Yu20040207/pathfinder_robot/firmware/esp32s3_motor_pulse/README.md

# D157B 单电机短脉冲验收

2026-10-16 重新装配后，用户在双轮 10 秒悬空测试中观察到左右轮均向后转。已把前进映射改为左轮 AIN1、右轮 BIN2；反向映射为左轮 AIN2、右轮 BIN1。方向单元测试、ESP-IDF 编译和烧录通过；在 12 V 断开时，串口 `x`、`z`、`r` 验证正常。以下 2026-10-15 的物理方向记录仅适用于重新装配前，不应再作为当前方向依据。

2026-10-16 新映射带电悬空 1 秒双轮前进测试已由用户确认两轮均向前并正常停下。三次重复测试的 4 倍频编码器计数：左轮 -1574/-1437/-1558，右轮 +1223/+1237/+1246，skipped 均为 0。单独左轮前进 500 ms 得到 A=-440、B=0；单独右轮反转 500 ms 得到 A=0、B=-433，skipped 均为 0。停机并清零后静置 3 秒，两路保持 0。当前前进计数符号为左负右正。重复测试计数差异反映开环 PWM 下转速/起转状态差异，不能据此断定左右轮机械性能。

2026-10-16 用户分别手动将轮胎朝前进方向转动一整圈：左轮 A=-1468、B=0，右轮 A=0、B=+1468；两次 skipped 均为 0。按当前接线和 4 倍频解码，实测每个驱动轮为 1468 计数/轮圈。前进方向的有符号轮圈数为左轮 `-A/1468`、右轮 `B/1468`。用户随后给出轮子周长约 210 mm、左右驱动轮中心距约 263 mm；以此作初始参数，每计数约 0.1431 mm。地面滚动有效周长和转弯等效轮距仍需行驶标定，不能直接作为精准里程计。再次拆装编码器线或更换减速电机后应复测计数方向和每圈计数。

反向手转各一整圈复核：左轮 A=+1451，右轮 B=-1464，skipped 均为 0。符号与前进相反；相对于 1468 计数/圈分别相差 17 和 4 个计数，属于手动停在标记位置的可见误差范围。当前两侧编码器通道、方向和每圈计数已完成悬空基础验证；地面滚动轮径、轮距、闭环速度控制和里程计仍未标定。

2026-10-15 悬空实测：`1`（Motor A，IN1，50% PWM，500 ms）使左轮后退；`3`（Motor B，IN1，50% PWM，500 ms）使右轮前进。两次测试的串口均打印 `STOP after 500 ms PWM diagnostic`，随后又发送了 `x` 停机命令。尚未验证反向控制、编码器反馈或负载下运行；后续控制映射应以机器人前进方向为准，不能把两侧同一 IN1 电平直接视为同一行驶方向。

方向测试固件新增 `5`（左轮 AIN2，50% PWM，500 ms）和 `6`（右轮 BIN2，50% PWM，500 ms）。两路 IN1/IN2 均由 PWM 通道控制；每次测试前后四路占空比全部清零。同一电机的 IN1 和 IN2 不会同时给出非零占空比。方向映射依据上述悬空观察，仍需用 `5`/`6` 实测复核。

2026-10-15 反向测试：`5` 已确认左轮向前转并正常停下；`6` 已确认右轮向后转并正常停下。串口均显示 500 ms 后停机。编码器尚未接线，GPIO8–11 为悬空输入，日志中出现的计数与 skipped 数字是噪声，不能用于轮速或方向判断。

新增 `t` 双轮前进悬空测试：左轮 AIN2、右轮 BIN1 同时以 10 kHz PWM 从 0 升至 50%，再降至 0，全程 4 秒；每 100 ms 更新一次，结束时四路控制输出清零。运行中发送 `x` 可在下一次 100 ms 更新时提前停机。2026-10-15 已在驱动板 12 V 关闭状态下验证完整运行约 4 秒和 `x` 提前停机约 0.1 秒；带电双轮实测另行记录。没有编码器反馈，因此这里的“加速/减速”仅指 PWM 占空比变化，不能保证轮速按相同比例变化。

2026-10-15 新增大写 `T`：相同的双轮前进渐变，时长延长至 15 秒，最高仍为 50% PWM，`x` 同样可提前停机。驱动板 12 V 关闭时的串口验证显示 15.00 秒自动停机。小写 `t` 保留为 4 秒版本。

带电悬空实测：`T` 的 0→50%→0 渐变中只有左轮起转；右轮单独 50% 的 500 ms 脉冲可以起转，双轮同时恒定 50% 的 1 秒诊断命令 `u` 也使两轮起转。说明缓慢爬升到 50% 不足以保证右轮从静止起转，不能把原 `T` 当作可靠的双轮起转测试。

新增大写 `V`：15 秒双轮测试，先以 50% PWM 保持 1 秒起转，然后在 1 秒内降到约 40%，用 12 秒在约 40%↔50% 间升降，最后 1 秒降到 0。驱动板 12 V 关闭时串口验证 15.00 秒自动停机；带电悬空实测中用户确认两轮持续向前转并正常停下。该结论仅适用于悬空样机；没有编码器、负载和电流数据，不能推断地面行驶速度、力矩或续航。

上电后四个控制输出保持低电平，不自动转动。USB 串口输入 `a` 或 `b`，分别对 Motor_A 或 Motor_B 的 IN1 给出一次 10 kHz、约 25% 占空比、5 秒 PWM，然后自动停机并等待至少一秒。IN2 始终为低电平。输入 `x` 会再次置零，但 5 秒运行期间主循环不处理新命令；异常时应直接切断电机电源。若 PWM 占空比较低而电机不转，不要持续重复命令或增加占空比，应先检查电源、接线与电机电流。

故障诊断命令 `c` / `d`：分别对 Motor_A / Motor_B 的 IN1 给出一次 500 ms 近似持续高电平（IN2 保持低电平），随后自动停机。用于与驱动板上手动将 AIN1/BIN1 接 3.3 V、AIN2/BIN2 接 GND 的测试对照。电机空载、输出轴无遮挡且供电可立即切断时才执行；每次只发送一次，不连续重复。

起步占空比诊断命令 `1`/`2` 对 Motor_A 的 AIN1 输出 50%/75%，`3`/`4` 对 Motor_B 的 BIN1 输出 50%/75%；`5` 对左轮 AIN2、`6` 对右轮 BIN2 输出 50%。均为 10 kHz、500 ms，随后自动停机。一次只测一档，观察轴上标记的转动与停止。该测试只能判断是否起转；未读取编码器，不能得出准确 RPM，也不能用于载车运行。

## 编码器测试预留（电平转换板到货后再烧录并接线）

D157B 的 E1A/E1B/E2A/E2B 实测有 4.9 V 高电平，**不能直接接 ESP32-S3 GPIO**。用户提供的商品图为一块四路 HV/LV 双向转换板（看起来是四路 MOSFET 加上拉电阻结构，商家标称最高稳定通信速率 28800 bps）；最终接线前以收到的实物丝印和万用表测量复核。HV 接 D157B 5V，LV 接 ESP32-S3 3V3，GND 与两板公共地连接；四路高压侧接编码器输出，配对的低压侧接 ESP32-S3 输入：

| D157B 信号 | 转换板通道 | ESP32-S3 输入 |
| --- | --- | --- |
| E1A | HV1→LV1 | GPIO8 |
| E1B | HV2→LV2 | GPIO9 |
| E2A | HV3→LV3 | GPIO10 |
| E2B | HV4→LV4 | GPIO11 |

通电时先不接四根 LV 输出到 ESP32，用万用表测转换板 LV 侧高电平不超过 3.3 V、低电平接近 0 V；确认后断电再接 GPIO。不要将 D157B 的 5V 接到 ESP32 的 3V3，也不要用转换板给电机供电。布线短、远离电机动力线。该类 MOSFET 转换板原本常用于 I²C 等信号；商家标称的 28800 bps 不能证明它在本机编码器线束下不会丢边沿。先手转、再悬空低速、最后在悬空最高测试转速检查计数与 skipped，若出现明显漏计或噪声，应换适合编码器脉冲的单向缓冲方案。

固件用 A/B 两相的每次有效跳变计数（4 倍频）；串口输入 `r` 显示 A/B 累积计数和跳变异常数，输入 `z` 清零。短脉冲后也会打印计数。正负号需按实际轮子安装方向标定。此阶段只验证脉冲和方向，尚未根据实际减速比、编码器 PPR 与轮径标定 RPM/里程计；不要把这些原始计数当作准确位移。

烧录时 D157B 电源断开、开关关闭；运行前车轮悬空、12 V 输入极性经过万用表核对，并可立即切断电源。ESP32-S3 USB 单独供电、两板共地。这个固件只做短时空载验收，没有编码器闭环和独立硬件急停，不能驱动车体在地面行走。

```bash
source /home/manbaout/esp/esp-idf/export.sh
idf.py set-target esp32s3 build
idf.py -p /dev/serial/by-id/usb-Espressif_USB_JTAG_serial_debug_unit_90:70:69:F7:F0:B0-if00 flash monitor
```

监视器打开后输入 `a` 或 `b` 并按回车；观察对应电机是否只转约 5 秒及串口的 `STOP after 5000 ms`。按 `Ctrl+]` 退出监视器。通电前先在电机电源断开的情况下验证程序会识别命令并自动停止。
