Yu20040207/pathfinder_robot/firmware/esp32s3_base_control/README.md

# ESP32-S3 悬空轮速闭环验收

此固件用于 D157B AT8236 驱动板与两个编码器驱动轮的悬空调试。旧的 `esp32s3_motor_pulse` 固件保留用于回退。60 mm/s 的前进和后退悬空闭环测试已通过；仍需下地负载标定，不接 Nav2。

## 已标定的接口

- GPIO4/5：左电机 AIN1/AIN2，AIN1 为前进。
- GPIO6/7：右电机 BIN1/BIN2，BIN2 为前进。
- GPIO8/9：左编码器 A/B；GPIO10/11：右编码器 A/B，经 3.3 V 电平转换接入。
- 前进时原始编码器左负右正，控制器内部统一转换为前进正速度。
- 初始周长 210 mm、每圈 1468 个 4 倍频计数；轮距 263 mm 在上位机里程计中使用。

## 控制和保护

独立 FreeRTOS 控制任务每 20 ms 采样编码器并更新 PWM。串口处理和日志不会主动阻塞该任务。轮速采用低通滤波、前馈加 PI；目标轮速限制为 ±100 mm/s，加速度限制 150 mm/s²，PWM 限制 50%。静止起步时最多给一次 200 ms、50% PWM 起转脉冲；编码器检测到轮速后提前退出。微小反向读数不再跳过起转脉冲。正常控制时 PWM 上升率限制 1/s、下降率限制 0.2/s；停机与故障直接清零。正反转切换先降至零，等待低速后再换向。

有效 `v` 命令超过 300 ms 未刷新时，关闭两路电机输出；`x` 和零速度命令在下一控制周期关闭输出。这里“停止”表示 PWM 清零、驱动输入低，车轮可能因惯性滑行，并不代表机械刹停。上电不运动。故障保持锁定，需要停止状态下显式 `c` 清除或重启后才能重新运行。

故障码：1 无脉冲（连续 `v` 轮速控制在 PWM≥30% 后约 0.45 s；诊断模式另有各自时限）；2 转向反馈反向超过约 0.2 s；3 测得轮速超过 300 mm/s 持续约 0.1 s；4 单周期超过 8 次无效编码器跳变；5 控制周期异常（运动时周期大于 100 ms）；6 跟踪偏差。这些阈值是初始值，仍需带载实测。软件保护不替代电源开关/独立硬件急停，也不包含电流、温度检测；控制任务自身停滞或 MCU 硬件故障仍需硬件切断电机供电。

## 串口协议

115200、8N1、USB Serial/JTAG。新固件先发送 `?`，必须读到 `BASE_CONTROL_V2` 才能由实机桥接发送速度数字；旧脉冲固件会把数字当作原始 PWM 命令。兼容的 `bench.py` 也识别历史 V1 固件。新 `S2` 状态行包含 ESP 单调微秒、两轮计数与跳变数、速度、目标、PWM、运动位和故障码；旧 `S` 行暂保留给已有诊断脚本。

- `v 60 60\n`：左右轮目标各 +60 mm/s，需要持续刷新，推荐 10 Hz。
- `v -40 -40\n`：左右轮目标各 -40 mm/s。
- `x`：停止，无需换行。
- `c`：仅在停止状态清除故障，不会自动启动。
- `s`：输出状态；默认也每 100 ms 输出状态。
- `r`：兼容只读 `/wheel/odom` 节点的编码器报告。

状态格式：`S uptime_us raw_left raw_right measured_left_mm_s measured_right_mm_s setpoint_left setpoint_right pwm_left pwm_right active fault`。

超出范围、非有限数、格式错误命令均不启动电机；输入行超过 79 字节或组帧超过 200 ms 时停止并丢弃到下一行。不要同时运行串口监视器、轮式里程计节点和测试脚本。

## 构建与有界测试

烧录时先断开驱动板 12 V，仅保留控制器 USB 供电。

```bash
source /home/manbaout/esp/esp-idf/export.sh
idf.py -C firmware/esp32s3_base_control build
idf.py -C firmware/esp32s3_base_control -p /dev/serial/by-id/usb-Espressif_USB_JTAG_serial_debug_unit_90:70:69:F7:F0:B0-if00 flash
```

在项目根目录运行，默认 `inspect` 只验证版本和停止状态。`run` 会发出运动命令，须先确认车轮悬空且可立即断电。

```bash
python3 firmware/esp32s3_base_control/tools/bench.py --action inspect
python3 firmware/esp32s3_base_control/tools/bench.py --action run --left 60 --right 60 --seconds 3 --csv /tmp/base-forward.csv
python3 firmware/esp32s3_base_control/tools/bench.py --action timeout --left 60 --right 60 --seconds 1 --csv /tmp/base-timeout.csv
```

脚本限制持续时间为 0.1–10 秒，结束后检查 `active=0` 且 PWM=0；`timeout` 模式在运行阶段结束后停止刷新指令，以验证控制器自行超时关闭输出。脚本异常退出时发送 `x`，遥测超过 0.5 秒无响应时中止。CSV 保存本次状态用于调参。新固件版本识别失败时不会发送速度命令。

测试核心：

```bash
cc -std=c11 -Wall -Wextra -Werror -I firmware/esp32s3_base_control/main firmware/esp32s3_base_control/tests/test_control.c firmware/esp32s3_base_control/main/control.c firmware/esp32s3_base_control/main/protocol.c -lm -o /tmp/fwr_base_test
/tmp/fwr_base_test
```

## 2026-10-16 验证进度

- 主机控制核心测试通过，含不同电机增益的简化闭环仿真、速度限制、立即停止、超时关闭、无反馈锁定、方向错误、超速、无效边沿和控制时序异常。该模型测试不代表实际电机已完成调参。
- ESP-IDF 构建和烧录通过；用户已确认烧录时驱动板 12 V 关闭。
- 实机无电机供电：启动与查询均 PWM=0、active=0、fault=0；停止刷新短速度指令后 active 和两路 PWM 归零。
- 实机无电机供电：持续给速度指令时触发 fault=1（无脉冲），两路 PWM=0；随后查询仍保持故障锁定，显式清除后恢复停止状态。
- 实机无电机供电：`x`、`v nan 0`、`v 101 0` 均验证输出关闭。
- 首次带电 60 mm/s 测试中，两轮实际未起转，遥测两侧计数基本不变；控制器在约 1 秒时锁定故障 1 并使两路 PWM 归零。用户确认两轮未转。旧诊断固件的瞬时 50% PWM 曾使两轮起转，因此增加有界起转脉冲。
- 起转脉冲版主机测试、构建、烧录及无 12 V 的超时停机测试通过；带电效果尚待确认。闭环跟踪、反向控制和带电超时关闭未完成；目前不进行下地测试。
- 起转脉冲版第二次带电 60 mm/s 测试：右编码器从 -2 增至 +275，右轮速度约 50 mm/s；左编码器仅从 +1 到 -17 后保持不变。左轮 PWM 后续达到 50%，约 1.6 秒时 fault=1 锁定且两路输出归零。需要区分左电机未转、机械卡滞或电连接问题；未验证双轮稳定闭环。
- 用户要求复测后，在同样 60 mm/s、2 秒上限条件下再次观察到：左计数 -18 到 -86 后停止，右计数 +279 到 +491；左 PWM 后续约 49.5% 时仍无计数，故障 1 再次锁定并停止两路。CSV：`/tmp/fwr-base-powered-boost-repeat-60.csv`。重复故障需要检查左轮实际运动、机械阻力、电机供电和编码器接线，不应继续反复加电尝试。
- 对照厂商《电机驱动模块使用手册—AT8236》（2025-08-27）：D157B 的 AT8236 VREF 接板上 3.3 V；`PWM,0` 是支持的正转快衰减控制；手册推荐 PWM 10 kHz，当前程序即 10 kHz。板上电机供电标称 5.5–17 V，12 V 在范围内。两轮最终一同停下是故障保护动作，不能由此推断两侧驱动芯片同时失效。下一步先断电比较两轮机械阻力和左侧连接，再做有界单轮诊断。
- 断电后临时烧录旧短脉冲程序，左轮前进 50% PWM 运行 0.5 秒：左编码器 -297，右 0，无无效跳变。左电机及编码器在固定 PWM 下正常。闭环失速更可能是控制输出快速下降及电机起转/维持转动阈值造成。
- 曾按手册尝试慢衰减接法；一次带电 60 mm/s 测试中右轮测得约 400 mm/s，约 0.3 秒触发超速故障 3，两路输出归零。该模式已从代码撤回，待断电后重新烧录快衰减版本。CSV：`/tmp/fwr-base-slow-powered-60.csv`。
- 已恢复快衰减接法。修复原代码用微小反向编码器噪声判定“正在倒转”并跳过左轮起转脉冲的问题；新测试中左右轮都以 50% PWM 起转。但在 80 mm/s、1.5 秒测试中，输出快速降至约 28% 后两轮速度明显下降，尚未稳定。现将正常控制的 PWM 下降率从 1/s 调整为 0.2/s；主机测试、烧录及无电机供电的超时停机验证通过，带电验证待完成。
- PWM 下降率调整后的 80 mm/s 带电测试中，两路 PWM 均达到 50%，但原始编码器计数从 0 到 0，约 0.8 秒后故障 1 自动停机。该结果与之前两轮能起转不一致。下一步先用万用表直接在 D157B 的 VIN+/VIN− 端子确认电机电源，不应继续凭软件遥测假定驱动板已供电。CSV：`/tmp/fwr-base-slowdown-powered-80.csv`。
- 用户确认该次两轮零计数测试时驱动板实际未接电；万用表之后确认 VIN+/VIN− 约 12 V。供电确认后的 80 mm/s、3 秒悬空测试两轮持续运动、无故障并正常停机；带电断联测试也确认超时关断。
- 60 mm/s 悬空测试曾有约 15–100 mm/s 的振荡，因此将前馈改为 `0.22+0.0017*目标速度(mm/s)`、比例系数改为 0.0012、积分系数改为 0.0015。新固件主机测试、ESP-IDF 构建和烧录通过。
- 新参数在 VIN+/VIN− 实测约 12 V 下：前进 60 mm/s 持续 5 秒，最后 10 个运动采样平均左 59.39、右 59.78 mm/s，标准差分别 1.92 和 0.68 mm/s，故障 0，停止后 PWM 0。CSV：`/tmp/fwr-base-gain-powered-60.csv`。
- 后退 60 mm/s 持续 5 秒，最后 10 个运动采样平均左 -59.76、右 -59.84 mm/s；一前一后原地转向 3 秒成功；带电停止刷新指令的超时停机测试通过，最终两路 PWM 0、故障 0。CSV 分别是 `/tmp/fwr-base-gain-powered-reverse-60.csv`、`/tmp/fwr-base-gain-powered-turn-60.csv`、`/tmp/fwr-base-gain-powered-timeout-60.csv`。这些是双轮悬空结果，不代表下地后仍有相同速度精度。
- 用户要求再试方向后，前进 60 mm/s 首段故障：右轮正常计数，左轮在约 0.8 秒内无计数，左 PWM 至约 50%，保护停机。随后的左轮单独 60 mm/s 测试也基本无计数并触发故障 1。CSV：`/tmp/fwr-base-confirm-forward.csv`、`/tmp/fwr-base-left-only-60.csv`。因此左侧故障具有间歇性，之前的成功不能视作可靠验收；已停止继续电机测试，优先断电检查左电机 6 针插头、电机线和 A 路连接。
- 用户未发现插头明显松动，随后断电临时烧录固定 PWM 诊断程序；确认 VIN+/VIN− 约 12 V 后再次仅驱动左轮 50% PWM、0.5 秒，编码器 A=-92、B=+2、无跳变，与先前同样测试的 A=-297 差异明显。当前设备运行临时诊断固件 `esp32s3_motor_pulse`；尚需根据目视动作和进一步电气检查确认左轮原因，并在完成后断电恢复 `esp32s3_base_control`。
- 用户断开 12 V 与 USB 后，将两只已标记的 6 针电机插头在 Motor_A/Motor_B 之间互换，重新接 USB 并实测 VIN+/VIN− 约 12 V。临时诊断固件对 A 路执行 50% PWM、0.5 秒，编码器 A=-409、B=0；对 B 路同样执行，编码器 A=0、B=-421。互换后的两条驱动路径均能驱动所接电机并获得编码器计数。
- 用户断电并将标记的插头恢复原位，重新测得 VIN+/VIN− 约 12 V。A 路 50% PWM、0.5 秒首次计数 A=-440；随后三次计数分别为 -383、-411、-458，B=0，均自动停机。插拔后左侧表现改善，支持接插件接触问题的可能性，但尚不能确认根因；还需恢复闭环固件并进行带失速保护的短时复测。
- 已在 12 V 关闭时重新烧录 `esp32s3_base_control`；无电机供电查询得到 active=0、PWM=0、fault=0。恢复供电并实测 VIN+/VIN− 约 12 V 后，连续三次双轮前进 60 mm/s、2 秒，以及一次 60 mm/s、5 秒悬空测试均 fault=0，测试后输出归零。5 秒测试末段均值左 59.33、右 58.53 mm/s。CSV：`/tmp/fwr-base-reseat-forward-{1,2,3}.csv`、`/tmp/fwr-base-reseat-forward-5s.csv`。当前烧录固件是闭环 `esp32s3_base_control`。先前左轮间歇性无计数未再现，但尚不能确定是插头接触还是其它原因；这些结果仅用于悬空验证。
- 首次下地 60 mm/s、1 秒测试中两轮没有移动，左计数不变、右计数仅增加 4；约 0.8 秒触发失速故障 1，输出自动归零。用户随后实测 VIN+/VIN− 约 12 V。重新将双轮悬空、清故障后相同测试中右计数从 -18 增至 +445、左计数始终为 9，约 0.8 秒再次触发失速故障 1。这表明左侧间歇性无运动/无编码器反馈再次出现，下地负载不是唯一原因。CSV：`/tmp/fwr-ground-first-forward.csv`、`/tmp/fwr-ground-recheck-air.csv`。用户已关闭 12 V 并检查压紧左轮 6 针插头，未发现明显松脱；在故障定位前不要继续下地测试。
- 断电测电机两端电阻：用户报告左 15.7 Ω、右 10 Ω；未提供转动一圈时的电阻范围，单次差异不能确认故障。用户将两只电机插头恢复原位。先在驱动板 12 V 关闭时手转左轮，编码器不变；万用表确认板上 3.3 V 当时为 0，故该次手转不具诊断意义。重新接通 12 V、板上 3.3 V 正常后，手转左轮一圈，计数从 10 到 -2174，表明编码器在当时能工作。随后两次 60 mm/s、1 秒悬空测试左右均计数、无故障。CSV：`/tmp/fwr-air-after-handturn.csv`、`/tmp/fwr-air-after-handturn-repeat.csv`。
- 再次下地 60 mm/s、1 秒测试 fault=0，但左右仅短暂有少量计数，之后均停止；用户看到整车不移动，仅听到电流声。控制器记录起转时约 50% PWM，之后 42–45% PWM，末段实测轮速接近 0。CSV：`/tmp/fwr-ground-second-forward.csv`。目前需核对实物电机额定电压/型号、12 V 带载电压和机械阻力。项目旧选型文档记录 24 V 电机，但尚未确认当前实物是否该型号；不能在当前 D157B 上擅自提高供电电压。下地测试尚未通过。
- 用户提供《轮趣直流有刷电机产品说明手册（尺寸、参数、线序）_2026.07.28-1.pdf》并确认实物型号 MG513X。手册表 2-1：MG513X 为 12 V、1:28、额定 0.36 A、堵转 3.2 A、额定扭矩 1.02 kg·cm、堵转扭矩 4.5 kg·cm、4 W；MG513XL 是另一款 12 V、额定 1 A、额定扭矩 3 kg·cm 的电机。故上条旧选型文档的 24 V 假设不适用于当前实物。当前 12 V 是正确的额定电压；50% PWM 起转限制、带载电压跌落、脚轮/底盘阻力和左侧间歇性故障仍需分别核查。
- 使用临时短脉冲固件在地面分别给 Motor_A、Motor_B 75% PWM、0.5 秒：A 编码器 -913、B 被动 +179，用户确认车身向右转；B 编码器 -1396，用户确认车身转动且无异常。因此两只电机在地面负载下均有能力驱动车身；无法将先前不动直接归因于电机损坏。
- 第一版闭环起步直接施加 75% PWM，悬空 0.5 秒测试约 0.3 秒触发超速故障 3，记录左右最高约 469/410 mm/s，保护停车。已改为从 50% 起在尚未达到 15 mm/s 时逐步升至最多 75%，主机测试、构建、烧录通过。悬空 0.5 秒及 2 秒测试 fault=0、最终 PWM=0。CSV：`/tmp/fwr-boost75-air-05.csv`、`/tmp/fwr-adaptive75-air-05.csv`、`/tmp/fwr-adaptive75-air-2s.csv`。
- 渐增起步版地面 60 mm/s、1 秒测试两轮计数、车身前进略有跑偏、fault=0；2 秒测试中约 1.3 秒后两轮停住，用户确认先走后停。100 mm/s、2 秒测试同样先走后停。记录显示 PWM 降到约 40% 后速度骤降，之后提升 PWM 太慢，尽管 fault=0，地面持续行驶仍未通过。CSV：`/tmp/fwr-adaptive75-ground-1s.csv`、`/tmp/fwr-adaptive75-ground-2s.csv`、`/tmp/fwr-adaptive75-ground-100-2s.csv`。
- 针对上述现象，控制逻辑改为实际速度低于目标时不再继续降低 PWM，并在速度误差超过 20 mm/s 时加快 PWM 回升。主机测试先验证旧逻辑失败，随后新逻辑通过；ESP-IDF 构建通过。**截至此条记录，新版本尚未烧录，设备仍运行上一版渐增起步固件。**下一步在 12 V 关闭时烧录，然后悬空与地面短测。
- 用户明确要求保持 12 V 接通烧录。烧录前确认 active=0、PWM=0、fault=0，带电烧录成功；重启后再次确认三者均为 0。新逻辑地面 60 mm/s、1 秒测试两轮计数接近（左约 -1054、右约 +1040），fault=0、输出归零；2 秒测试仍在约 1.2 秒后停止，PWM 降至左 38.4%、右 39.6% 时两轮低于目标且继续减速，随后保持/提高 PWM 未能及时重新起转。CSV：`/tmp/fwr-hold-duty-ground-1s.csv`、`/tmp/fwr-hold-duty-ground-2s.csv`。因此新版本已烧录但**地面持续低速运行未通过**，不能用于自主导航。需要验证较高的可持续目标速度或调整电机/驱动配置，避免继续在当前 60 mm/s 条件下重复测试。
- 同一固件地面 100 mm/s、2 秒测试仍先走后停，左、右轮在 PWM 降到约 40% 后速度持续下降；PWM 回升到约 56% 时也未恢复。用户观察车身稍向右偏。CSV：`/tmp/fwr-hold-duty-ground-100-2s.csv`。
- 2026-10-17：增加仅前进的固定占空比诊断命令 `d L R`（0–0.65），保留失速、反向、超速、编码器、通信超时和立即停机保护；测试脚本限制该模式最长 2 秒。主机测试和 ESP-IDF 构建通过，已烧录，重启后确认停机、故障码 0。地面 50%、1 秒诊断首次仅有少量计数随后失速故障 1；重复时两轮计数完全不变，再次故障 1。地面 65%、1 秒诊断两轮持续计数，左轮速度一度超过 300 mm/s 保护线，在约 0.9 秒触发超速故障 3 并停机。CSV：`/tmp/fwr-ground-fixed-050.csv`、`/tmp/fwr-ground-fixed-050-repeat.csv`、`/tmp/fwr-ground-fixed-065.csv`。当前控制器**停机且故障锁定 3**；不要直接用此参数导航。
- 用户固定 2.5 kg 配重后，清除故障并完成地面 60% 固定 PWM、1 秒短测：两轮速度逐步升到约 125 mm/s，计数接近，fault=0，结束后输出为 0。CSV：`/tmp/fwr-ground-ballast-2500g-fixed-060.csv`。这只证明一次短时直行可带动当前配重；尚未验证 2 秒以上持续运行、转向、坡道、带载电压和整机总质量。当前固件停机且故障码 0。不要将固定 PWM 诊断命令用于导航。
- 同样 2.5 kg 配重和 60% 固定 PWM 再做 1 秒，用户确认持续前进并正常停下，fault=0；随后做 2 秒测试，末段左右速度约 130 mm/s 且相近，结束后 active=0、两路 PWM=0、fault=0。CSV：`/tmp/fwr-ground-ballast-2500g-fixed-060-repeat.csv`、`/tmp/fwr-ground-ballast-2500g-fixed-060-2s.csv`。2 秒测试的车身动作仍待用户确认；尚未验证闭环控制、转向、长期运行、温升、满载与坡道。
- 同条件 2 秒再次测试，末段两轮约 145–150 mm/s、fault=0、停机输出归零；用户确认车身持续前进并正常停下。CSV：`/tmp/fwr-ground-ballast-2500g-fixed-060-2s-repeat.csv`。因此 2.5 kg 附加配重的短时固定 PWM 直行已通过，但闭环低速、带载转向、长时间运行及最终整机重量尚未验证。
- 2.5 kg 配重、左右固定 PWM 55%/60%、1 秒低幅度转向诊断：两轮均持续计数、fault=0、按时停机；但末段左轮约 115 mm/s、右轮约 96 mm/s，右轮给更高 PWM 却比左轮慢，不能据此认为预期转向已通过。CSV：`/tmp/fwr-ground-ballast-2500g-turn-055-060.csv`。等待用户确认实际车身转向与打滑情况，再排查左右负载/输出差异。
- 用户观察上次车身轻微向右转，与左轮更快一致。反向对照 60%/55%、1 秒时左轮持续约 120–130 mm/s，右轮 55% 仅零星计数、接近静止；fault=0、按时停机。CSV：`/tmp/fwr-ground-ballast-2500g-turn-060-055.csv`。说明右侧在 2.5 kg 配重下 55% 固定 PWM 不足以持续转动，固定 PWM 差速转向尚不可靠。故障码 0 不代表动作符合命令；用户车身观察待确认。
- 用户确认 60%/55% 这次车身明显向右转，符合左轮持续推动、右轮几乎不动的编码器记录。接下来应把左右轮均维持在能可靠转动的占空比范围，通过更高一侧形成速度差，并同时验证闭环速度与停滞检测；在完成之前不启用自主导航。
- 2.5 kg 配重下的对称差速诊断：左/右 PWM 60%/65%、1 秒，两轮均持续转动，末段左约 135、右约 181 mm/s，用户确认向左转且正常停下；左/右 65%/60%、1 秒，两轮均持续转动，末段左约 193、右约 158 mm/s，fault=0、自动停机，用户车身观察待确认。CSV：`/tmp/fwr-ground-ballast-2500g-turn-060-065.csv`、`/tmp/fwr-ground-ballast-2500g-turn-065-060.csv`。这支持在当前配重下两侧输出都保持约 60% 以上时形成左右速度差，但并不代表闭环或更重整机已通过。
- 用户确认 65%/60% 为大半径轻微右转，符合左右速度差约 35 mm/s。经用户确认方案，新增独立的带载诊断闭环命令 `b L R`（仅前进，150–200 mm/s，PWM 限在 60%–65%，不改变原 `v` 导航命令），并增加低轮速停滞保护。主机测试、ESP-IDF 构建与烧录通过；首次 160/160 mm/s、1 秒地面测试两轮计数几乎相同、fault=0，用户确认持续前进且正常停下。CSV：`/tmp/fwr-ground-ballast-2500g-loaded-160-160-1s.csv`。
- 同一诊断模式 150/190 mm/s、1 秒预期左转测试中，左右轮实际速度几乎相等（末段约 195/193 mm/s），用户确认车身基本直行，故闭环转向**未通过**。左轮 60% 最低输出仍使其高于 150 mm/s 目标，说明当前起转下限阻止该模式实现小半径转向。CSV：`/tmp/fwr-ground-ballast-2500g-loaded-150-190-1s.csv`。随后增加 `BASE_TRACKING=6`：带载模式在起步宽限后持续偏离目标超过 40 mm/s 达 0.4 秒就锁定故障并停机，主机测试先失败后通过、ESP-IDF 构建和烧录通过，重启后确认 active=0、PWM=0、fault=0。此安全修正尚未再次做带电测试。当前 `b` 仅为诊断，不用于导航；完整闭环转向尚未实现。
- 2.5 kg 配重下复测 `b 150 190` 验证跟踪保护：两轮实际速度仍接近，约 0.7 秒触发故障码 6、active=0、两路 PWM=0；复查仍保持故障锁定。CSV：`/tmp/fwr-ground-ballast-2500g-loaded-150-190-tracking.csv`。该保护已在实机验证，但转向能力没有改善。当前设备停机且故障锁定 6；在确定整机重量与硬件方案前不继续自动导航测试。
- 用户决定先实现当前硬件功能、暂缓整机重量选型。新增独立的 `a D` 速度差转向诊断（D=右轮减左轮速度，限 ±50 mm/s）：慢侧保持 60% PWM，快侧由编码器速度差反馈在 60%–65% 间调节；持续接近零轮速、错误方向、超速、速度差跟踪失败、通信超时均停机。原 `v` 和 `b` 命令未改。主机测试覆盖左/右转方向、无响应时跟踪故障、响应模型、立即停机和协议解析；ESP-IDF 构建、烧录通过，重启后 active=0、PWM=0、fault=0。**实车转向效果尚未验证**，当前 `a` 仅为诊断命令，不用于导航。
- 2.5 kg 配重下 `a 35`、1 秒测试：末段右轮约 246、左轮约 218 mm/s，速度差约 28 mm/s、fault=0、正常停机；用户观察车身基本直行。当前速度差只能形成大半径弧线，不能满足狭窄空间内转向。CSV：`/tmp/fwr-ground-ballast-2500g-arc-plus35-1s.csv`。
- 为探测较小半径转向，固定 PWM 左 0%、右 60%、0.5 秒：右轮仅少量计数、左轮 0，用户观察车身稍微左转；fault=0、正常停机。CSV：`/tmp/fwr-ground-ballast-2500g-coast-left-060right-05s.csv`。单侧推动车身在当前配重下效果很弱，不应继续以接近堵转的方式加长试验。复查 active=0、两路 PWM=0、fault=0。当前硬件下短时直行和大半径轻微转向可实现；小半径/原地转向及导航尚未通过。
- 2.5 kg 配重、地面、现有 `v` 闭环指令进行左右各 0.5 秒双轮反向测试。左转命令左 -100、右 +100 mm/s：用户确认明显左转且无异常，但左轮仅 +22 编码器计数（倒转速度末段约 -8 mm/s），右轮 +449 计数；左轮倒转近乎停滞，这**不是**可靠的双轮原地转向。右转命令左 +100、右 -100 mm/s：用户确认明显右转并正常停下；两轮分别 -520、-250 计数，末段约 +92/-85 mm/s。两次均按时停机、fault=0。CSV：`/tmp/fwr-ground-ballast-2500g-counterrotate-100-05s.csv`、`/tmp/fwr-ground-ballast-2500g-counterrotate-right-100-05s.csv`。左轮倒转受载异常需进一步定位；不应据此开放自主导航。
- 将双轮架空、保持配重与接线不变，重复左 -100、右 +100 mm/s、0.5 秒：末段左轮约 -150、右轮约 +130 mm/s，左右均正常计数并按时停机，fault=0。CSV：`/tmp/fwr-suspended-ballast-counterrotate-left-100-05s.csv`。因此左轮倒转的控制通道与编码器在空载时可工作；地面左轮倒转近停滞更可能与落地负载、轮胎摩擦、重心或机械干涉相关。不能仅凭本次定位到具体硬件根因；下一步在断开运动命令的条件下检查左轮周边是否蹭壳，以及四轮着地和配重分布。
- 静止检查中用户未见左轮蹭壳、线束干涉，手推左右阻力相近。随后 2.5 kg 配重地面双轮后退各 0.5 秒两次：第一次末段左/右约 -81/-81 mm/s，第二次约 -53/-54 mm/s；fault=0、自动停机。用户确认第二次车身实际后退，但底盘向右摆。CSV：`/tmp/fwr-ground-ballast-2500g-reverse-both-100-05s.csv`、`/tmp/fwr-ground-ballast-2500g-reverse-both-100-05s-repeat.csv`。因此左轮倒转并非在所有地面动作中失效，原地左转时的近停滞属于特定受载条件；右摆需结合 IMU 与地面轨迹进一步定量。
- IMU 固定后，在 2.5 kg 配重地面进行三次 0.5 秒后退联测，均自动停机、fault=0。左/右目标分别 -100/-100、-80/-100、-60/-100 mm/s；按 210 mm 周长、1468 计数/圈和 263 mm 轮距换算的编码器航向增量分别 +3.77°、+2.43°、+0.81°，IMU 四元数测得 +3.74°、+2.43°、+0.86°。第一次实际左/右位移约 -80.7/-63.4 mm，证明车尾右摆对应车头逆时针偏转，主要是两轮实际位移差；减小左轮倒退目标使短时偏摆减小。三组动作行驶距离不同，-60/-100 仅为临时诊断输入，还需在同一起始位置重复并记录视觉观察，不能直接作为长时闭环/导航参数。CSV：`/tmp/fwr-ground-reverse-imu-motor.csv`、`/tmp/fwr-ground-reverse-imu.csv`、`/tmp/fwr-ground-reverse-80-100-motor.csv`、`/tmp/fwr-ground-reverse-80-100-imu.csv`、`/tmp/fwr-ground-reverse-60-100-motor.csv`、`/tmp/fwr-ground-reverse-60-100-imu.csv`。
- 用户复位后重复 -60/-100 mm/s、0.5 秒，偏摆反向：IMU -2.60°、编码器按左右位移约 -71.4/-85.0 mm 换算 -2.96°，fault=0、自动停机。两次同命令实际 PWM/轮速不同，说明固定目标速度比例在当前起步阶段并不稳定，**不能把 -60/-100 作为补偿标定**。现有 `v` 控制以约 0.5–0.75 起转脉冲启动，目标速度以 150 mm/s² 爬升，PWM 下降限速 0.2/s 且低于目标时保持前次输出；短时 0.5 秒命令的实际速度主要受起转和地面摩擦支配。下一步应采用编码器同步的带载短时诊断，IMU 用于独立验证航向，不继续猜固定左右目标比例。CSV：`/tmp/fwr-ground-reverse-60-100-repeat-motor.csv`、`/tmp/fwr-ground-reverse-60-100-repeat-imu.csv`。
- 新增独立诊断指令 `y -1`（后退）或 `y 1`（前进）：两轮从 60% PWM 起步，仅按编码器测得的轮速差提高较慢一侧，最高 65%。指令需持续刷新，300 ms 未刷新即两轮停机；保留编码器异常、失速、反向、超速及跟踪偏差故障锁定。`bench.py --action sync --direction -1 --seconds 0.5 --csv ...` 提供最多 1 秒的自动停机测试。该模式不接入导航，实际地面效果还需 IMU 联测验证。
- 首次悬空 `y -1`、0.5 秒：自动停机、fault=0，但右轮平均后退速度约 186 mm/s、左轮约 170 mm/s，左轮补偿未追平。首次地面 0.5 秒：IMU 航向约 -1.72°，编码器位移左 -25.2、右 -33.9 mm，推算约 -1.90°；按时停机、fault=0。将同步比例系数从 0.0005 提至 0.002 后重复地面 0.5 秒：IMU -2.26°，编码器左 -41.6、右 -53.5 mm，推算 -2.59°；左 PWM 最后约 63.8%、右 60%，偏差未改善。当前证据不支持把该模式用于导航；两次距离、摩擦及起步状态也不同，不能把增益变化视为唯一原因。CSV：`/tmp/fwr-sync-reverse-suspended-05s.csv`、`/tmp/fwr-sync-reverse-ground-05s.csv`、`/tmp/fwr-sync-reverse-ground-gain2-05s.csv`。
- 同一增益、地面 1 秒后退：IMU 约 -3.48°，编码器从首个采样到完全停止的位移左约 -142.5、右约 -159.8 mm，推算航向约 -3.77°。后半秒左右位移差继续扩大；左 PWM 最后约 63.5%、右 60%，未出现故障并按时停机。偏差不只是起步瞬间；在 60%–65% 的同步诊断范围内无法可靠追平左轮，仍须检查负载与更宽输出范围的风险，再决定下一版控制。CSV：`/tmp/fwr-sync-reverse-ground-gain2-1s.csv`。
- 经用户确认，把独立 `y +/-1` 诊断模式改为按两轮**累计编码器位移差**补偿：较慢轮可在 60%–75% PWM 之间以最高 0.5/s 的变化率提高，较快轮至少保持 60%。仍需 300 ms 刷新指令，保留失速、反向、超速、编码器异常、持续跟踪偏差和立即停机保护。已通过主机控制测试、ESP-IDF 构建及烧录；烧录后停机且 fault=0。悬空和地面实测待完成，不能据此启用导航。
- 累计位移差版 `y -1` 首次悬空 0.5 秒：最后运动采样 PWM 左约 63.3%、右 60%，轮速左约 -289、右 -299 mm/s；自动停机、fault=0。悬空末段速度接近超速保护阈值，不延长此类悬空动作。地面首次 0.5 秒：IMU 航向 +0.63°，编码器从首个采样到停止左约 -53.5、右约 -50.5 mm，推算 +0.65°；右轮因落后得到最高约 61.9% PWM，自动停机、fault=0。相较旧版前两次 0.5 秒的负偏航更接近直行，但方向转成轻微左偏，仅一次实测不能证明可重复或可用于导航。CSV：`/tmp/fwr-sync-distance-suspended-05s.csv`、`/tmp/fwr-sync-distance-ground-05s.csv`。
- 用户复位后重复同固件地面 0.5 秒：IMU +1.34°，编码器左约 -52.2、右约 -45.5 mm，推算 +1.46°；右轮 PWM 最后约 63.4%，fault=0、按时停机。用户确认上一次后退基本直行且无异常。这两次均有轻微左偏，仍需判断更长的有界动作中补偿是否收敛；不能据此启用导航。CSV：`/tmp/fwr-sync-distance-ground-05s-repeat.csv`。
- 同固件地面 1 秒后退：IMU 航向 -0.52°，编码器总位移左约 -119.7、右约 -123.1 mm，推算 -0.75°；诊断 PWM 先补右轮、随后补左轮，停止后两路输出 0、fault=0。比旧版 1 秒约 -3.48° 更接近直行，但仍只证明当前配重及地面上的限时后退，不等于前进、转向或 Nav2 导航已验证。CSV：`/tmp/fwr-sync-distance-ground-1s.csv`。
- 同模式地面前进 0.5 秒两次：首次 IMU +0.65°、编码器约 +0.78°；用户目视确认持续前进、基本直行、正常停下且无异常。用户要求立即再试一次，IMU -0.30°、编码器约 -0.19°；两次都自动停机、fault=0。仅为短时前进诊断，不能推断负载变化后的持续巡航精度。CSV：`/tmp/fwr-sync-distance-forward-ground-05s.csv`、`/tmp/fwr-sync-distance-forward-ground-05s-repeat.csv`。
- 新增独立原地转向诊断 `t 1`（左转：左轮后退、右轮前进）和 `t -1`（右转：左轮前进、右轮后退）。两轮按各自运动方向的累计编码器位移同步，PWM 范围 60%–75%，需持续刷新；300 ms 未刷新停机，保留故障锁定。`bench.py --action turn --direction 1 --seconds 0.3 --csv ...` 将地面动作限制在 0.3 秒内。该模式未连接 Nav2。
- 转向悬空各 0.2 秒：左右电机方向正确、自动停机、fault=0。地面左转 0.2 秒首次 IMU +0.79°，重复仅 +0.04°且用户确认车身未动；延长至 0.3 秒仍仅 +0.01°、编码器无有效位移。地面右转 0.3 秒 IMU -4.69°、编码器有反向轮转动、fault=0。驱动板静止 VIN 实测 12.25 V。短时左转起转不可靠，不能将此诊断模式用于导航。记录：`/tmp/fwr-turn-left-ground-02s.csv`、`/tmp/fwr-turn-left-ground-02s-repeat.csv`、`/tmp/fwr-turn-left-ground-03s.csv`、`/tmp/fwr-turn-right-ground-03s.csv`。
- 转向联测暴露反向轮模式中的轮速比较符号错误：同向命令的测试原本覆盖不了相反轮速。新增等速反向轮测试，先复现跟踪故障，再按每轮目标方向计算速度并通过主机测试。重新构建、烧录并确认停机、fault=0。修正后再做 0.3 秒地面左转，IMU +2.04°、两轮有计数、自动停机、fault=0；这与先前两次不动形成起转重复性风险，尚未确认硬件或地面摩擦的根因。记录：`/tmp/fwr-turn-left-ground-postfix-03s.csv`。
- 经用户确认，`t +/-1` 诊断增加起转检查：150 ms 后某轮累计位移仍小于 0.5 mm，短暂将该轮提高到 75% PWM；350 ms 后仍未起步则锁定失速故障，转向位移差超过 8 mm 持续约 100 ms 则锁定跟踪故障，任何持续刷新的转向命令在 500 ms 时也会故障停机。仅 `t` 模式采用这些限制，直行 `y` 模式不变。主机测试覆盖单轮未起步、双轮未起步、等速反向轮和最长运行时间；ESP-IDF 构建、烧录、静止状态检查通过。
- 新版悬空左/右转各 0.2 秒：方向正确、自动停机、fault=0。2.5 kg 配重地面左转 0.4 秒两次，IMU 分别 +3.78°、+5.54°；右转 0.4 秒为 -10.93°；均自动停机、fault=0。两次左转都正常起步，未触发 75% 补偿，故地面尚未验证补偿能解决偶发不起步。相同时间内左右转角明显不对称；用户检查前方两只从动轮均可自由转向且无蹭碰，仍需比较轮胎受力、重心和负载下电机输出，不能据此启用导航。CSV：`/tmp/fwr-turn-boost-left-suspended-02s.csv`、`/tmp/fwr-turn-boost-right-suspended-02s.csv`、`/tmp/fwr-turn-boost-left-ground-04s.csv`、`/tmp/fwr-turn-boost-right-ground-04s.csv`、`/tmp/fwr-turn-boost-left-ground-04s-repeat.csv`。
- 万向轮朝向对照：两只均朝后时，同样 0.4 秒左转 IMU +1.10°、右转 -5.54°；两只均朝前时左转仅 +0.29°。方向一致仍有明显左右差异，不能把万向轮初始朝向认定为唯一原因。朝前左转日志显示轮子只短暂增加数个计数，随后停住；原起转检测只看累计位移，错误地将短暂颤动视为已起步。记录：`/tmp/fwr-turn-casters-back-left-04s.csv`、`/tmp/fwr-turn-casters-back-right-04s.csv`、`/tmp/fwr-turn-casters-forward-left-04s.csv`。
- 经用户确认，改用最近 5 个控制周期（约 100 ms）的轮子位移判断转向起步和失速；“先轻微动一下再停止”的主机回归测试先在旧逻辑下失败、修正后通过。重新构建烧录、悬空左右转各 0.2 秒均正常。地面左转 0.4 秒时左轮后退仅约 7 个原始计数，右轮前进约 31 个；左轮在 75% 补偿下仍停止，控制器锁定 fault=1，双路 PWM=0。IMU 净变化约 +0.95°。这证明失速保护能抓到症状，但未解决左转负载下的动力/阻力问题；不要自动清故障或把该模式接入导航。记录：`/tmp/fwr-turn-recent-left-suspended-02s.csv`、`/tmp/fwr-turn-recent-right-suspended-02s.csv`、`/tmp/fwr-turn-recent-left-ground-04s.csv`。
- 2026-10-20 对照：先在停机状态清除上次 fault=1，左轮单独后退 0.5 秒悬空测试连续两次有编码器计数（约 823、692 个），fault=0、停机后两路 PWM=0；同命令地面 0.3 秒左轮约 97 个计数，最高 PWM 67.5%。地面 `t 1` 左转 0.3 秒左轮后退约 32 个、右轮前进约 52 个原始计数，按 210 mm 周长和 263 mm 轮距推算约 +2.6°；`t -1` 右转 0.3 秒两轮约 113、114 个计数，推算约 -7.1°。两次转向均按时停机且 fault=0；该角度为编码器估算，未同步采集 IMU。左转时两轮均比右转慢，负载/接地条件差异仍未定位，实机键盘及 Nav2 运动门继续关闭。记录：`/tmp/fwr-left-reverse-air-2026-10-20.csv`、`/tmp/fwr-left-reverse-air-repeat-2026-10-20.csv`、`/tmp/fwr-left-reverse-ground-2026-10-20.csv`、`/tmp/fwr-left-turn-ground-2026-10-20.csv`、`/tmp/fwr-right-turn-ground-2026-10-20.csv`。
