Yu20040207/pathfinder_robot/docs/hardware/auto-mapping.md

# 自动探索建图试验说明

状态（2026-10-22）：**双 Collision Monitor 的前进、受限倒车及后侧近障阻断已通过无界面仿真；实机自动运动尚未验收，不能当作无人值守功能。** 已进行人工低速直行、零速停车及单个静止纸箱的前向近障停车测量，尚未运行自动探索命令。

## 工作原理与边界

C1 雷达提供原始 `/scan`。`scan_mapping_filter` 将车尾长期遮挡的原始 −90° 至 +90° 扇区置为 NaN，另发 `/scan_mapping` 给 SLAM Toolbox 和 Nav2 局部、全局代价图；该角度边界须在静止实测中复核。底盘雷达新鲜度门、方向选择器和两路 Collision Monitor 仍读原始 `/scan`。SLAM Toolbox 独占 `/map` 与 `map→odom`，前沿探索器只给 Nav2 发送已知空地中的目标。自动命令经前向或后向 Collision Monitor 和方向选择器后到达 `/cmd_vel_auto_safe`，底盘桥接只订阅这个安全出口；人工键盘另走 `/cmd_vel_manual`。原地转向须同时得到两路监控放行，任一路停车就归零。普通 Nav2 路径不允许倒车；车后遮挡长期存在，实车自动倒车保持关闭，未来增装后向超声波后再单独评估。

车后存在雷达盲区。`/scan_mapping` 被屏蔽的方向是未知区，不代表空地。过滤节点要求前左、正前、前右各 60° 扇区至少一半采样有效（含正常 `+Inf` 无回波）；低于此覆盖率时健康状态为假，自动运动预检拒绝放行。最近走过的路不是实时安全证明；人工键盘后退仍须有人持续目视车尾并能立即断开 12 V。禁止在有人可能突然进入、后方不可见或没有急停手段的场地启用倒车。不要把侧向扫描当作完整后向感知。首张实地图 `real_first_map` 含车体自回波造成的假障碍，仅留作诊断证据；重新建图并核对内部黑点前不用于自动导航验收。

## 接地前填写和检查

| 项目 | 当前配置 | 实测值（现场填写） |
|---|---:|---|
| 最大水平长度 | Nav2 footprint 600 mm；模型碰撞体 520 mm | 520 mm |
| 最大水平宽度 | Nav2 footprint 430 mm；模型碰撞体 350 mm | 350 mm |
| footprint padding | 20 mm | 核对模型 |
| 当前试验负载 | 2.5 kg 配重 | 核对固定 |
| 目标持续速度 | ≤0.06 m/s | 待带载长测 |
| 近障停车距离 | 前停止区距车头约 0.32 m | 单个静止纸箱触发停车后，车头到纸箱实测约 410 mm，里程计续行约 0.9 mm；动态障碍工况未测 |
| 倒车可见区域 | 部分侧后 | 现场检查盲区 |

实物尺寸超出配置值时先增大 Nav2 footprint 和前沿选择器占地范围。实测停车距离超过 0.30 m 时不得开启自动运动，先调整速度、停车区和硬件。检查雷达方向、IMU 固定、线束、驱动板供电、轮胎、前万向轮、场地边界。RViz 应能看到模型、`/scan`、`/map`、TF、局部代价图和碰撞监测区。

## 分阶段验收

1. 静态链路：保持 `motion_enabled=false`，核对 `/scan`、`/imu/data`、`/odom`、`/map`、`map→odom→base_footprint→laser_front`、`/base/fault=0`、Nav2 action 与前后两个 Collision Monitor lifecycle 均为 active，并确认 `/cmd_vel_auto_safe` 仅由 `directional_safety_selector` 发布。注入断流和故障时桥接必须归零。
2. 仿真：在独立 `ROS_DOMAIN_ID` 和 `IGN_PARTITION` 下验证地图增长、目标稳定、障碍前停车与重规划、人工停止；测试完成后确认无剩余速度。仿真启动检查脚本：`python3 scripts/check_auto_mapping_sim.py --domain 98`。
3. 实车单个前进目标：封闭场地、有人看护，已验证单个静止纸箱近障停车；仍须验证动态障碍停车、持续带载直行与目标重规划。目标失败后不得反复冲撞。
4. 受限倒车：车尾全程可见，先单段不超过 0.10 m，再累计不超过 0.30 m。放入新障碍、雷达断流或人为停止时应立即停机；记录实际后退距离和 IMU 偏航。
5. 小范围自动探索：限定约 120 秒和封闭区，监控目标切换、局部路径、故障码、编码器和停车距离。检查地图墙线、门口、障碍形状和轨迹后再考虑扩大区域。

每一步失败都停止升级，保留日志。整机增重、换地面或改变外廓后重新测起步与停距。

## 实车启动命令（尚未运行）

终端 A：

```bash
cd /home/manbaout/Company_Project/Four-wheel-robot
source /opt/ros/humble/setup.bash
source ros2_ws/install/setup.bash
ros2 launch fwr_bringup real_navigation.launch.py
```

终端 B，在测得外廓与停距、试验区封闭且有人持续看护后，填入**实际毫米值**：

```bash
cd /home/manbaout/Company_Project/Four-wheel-robot
./scripts/start_auto_mapping.sh --trial-area-confirmed <最大长度mm> <最大宽度mm> <停车距离mm>
```

启动脚本先保持运动门关闭、启动 Nav2 生命周期并读取雷达/IMU/里程计/地图时间戳、TF、碰撞监测状态、底盘故障和键盘控制状态；所有检查通过才打开运动门，调用 `/base/arm_auto`，然后显式调用 `/explore/start`。串口、传感器或安全指令中断后自动授权锁定关闭，必须重新预检和显式授权。Ctrl+C 或到达 125 秒时调用 `/explore/stop`、关闭运动门并保存时间戳地图到 `~/robot_maps/`。运行中遇到危险，直接切断电机 12 V，不等待脚本退出。

## 验证记录

- 2026-10-23：用户在封闭有人看护的区域完成约 2–3 m 的短距离键盘建图并按 Q 退出，反馈 RViz 行驶轨迹不再出现黑点。核对 `/base_bridge` 的 `motion_enabled=false`、`manual_enabled=false`、`/base/fault=0`、`/scan_mapping/healthy=true`。新地图保存为 `ros2_ws/src/fwr_bringup/maps/real_front_side_map_2026-10-23.yaml` 和同名 PGM（277×478 栅格，0.05 m/像素）；旧图 `real_first_map` 保留作为诊断对照。由于新旧地图范围不同，黑色像素总数不能直接作为质量指标。此项只验收车体回波过滤与人工建图；自动导航、动态障碍绕行与实机自动倒车仍需各自验收。

- 2026-10-23：前/左/右纸箱无动力核对完成，底盘运动门关闭。正前方纸箱在原始和过滤扫描中均为约 0.562 m、前方点数一致；左侧约 0.655 m、右侧约 0.608 m，过滤后最近距离均保持不变。后向车体遮挡回波在三个位置的过滤扫描中均为 0；过滤健康状态为真、底盘故障码 0。静态核对通过；尚须低速行驶重新建图，观察轨迹内黑点是否消失。

- 2026-10-22：人工键盘建成首张实地图并保存为 `ros2_ws/src/fwr_bringup/maps/real_first_map.yaml`（346×241，0.05 m/像素）。RViz 中行驶轨迹上出现断续黑色占据点；静止读取 21 帧 C1 扫描，在按实测雷达外参换算后的底盘 520×350 mm 范围内累计发现 2459 个有效回波，集中在雷达原始约 −40° 至 +40°、距离约 0.13 m 的车尾方向。雷达正在看到底盘自身或车载物并将其反复写进 SLAM 地图；这张图含假障碍，暂不可作为自动导航验收地图。物理清理扫描平面或为建图/代价图加入经验证的车体自遮挡过滤后须重新采图。安全监控仍应使用未经此过滤的原始雷达，后侧盲区不能据此视为可倒车。

- 2026-10-22：排查带载纸箱试验中“电机有声音但车不动”。在电机运动门关闭时记录发现 `/cmd_vel_auto_safe` 63 条中仅 30 条非零，重复指令与新雷达帧交错时被方向选择器交替归零。将相同指令的旧监控输出短暂保持条件改为最多 60 ms；监控明确停车、状态失效、指令变化或超时仍立即归零。修正后无动力记录为 39 条中 34 条非零；方向选择器相关 17 项测试通过。
- 2026-10-22：同一静止纸箱前约 0.567 m 雷达距离、2.5 kg 配重、0.10 m/s 指令的受看护限时短测：底盘行驶约 0.120 m，前向 Collision Monitor 持续停车，停机后里程计续行约 0.9 mm，雷达前方约 0.454 m，车头到纸箱实测约 410 mm，底盘故障码 0、软件运动门已关闭。该结果仅覆盖此次静态纸箱与当前负载；动态障碍停距尚未测量。
- 2026-10-22：首次实车移动纸箱试验。起始前方雷达约 4.77 m；纸箱从侧面拉入时，底盘已行驶约 0.097 m，雷达读数从约 2.54 m 快速跳到 0.195 m，测试脚本因过近立即发零速并关闭运动门；故障码 0，用户估计纸箱离车头约 200 mm。Collision Monitor 日志先报 `front_slow` 后报 `front_stop`；停机后的无动力复核中 `/cmd_vel_auto_safe` 为零。由于障碍物进入时已过近，无法区分监控停车与测试脚本急停的作用，也不能从本次数据推算动态制动距离。后续试验须让障碍物从至少 0.8 m 的前方距离进入并记录监控首次零速时刻，不得将本次记为动态避障通过。

- 2026-10-20：`colcon build --symlink-install --packages-select fwr_interfaces fwr_bringup` 成功。
- 2026-10-21：包测试 `118 passed`；`colcon build --symlink-install --packages-select fwr_interfaces fwr_bringup` 成功；`git diff --check` 与 Python 语法检查通过。
- 2026-10-20：独立域无界面主动探索仿真 10 秒：已知栅格 7423、雷达扫描 152 帧、Nav2 action 可用，底盘约移动 0.23 m，停止后状态 `stopped`，未授权运动为 0。日志：`/tmp/fwr_auto_sim_u7awm7pc.log`。此轮验证了初始探索与人工停止。
- 2026-10-21：仿真使用与实车相同的显式自动授权机制。扫描断流注入后授权锁定关闭、探索停止；恢复扫描不自动续行，日志：`/tmp/fwr_auto_sim_w9swhvsj.log`。
- 2026-10-21：正前方扫描障碍注入后 Collision Monitor 停车，最后一次非零运动指令约在注入后 0.099 秒；日志：`/tmp/fwr_auto_sim_7s0zxl88.log`。这只验证近障停车，未验证绕障重规划。
- 2026-10-21：纯逻辑测试覆盖倒车最多三段许可与累计 0.30 m 预算；尚未做 Gazebo 中的真实倒车轨迹联测。
- 2026-10-21：将虚拟正前方障碍保持 15 秒后仍未触发倒车，Collision Monitor 持续停车，探索状态没有进入 `reversing`；日志：`/tmp/fwr_auto_sim_2yok0847.log`。这不是倒车通过证据；需要单独构造 Nav2 失败且后方已知空闲的场景。
- 2026-10-21：查明 Collision Monitor 连续停车 1 秒后停止发布零速度，底盘命令看门狗因此撤销自动授权。将该停车零速度发布窗口设为 5 秒；仿真在近障保持 3 秒时仍处于授权导航和停车状态（`/tmp/fwr_auto_sim_152v97hl.log`），保持 7 秒则自动撤销授权并停机（`/tmp/fwr_auto_sim_cxwz6w3n.log`）。这为短暂障碍留出有限重规划时间，**尚未证实绕障成功**；正前方过近的障碍会触发固定停车区，不能仅靠增加等待时间绕过。
- 2026-10-21：补测近障保持 3 秒后移开，自动速度恢复输出（`/tmp/fwr_auto_sim_3y1t7y13.log`）；近障保持 7 秒则授权撤销且未自动恢复（`/tmp/fwr_auto_sim_w5xguqtl.log`）。前者只证明清障后继续运动，仍未证明障碍持续存在时能选另一条路。
- 2026-10-21：新增固定目标仿真入口，关闭随机前沿选择器，但保留自动命令门、Collision Monitor 和仿真底盘授权链。命令为 `python3 scripts/check_fixed_goal_reroute_sim.py --domain 145 --timeout 65 --obstacle-y=-0.42`。侧向障碍持续存在时，底盘从 x≈0.05 m 行至 x≈1.10 m，离障碍中心最近 0.652 m，高于保守阈值 0.599 m；期间产生 49 次新路径规划且保持授权（`/tmp/fwr_fixed_reroute_ygjug44a.log`）。同样目标下把障碍放在中心 y=0，则车只行至 x≈0.075 m，Nav2 15 秒后报无法取得进展并安全撤销授权（`/tmp/fwr_fixed_reroute_7cyx668z.log`）。因此仅证实**有足够侧向通道的绕行**，中心阻断仍需解决或判定为不可通行。
- 2026-10-21：修复自动命令门在状态切换时命令与时间戳不同步导致的空对象访问；前沿候选目标排除距车小于 0.50 m 的点，避免 Nav2 到点阈值引发重复派发；仿真进展检查与实机参数一致。仿真扫描断流及持续前障停车回归通过。
- 2026-10-21：倒车触发联测发现两处时间/轨迹问题：Nav2 允许 15 秒才判定失速，而原轨迹只保留 5 秒，Collision Monitor 原先只连续发布 5 秒停车零速度。轨迹保留窗改为 25 秒，停车零速度窗口改为 18 秒，以便失速判定期间仍保持停车和有限授权；超时后仍撤销授权。修复轨迹采样时小于 1 cm 的连续位移被覆盖、永远累计不到采样门槛的问题。复测中 Nav2 已进入恢复决策，但注入的前障碍使已走轨迹的车体扫掠范围不再是实时已知空闲，恢复器拒绝倒车（`/tmp/fwr_auto_sim_gykrsij3.log`，10 个轨迹点）；这**不是倒车成功验证**。此前 7 秒障碍会撤销授权的结果适用于旧 5 秒窗口，不能套用于现配置。实机必须重新验证超时停车与停距后才能开放该功能。
- 2026-10-21：把仿真前障碍从雷达前方 0.25 m 移到 0.40 m，使障碍点落入车前停车区，同时避开当前位置的名义车体圆包络。碰撞监控仍停车，Nav2 15 秒后失败并进入恢复决策，但恢复器检查整段已记录轨迹在 SLAM 地图中的扫掠区域，仍发现并非全部“已知空闲”，因此拒绝倒车（`/tmp/fwr_auto_sim_6y6d8u9v.log`）。目前没有端到端倒车通过证据；下一轮要在后方已被充分扫描、且局部代价图实时空闲的场景验证，不能降低占用/未知栅格门槛来通过测试。
- 2026-10-21：进一步把**仿真**扫描分为建图/Nav2 用的原始 `/scan` 和碰撞监控用的 `/scan_safety`，只在后者注入虚拟前障碍，避免虚拟点随车移动污染已走地图。前方停车与 Nav2 恢复决策正常触发，但已走轨迹在 SLAM 地图里仍未满足整车扫掠区“全部已知空闲”的严格条件，倒车依然被安全拒绝（`/tmp/fwr_auto_sim_a_fzf_zd.log`）。实车继续共用真实 `/scan`，未采用此仿真分路。
- 2026-10-21：增加拒绝原因的栅格位置诊断。复测确认第一个未知格约在地图坐标 `(-0.35, -0.13) m`，位于初始车位后方扫掠区（`/tmp/fwr_auto_sim_wy95s3ou.log`）。当前仿真从初始位置只前进约 0.10 m 就注入障碍，车尾方向尚未取得足够的已知空地，因此严格拒绝倒车是正确结果。下一轮应先让机器人向前建出足够的后方空闲走廊，再在有已知回退轨迹的位置阻挡前方；需同时验证固定前方停车区不会错误拦截安全倒车。
- 当前 Humble 安装的 Collision Monitor 使用固定停车多边形；车头近障进入 `front_stop` 后，原地转向或倒车指令也会被该停车区拦截。不能把短暂障碍移开后的恢复解释成持续障碍绕行。下一项仿真需测试更远处的新障碍是否使 Nav2 重新选路，以及近障倒车是否需要经验证的方向相关停车区；在此之前不开放实车自主脱困。
- 2026-10-21：将前障碍注入门槛提高到从起点直线距离 0.35 m 后，仿真确实注入障碍并在 0.098 秒内停止速度输出；但导航失败后的受限回退因 `track discontinuity` 被拒绝，未发生倒车（`/tmp/fwr_auto_sim_3_xn2ebb.log`）。已给该拒绝原因增加断点距离与两端坐标，单元测试验证了诊断格式。第二次仿真启动后因模拟传感器时间差及过滤命令超时而提前撤销授权，未到达注入门槛（`/tmp/fwr_auto_sim_6m9i28vp.log`）。两次都安全停机；仍须区分地图坐标校正与真实里程计断点，不能放宽连续性阈值来强行倒车。
- 2026-10-21：轨迹改在连续的 `odom` 坐标系记录，回退前用同一个当前 `map←odom` 变换映射整条短轨迹；这避免 SLAM 逐帧修正被误判成行驶轨迹断点。仿真前方停车分别约 0.099 秒（`/tmp/fwr_auto_sim_glm5nq_1.log`）和 0.048 秒（`/tmp/fwr_auto_sim_d6ub387g.log`），原轨迹断点拒绝不再出现。回退仍因旧轨迹端点未知而拒绝，因此改为只使用从当前位置起连续且全部已知空闲、至少 0.05 m 的短后缀，未知区仍不能进入。
- 2026-10-21：仿真障碍注入改按累计行驶距离 0.60 m，而非离起点的直线距离，避免前沿探索转向后漏测。连续两次进入 `reversing`，但记录到安全出口负速度指令为 0、倒车位移为 0（`/tmp/fwr_auto_sim_c8rmojp6.log`、`/tmp/fwr_auto_sim_c527p29o.log`），**不能算倒车通过**。诊断发现一次因局部代价图年龄 0.505 s 超过 0.5 s 门槛而退出；原发布频率仅 2 Hz，已将仿真和实机局部代价图发布频率改为 5 Hz。随后仿真仍由回退控制器主动中止（`/tmp/fwr_auto_sim_ahmq7ray.log`），已补充具体中止原因日志，待下轮复测。实车倒车继续关闭。
- 2026-10-21：核对 Nav2 开源 `Costmap2DPublisher` 的 OccupancyGrid 换算：膨胀区 1–98、贴近障碍区 99、致命障碍 100、未知 -1。局部代价图检查原来把 1–98 也当成障碍；现允许这类非致命膨胀值，但整车扫掠圆仍拒绝 99、100 和未知。复测中控制器发出 8 条负速度原始指令，自动选择器发出 16 条负速度指令，安全出口仍为 0，车没有倒退（`/tmp/fwr_auto_sim_hjyf3yq1.log`）。这确定剩余阻断在 Collision Monitor：固定 `front_stop` 被前方障碍触发后，也会挡住远离它的倒车。需要单独设计并验证按运动方向应用的近障保护，不能直接绕过监控。实车自动倒车仍未验收。
- 2026-10-21：在 Humble 1.1.20 上启动前、后两个独立 Collision Monitor，并由唯一选择器发布 `/cmd_vel_auto_safe`。无障碍自动探索 35 秒到达约 `(0.84, 0.58) m`，正常停止（`/tmp/fwr_auto_sim_ok59txom.log`）。前障碍持续存在时，停车延迟约 0.10 秒，随后倒车累计 0.222 m，最大单段 0.096 m，低于单段 0.10 m 和总计 0.30 m 上限（`/tmp/fwr_auto_sim_l8v8lpnb.log`）。这些是仿真结果，不代表实车盲区安全。
- 2026-10-21：后侧可见区注入障碍时，回退原始指令 9 条，但后向监控、安全出口和底盘倒车指令均为 0，位移为 0（`/tmp/fwr_auto_sim_1k3apddu.log`）。雷达断流后授权锁定关闭且未自动续行（`/tmp/fwr_auto_sim_ssyyyqwt.log`）。固定目标侧向绕障通过：最大 x≈1.10 m，离障碍中心最近 0.638 m，大于 0.599 m 要求，新增规划 58 次（`/tmp/fwr_fixed_reroute_b5d9i3pa.log`）。正中阻断仍会停车并由 Nav2 报无法取得进展，不能宣称所有障碍都可绕过。
- 2026-10-21：倒车场景复测在累计行驶 0.05 m 和 0.25 m 后注入障碍，两次都在 0.15 秒内停车，但恢复器发现返回轨迹的车体扫掠区含未知地图格，拒绝倒车（`/tmp/fwr_auto_sim_f_0mjlg7.log`、`/tmp/fwr_auto_sim_cm017i_x.log`）。这说明是否能倒车取决于返回走廊已知空闲，而非只看前方障碍。仿真验收脚本现要求明确的运动测试时长，并验证注障前确有近期前进动作，防止空测误报通过。当前 140 项包测试、两包构建与两套启动参数检查通过。
- 2026-10-21：把同一场景的注障门槛设为累计行驶 0.60 m 后，已知返回走廊足够，前方在 0.150 秒内停车，随后受限倒车 0.225 m；最大观测单段 0.102 m（编码器采样容差 0.005 m），最终停机且没有未授权运动（`/tmp/fwr_auto_sim_74_il_l7.log`）。早期未知区域仍拒绝倒车；实车制动距离和后方盲区尚未验证，实车自动倒车保持关闭。
- 2026-10-21：实车**静态** ROS 链路已检查，未发运动指令：C1 `/scan` 约 10 Hz、IMU、`/odom`、`/map` 与 `map→base_footprint` 可用；ESP32 串口打开，`/base/fault=0`；前后监控均为 `active`，Nav2 生命周期可激活，`/cmd_vel_auto_safe` 仅由方向选择器发布且实测为零速，`motion_enabled=false`。检查后已停止本次 launch，原有 IMU 节点仍在运行。雷达延时在 8 秒采样内约 0.098–0.101 秒；监控启动时曾出现短暂时间戳差超过 0.25 秒的日志，实车运动前仍需按预检确认实时性。测得外廓和带载停车距离尚未提供，因此没有执行自动运动预检或授权。
- 2026-10-22：人工限时直行测试以 0.10 m/s 指令运行约 1 秒，地面标记实测总位移 60 mm，里程计总位移 61 mm；零速指令后里程计继续约 10 mm，故障码 0，用户确认平顺前进且正常停下。脚本退出后 `motion_enabled=false`、`manual_enabled=false`，测试用 launch 已停止。用户实测底盘外廓 520 × 350 mm，与模型碰撞体一致，Nav2 footprint 保留额外余量。此 10 mm 是人工零速后的里程计值，不是雷达发现障碍到完全停下的实测距离；自动运动预检仍不能把它当作近障停车验收。
- 2026-10-22：用户明确实测 C1 扫描中心距底盘最前沿向后 50 mm、左右居中、离地 75 mm。底盘长 520 mm，故雷达相对底盘几何中心向前 210 mm；当前 URDF 的 `base_link` 离地 32.5 mm，`base_link→laser_front` 更新为 `(0.21, 0, 0.0425) m`，保留已实测的 180° 朝向修正。安装高度很低，仍须核查底盘、万向轮与线束遮挡；不能仅凭 TF 校准宣称后方可避障。
- 2026-10-22：停机状态下只启动 C1，采样 20 帧 `/scan`：前方 45° 扇区最小距离中位数约 1.17 m，未见 0.35 m 内近点；车尾 45° 扇区最小距离中位数约 0.108 m，约 95% 的有效点小于 0.35 m。根据雷达安装位置，这些极近返回可能来自车体、支架或线束，也可能有现场近物；尚未逐一辨别。此结果不证明车尾可见区域安全，实车自动倒车继续关闭。
- 2026-10-22：用户确认雷达后方固定有电池等车载物品，后续还要安装笔记本电脑。后向约 0.1 m 的近点因此须按车载遮挡处理；不能要求移走这些最终会保留的部件来证明倒车安全。已核对 `real_exploration.yaml` 中 `supervised_recovery_enabled: false`，实车自动倒车继续禁用。已走过的轨迹只证明过去通行，无法替代当前后向障碍观测。下一项优先验证前向监控的近障停车；若以后需要自动倒车，须在最终装配状态提供并实测能覆盖车尾扫掠区的后向传感器或重新布置雷达。
- 2026-10-22：前方放纸箱的停机静态扫描共 20 帧：车头 ±22.5° 内最近点约 0.524–0.538 m（雷达起算），全部帧都在前向 `front_slow` 几何区内，共 971 个有效点；`front_stop` 几何区内为 0 点。此位置应减速而非停车，尚未验证监控节点实际输出及接地制动。待纸箱移到车头前约 15–20 cm 后复测停车区。
- 2026-10-22：用户把纸箱移到车头前约 15–20 cm 后，静态 20 帧扫描的车头最近点为 0.220–0.222 m（雷达起算）；每帧有 102–107 个有效点位于 `front_stop` 几何区。仅启动雷达、TF 与前向 Collision Monitor 的软件干运行中，首次缺少 `odom→base_footprint` TF，监控错误地放行模拟 0.10 m/s；补静态 TF 后监控日志报告 `Robot to stop due to front_stop polygon`，但测试订阅者未收到 `/cmd_vel_auto_forward_filtered` 输出，不能据此宣称速度出口已验收。测试没有启动底盘桥接或电机，结束后已停止测试节点。下一步须在隔离环境查明监控输出缺失，并验证零速出口及 TF 缺失时的故障归零，再考虑接地近障制动测试。
- 2026-10-22：进一步在完整静态 TF 存在时重启前向监控，先建立输出订阅，再激活监控并输入模拟 0.10 m/s。监控日志再次报告 `front_stop` 停车，输出采样包含零速；同时也采到初始少量 0.10 m/s，发生于监控首次处理激光数据之前。先前订阅不到输出是因监控已处于持续停车状态，晚订阅者收不到早先的零速消息。故单独的 Collision Monitor 启动瞬间不能当成已验证的故障安全链；下一步要验证前向监控、方向选择器、扫描新鲜度门和底盘桥接串联时，TF/扫描未就绪不会输出运动指令。此轮仍未接电机或测真实障碍到停机距离。
- 2026-10-22：方向选择器增加运行时 TF 门，要求 `odom→base_footprint` 的动态变换时间戳在 0.25 s 内，且 `base_footprint→laser_front` 可用，缺失则持续发布零速。无电机 ROS 联测以模拟监控放行速度验证：缺少 odom TF 时输出只有 0；动态 TF 新鲜时出现预期 0.08 m/s；停止更新 TF 后最后输出回到 0。整包 141 项测试与 `fwr_bringup` 构建通过。这补上运行中 TF 丢失的缺口；仍须验证监控刚激活而扫描尚未处理的窗口，以及实车实际障碍触发后的停车距离，自动运动暂不开放。
- 2026-10-22：选择器进一步要求前、后 Collision Monitor 的 lifecycle 状态持续为 active；状态变化会立即清掉对应监控结果，重新激活后必须有新扫描并稳定 0.30 s 才允许非零输出。使用真实 Nav2 监控进程、合成扫描/TF/指令、没有底盘桥接的端到端干运行：监控未激活且前方有障碍时 10/10 输出为零；激活后前方障碍 23/23 为零；移走合成障碍后 17 次输出中 14 次为 0.08 m/s；前向监控停用时 13/13 为零；重新激活后经过稳定期恢复放行。清空场景有少量零速间隙，可能造成速度轻微顿挫，后续需继续观察；实车自动运动仍未开放，真实停车距离仍未测。
- 2026-10-22：在有人看护、前方放置宽纸箱的封闭场地，执行三次最多 3 s / 0.09 m 的前向受限试验。纸箱初始雷达距离约 0.45 m，停车区静态扫描连续 30 帧均为 0 点，减速区约 51–63 点。第一次指令 0.06 m/s 被 0.4 减速比例压到 0.024 m/s；第二次指令 0.10 m/s、比例 0.7 后，安全出口仍因每次原始指令到达时清空前次监控结果而频繁插入零速，两次地面位移均小于 1 mm，故障码 0。修正同速重复指令的短暂衔接：只允许沿用 0.06 s 内、早于新雷达帧的最近监控结果；指令变化、监控状态失效、新雷达帧、TF 或状态过期仍立即归零。第三次相同试验前进约 29 mm，监控报告 `front_stop` 并持续输出零速；停车时雷达约 0.424 m，随后里程计未继续增加，用户实测车头到纸箱为 385 mm，故障码 0。试验后 `motion_enabled=false`。这验证了此场景的近障停车，但未测动态障碍的最坏制动距离，也不能据此开放无人看护自动建图。配置比例 0.7、选择器测试及整包选定测试 81 项通过。
- 2026-10-22：近障停车后重跑固定目标仿真，首次未起步且产生 29 条路径；定位为新增 TF 门硬编码实车 `base_footprint`，但 Gazebo 底盘坐标为 `base_link`，安全出口始终归零。选择器增加 `base_frame` 参数，实车默认 `base_footprint`，走廊仿真传入 `base_link`。隔离域侧向障碍重测（`python3 scripts/check_fixed_goal_reroute_sim.py --domain 169 --timeout 100 --obstacle-y=-0.42`）通过：注障后新增 49 条路径，离障碍中心最近 0.633 m，高于 0.599 m 阈值，到达障碍另一侧 x≈1.103 m（`/tmp/fwr_fixed_reroute_re2___lt.log`）。正中障碍测试（域 170，`--obstacle-y=0`）未绕过：最高 x≈0.091 m，前向监控报告 `front_stop`，Nav2 最后因无进展取消目标；这属于无可行侧路场景，不能宣称总能重新规划成功。仿真结束时底盘进程已停止，未操作实机电机。
- 2026-10-22：再次启动实机完整导航链，但保持 `motion_enabled=false` 且不发运动命令。C1 `/scan`、`/map`、双 Collision Monitor active、`/base/fault=0` 均确认；Nav2 lifecycle 启动成功，`/bt_navigator` active。以真实外廓 520×350 mm、未知停车距离 `nan` 调用只读 `auto_mapping_preflight`，唯一拒绝理由是停车距离尚未实测，其他门槛均通过。不能把早先人工松键后的 10 mm 续行值冒充动态障碍制动距离；实车自动建图仍待受看护的动态停车距离测试。整包 145 项测试、构建和 `git diff --check` 通过。
- 实车前向近障短时停车已在上述单一纸箱场景验证；自动建图导航、动态障碍、自动倒车和地图保存仍未执行。Gazebo 受限倒车在充分建出的返回走廊通过、未知区正确拒绝；尚需验证串口重连、动态障碍和雷达后侧盲区，实车自动建图启动命令暂不执行。

本页的命令仅适用于已填写并验证的负载、地面、外廓、停距及有人看护的封闭场地。
