Yu20040207/pathfinder_robot/docs/hardware/chassis-drive-selection.md

# 二代底盘驱动方案（待硬件参数定型）

日期：2026-10-05。使用场景暂按室内平整地面、低速运行、进出电梯、上身机械臂按按钮、低功耗考虑。

## 当前采用的方案

2026-10-08 用户确认先采用两驱动轮差速方案；2026-10-10 明确底盘外廓长 52 cm、宽 35 cm、总高 20 cm：左右各一只带编码器的驱动轮，前端左右各一只无动力承重万向脚轮，构成四轮支撑。这里的万向脚轮指轮架可绕竖直轴回转的脚轮，不是带侧向滚子的全向轮或麦克纳姆轮。两台减速电机分别闭环控制左右轮速；软件对外使用 `cmd_vel`、轮速/编码器反馈、`odom` 和 `odom→base_link`。上身工作时限制底盘速度并保持驻车。此方案减少独立驱动路数，平整地面不需要横向平移时更容易调试和维护；Nav2 与 `diff_drive_controller` 都有现成的差速运动接口。**方案已确定为当前实施方向；电机、轮径、脚轮承重和轮子精确安装位置仍待满载数据验证，也不表示可以直接驱动一代硬件。**

2026-10-13 用户指定预览模型使用 **65 mm 驱动轮**；收到的 MG513X STEP 总成带 85 mm 轮，不作为当前轮径依据。下方以 100 mm 轮计算的旧验收示例需要在电机型号和 65 mm 实物参数确定后重算，不能用来判定新轮径方案满足 0.5 m/s 目标。

2026-10-16 用户给出当前样机轮子周长约 **210 mm**、左右驱动轮接地轨迹中心距约 **263 mm**。编码器手转实测两侧均约 **1468 个 4 倍频计数/轮圈**，前进方向左轮计数为负、右轮为正。初始里程换算取 `0.210/1468 ≈ 0.0001431 m/计数`，差速运动学轮距取 `0.263 m`。周长与轮距目前均为近似量，地面直行与原地旋转试验后再校准有效值；旧的 100 mm 轮示例保留作历史方案分析，不适用于当前样机。

基于上述初始参数的只读 ROS 2 验证节点可通过 `ros2 run fwr_bringup wheel_odometry` 启动。它独占 ESP32-S3 串口，每秒查询约 10 次现有 `r` 计数输出，发布 `/wheel/odom`；不会发送电机运动命令，也不发布 `odom→base_link` TF，以免与仿真或其他定位源冲突。参数 `wheel_circumference_m`、`wheel_track_m`、`counts_per_revolution` 和 `device` 可在命令行覆盖。当前发布的协方差故意设得很大，因为地面滑移、有效轮距和轮胎滚动周长仍未标定；暂不供自主导航使用。使用节点期间不要同时打开 ESP-IDF monitor 或其他串口测试脚本。

2026-10-16 只读节点实机验证：静止时 `/wheel/odom` 为零位姿、零速度。用户将左右轮依次朝前进方向各手转一圈后，读得 `x=0.1873 m`、`y=-0.0777 m`，最终 yaw 约 `+0.00054 rad`。按两轮依次各转 0.210 m、轮距 0.263 m 的中点积分，预期约 `x=0.1935 m`、`y=-0.0816 m`、最终 yaw 0；当前偏差可由手动转动终点及近似周长解释。该悬空测试验证计数到 ROS 2 位姿的数据链，不能证明地面定位精度。

| 方案 | 适用条件 | 主要代价 |
| --- | --- | --- |
| 两驱动轮 + 两万向脚轮，差速（当前采用） | 平整地面、低功耗优先；允许先旋转再靠近电梯按钮 | 不能原地横移，需规划转身空间；脚轮与机械臂载荷要做稳定性验证 |
| 四麦克纳姆轮独立驱动 | 电梯间或狭窄通道确实需要横向平移 | 四路驱动及标定；滚子接地和横移增加维护与能耗不确定性 |
| 四轮滑移转向 | 全部车轮需主动牵引、地面允许轮胎滑移 | 原地转向依靠轮胎侧滑，地面摩擦、磨损和功耗需实测 |

## 电气接口建议

样机先用一只底盘前置激光雷达；IMU、轮式里程计与 Nav2 的后续设计见 [底盘激光雷达与导航架构](chassis-lidar-navigation-design.md)。后置雷达是否需要，待实测盲区后决定；当前不接入实机导航。

- 样机阶段先用两台立盛 JGY4632-370-2485（370-8500、77.7:1 档）24 V 蜗轮蜗杆编码器减速电机。卖家参数表标称空载 109 rpm、额定负载 88 rpm / 3.0 kgf·cm / 0.4 A、堵转 8.1 kgf·cm / 2.2 A；堵转值不能作为连续输出能力。驱动器型号和编码器脉冲数尚待核实。
- 每路驱动器需要电流检测与过流/过温故障输出；主控提供通信超时停车，硬件急停要能独立切断驱动使能。每次上电默认不运动。
- ROS 2 主控只发布有时效的速度目标；底层 MCU 执行闭环、限速、故障处理，并回传编码器、驱动电流和故障码。不能把无反馈的 PWM 当作可靠里程计。
- 2026-10-12 确认样机现有控制板为 ESP32-S3，暂无 STM32 板。先由 ESP32-S3 读取左右轮编码器，并承担底盘速度闭环及故障停车；需按实际引脚、采样负载和通信稳定性验证是否够用。后续选用 DM-IMU-L1 成品模块，优先评估由 ROS 2 主机通过 USB 读取，详见[底盘激光雷达与导航架构](chassis-lidar-navigation-design.md)。只有出现经实测确认的接口或实时性瓶颈时，再评估迁移至 STM32；上位机仍使用相同的速度命令、编码器、IMU 数据与故障状态接口。
- 上身机械臂动作期间需要验证重心投影、轮子/随动轮载荷和底盘驻车能力。随动轮布局及轮距必须在外廓与载荷确定后选。

## 样机电机的验收边界

用户给定满载质量 24 kg、目标最高速度约 0.5 m/s、驱动轮直径 100 mm、轮宽 35 mm、坡度小于 2°。100 mm 轮达到 0.5 m/s 需约 95.5 rpm；此电机额定转速 88 rpm 对应约 0.46 m/s。两驱在 2° 坡上仅克服重力分量就需每台约 2.1 kgf·cm；若以滚动阻力系数 0.02 作示例，匀速上坡需每台约 3.3 kgf·cm，已略高于标称额定扭矩。实际滚阻、脚轮转向阻力、起步加速和输出轴承载能力必须实测。因此该型号只作为样机试用，不能据参数表认定满载速度与爬坡目标已满足。

- 分阶段测试：离地校验左右电机方向和编码器；空载低速地面直行、转向、停车；逐步加重到 24 kg，记录速度、两路电流、电机/减速箱温升和脚轮行为；最后在小于 2° 的坡道上重复起步、匀速和停车测试。
- 轮子若直接安装在减速箱输出轴上，先取得厂家允许的径向载荷和轴向载荷数据；不足时改为独立轴承支承轮轴。
- 实机接通语音或自主导航前，完成两路速度闭环、通信失联停车、限速、电流/温度保护与独立硬件急停。未通过满载测试前，将软件限速保持在实测稳定值以下。

## 定型前必须测量或确认

1. 24 kg 满载时的重心、胸口相机/上身/机械臂最大伸出姿态下的倾覆裕量。
2. 轴距/轮距、100 mm 驱动轮的实测滚动半径、目标加速度、最小通道宽度和电梯门槛高度。
3. 每日行驶距离、停机待命时长、电池电压与容量；在地面上测实际行驶电流与峰值电流。
4. 所购电机编码器脉冲数和接线、驱动器及 ESP32-S3 控制板接口、电源板容量、主机与控制板的有线通信协议及急停原理图；若后续迁移 STM32，再核对其接口。
5. 是否必须横向平移到电梯按钮前。若答案为“必须”，重新评估麦克纳姆轮的收益。

## 参考

- [Nav2 控制器与底盘类型](https://docs.nav2.org/rolling/configuration_and_development/tuning_guide/)
- [Nav2 里程计要求与差速控制器](https://docs.nav2.org/jazzy/configuration_and_development/first_time_robot_setup_guide/odom/setup_odom_gz/)
- [TI 带电流检测和故障保护的直流电机驱动器示例](https://www.ti.com/product/DRV8251A)；仅用于列举应评估的保护功能，非本项目定型器件。
