Yu20040207/pathfinder_robot/docs/hardware/esp32s3-smoke-2026-10-13.md

# ESP32-S3 USB 烧录验证（2026-10-13）

- 设备：Espressif USB Serial/JTAG，稳定串口名
  `/dev/serial/by-id/usb-Espressif_USB_JTAG_serial_debug_unit_90:70:69:F7:F0:B0-if00`。
- 芯片：ESP32-S3，revision v0.2，双核，8 MB 内置 PSRAM；Flash 实测 16 MB。
- 先完整读取 16 MB 原始 Flash 到被 Git 忽略的
  `data/firmware-backups/esp32s3-907069f7f0b0-2026-10-13.bin`。
  文件大小 16777216 字节，SHA-256：
  `c0440f814f8ce259ea113d9b688147061d4663717c4cc3dfc20611c016f58a3d`。
- ESP-IDF v5.5.5 编译 `firmware/esp32s3_smoke` 成功，目标 `esp32s3`，Flash 配置 16 MB，
  USB Serial/JTAG 控制台。烧录 bootloader、分区表和应用时，三段均通过写后哈希校验。
- 烧录后串口连续接收到 10 条 `fwr_smoke: heartbeat=6` 至 `heartbeat=15`，约每秒一条。
  说明固件已启动且 USB 串口输出正常。程序不配置电机 GPIO。

本次只验证 ESP32-S3 的识别、Flash 读写和串口运行；电机驱动板、编码器、
供电保护、急停和 ROS 2 通信尚未接线或测试。备份含原始 Flash 内容，应留在本机并妥善保管。
