Yu20040207/pathfinder_robot/docs/hardware/second-gen-cad-preview.md

# 二代底盘 CAD 外观预览

2026-10-13 收到 `第二代3D文件.zip`。压缩包包含 DM-IMU-L1、MG513X 电机、MG513X 加支架、MG513X 加支架及 85 mm 轮、AT8236 D157B 驱动板、C1 雷达的 STEP 文件；没有底盘外壳或整机装配文件。用户随后确定驱动轮直径为 **65 mm**，因此 URDF 不使用压缩包中的 85 mm 轮总成。

`ros2_ws/src/fwr_bringup/description/fwr_chassis_demo.urdf` 保留 0.52 × 0.35 × 0.20 m 的**整体预览外廓**，并把两个驱动轮改为直径 65 mm 的圆柱。为让轮胎在 RViz 中露出，`fwr_chassis_wheel_recesses.stl` 在原尺寸演示外壳两侧、驱动轮位置各切出一个约 90 × 55 × 55 mm 的局部凹槽；前方两个从动轮保持原状。凹槽只是显示预览，底盘 CAD 到位后须按轮胎、悬架和转向空间重做。电机加支架、IMU、驱动板、C1 雷达的外观从 STEP 转成米制 STL，置于同一 `description` 目录。网格仅用于 RViz 外观；碰撞体仍为未开槽的简单包围盒，惯量和质量为预览估值，**不能据此验证实机运动、承载或碰撞间隙**。

| 零件 | URDF 网格 | 状态 |
| --- | --- | --- |
| MG513X 电机加支架 | `mg513x_motor_bracket.stl` | 左右各一件；外观上下翻转 180°；轴线与安装面位置待底盘 CAD 校准 |
| C1 雷达 | `rplidar_c1_cad.stl` | CAD 外观单独旋转 180°，沿用先前实测的 `/scan` 坐标方向；CAD 含电缆，网格总外廓大于雷达头部 |
| DM-IMU-L1 | `dm_imu_l1.stl` | 顶部预览位置，待确定实际安装点和轴向 |
| AT8236 D157B | `at8236_d157b.stl` | 顶部预览位置，待确定安装孔和线束空间 |

所有文件的几何从 STEP 的毫米尺度换算到 URDF 的米尺度。驱动轮宽度仍暂用 35 mm；轮心、万向轮和电子模块坐标仍为预览值。正式用于导航和 Gazebo 动力学前，需要实测轮距、轮心与底盘基准、IMU 轴向、雷达扫描平面高度、整机质量和惯量，并据实物修正碰撞体。现有走廊 Gazebo SDF 使用独立底盘模型，本次 URDF 外观更新不改变其物理参数。
