Yu20040207/pathfinder_robot/docs/superpowers/specs/2026-10-22-front-side-scan-mapping-design.md

# 前方与侧方激光建图设计

日期：2026-10-22。范围：C1 实机扫描到 SLAM、Nav2 代价图的输入；不修改电机控制，不启用实机自动倒车。

## 目标与现场事实

雷达固定在底盘前部，扫描零角朝车尾。车尾的电池、线束以及未来的折叠腰部会长期遮挡扫描平面，不能靠调整安装位置消除。首张实地图的行驶轨迹上出现断续黑点；静止扫描在底盘轮廓内记录到大量距离约 0.13 m、原始角度约 −40° 至 +40° 的回波。这些机器人固定回波不应写进地图。成功标准是静止与行驶时，过滤输出不含车体回波，前方与两侧真实障碍仍能显示，新地图不再沿轨迹留下这类黑点。

## 方案选择

1. **推荐：保留 `/scan` 并另发 `/scan_mapping`，按可见角度屏蔽车尾扇区。** 新节点只改 `ranges` 中被遮挡的采样为 NaN，保持原始时间戳、坐标系、角度索引和采样率；SLAM 与 Nav2 代价图订阅新话题。角度界限是可配置参数，按实测 C1 安装方向核对。这样能分别观察原始扫描和建图扫描，也不会把过滤误认为后方可见。
2. 直接修改雷达驱动输出 `/scan`：消费者改动少，但会隐藏原始回波，降低诊断与安全链的可核查性。
3. 对扫描做完整车体三维模型过滤：未来折叠腰部姿态会改变遮挡，需要关节状态和几何模型；当前只需前方与侧方数据，此方案复杂度过高。

ROS 社区的 [`laser_filters`](https://github.com/ros-perception/laser_filters) 提供 `LaserScan` 角度过滤作为参考。当前工作区未安装 `ros-humble-laser-filters`；实现优先采用项目内一个小型、可测试的 LaserScan 掩码节点，避免增加部署依赖。过滤行为按真实扫描角度索引验证，不直接照搬网上的角度符号。

## 数据流与安全边界

`sllidar_node → /scan` 保持不变。新增过滤节点订阅 `/scan`，输出 `/scan_mapping`。`slam_toolbox` 的 `scan_topic` 和 Nav2 本地、全局障碍层均改为 `/scan_mapping`。RViz 同时显示原始扫描与过滤扫描，便于核对遮挡边界。底盘桥接的雷达新鲜度门和前、后 Collision Monitor 仍订阅原始 `/scan`；不得从过滤后的空白扇区推断该方向空闲。

初始掩码覆盖朝车尾的原始零角附近，保留朝车头的 ±π 附近及可靠侧向。候选边界为原始 −90° 至 +90°，最终以静止扫描和在前、左、右放置纸箱的无动力测试收紧或放宽。设定前必须核对 `laser_front` 的实际方向、角度递增顺序和车体内回波位置。过滤只屏蔽观测，不向地图写入“空闲”；遮挡区应保持未知。对无效角度配置、异常采样元数据、或前左/正前/前右任一 60° 扇区有效采样少于一半，节点报告错误且不发布貌似正常的过滤扫描。正常的 `+Inf` 无回波可以表示该方向未测到障碍，计作有效采样；实机静止扫描三个扇区均有完整采样。下游新鲜度预检须拒绝自动运动。

后向盲区是结构性限制。当前实机自动倒车许可保持关闭；历史轨迹不能证明车尾此刻安全。未来增加后向超声波时，再单独设计传感器位置、覆盖区、测距可信度和与现有近障保护的融合，本设计不预留虚假的后向放行条件。人工键盘后退仍需现场目视和人工急停。

## 实施与验证顺序

1. 用已有实测扫描或合成 `LaserScan` 做单元测试：原始零角遮挡、±π 前方保留、左右侧保留、边界、NaN、元数据不变、异常输入拒绝。静态配置测试确认 SLAM 与两层代价图只读 `/scan_mapping`，安全监控继续读 `/scan`。
2. 在独立 ROS 域运行过滤节点与录制或合成扫描，无电机，比较 `/scan` 和 `/scan_mapping` 的点数、角度、时间戳和采样频率。遮挡扇区的车体回波必须消失，前、左、右箱体必须保留。
3. 更新启动配置后，在实机保持运动门关闭，确认过滤节点、SLAM、代价图和安全监控各自订阅正确话题；拔掉过滤节点或断开原始扫描时，自动运动预检须拒绝放行。
4. 在有人看护、封闭场地进行低速键盘重新建图，保存为新地图文件。对比旧地图轨迹内的黑点；如仍出现，先检查外参、边界和定位，不通过此验收就不开放自动探索。

当前 RViz/建图会话不会热切换扫描话题。实施完成后在明确停机状态重启建图链，保留旧地图作为诊断证据；不在本设计阶段操作真实电机。
