Yu20040207/pathfinder_robot/docs/superpowers/specs/2026-10-23-fixed-goal-navigation-design.md

# 实车单次定点导航设计

## 目标

在已保存地图并完成 AMCL 定位后，允许操作员指定一个短距离目标，让 Nav2 规划和跟踪路径；到达、取消、超时或故障时停车。先完成仿真和实车无动力联通，再单独安排有人看护的地面短测。

## 当前约束

- 现有 `frontier_explorer` 是 `/explore/state` 的唯一正常发布者；`auto_command_gate`、双向 Collision Monitor 选择器和 `base_bridge` 都依赖该状态。
- 直接向 `NavigateToPose` 发目标时，状态仍为 `stopped`，速度会被归零。仿真脚本曾额外发布 `navigating`，此方法只用于仿真验证，不用于实车。
- 底盘 `motion_enabled` 默认关闭；显式 `/base/arm_auto`、新鲜雷达/IMU/里程计、零故障及 Collision Monitor 就绪仍是运动前提。

## 设计

为 `frontier_explorer` 增加 `StartFixedGoal` 服务，输入 `map` 坐标系目标 `x`、`y`、`yaw`，返回接受状态及原因。只在探索停止、没有未结束的 Nav2 goal、地图和里程计新鲜、无故障、非手动模式、底盘已显式 arm 时接收。拒绝非有限坐标或地图外/占据目标。请求由节点自己的 `NavigateToPose` 客户端发送，进入 `navigating` 状态后才允许 Nav2 速度经过原有安全链。

单次模式不选择前沿目标，不自动发送第二个目标，不执行倒车恢复。成功或失败都停止状态发布并取消仍在运行的 goal；`/explore/stop` 同时停止探索和定点模式。保留现有地图/里程计跳变、失联、手动接管、底盘故障和试验时长上限。任何异常默认发布停止状态，自动控制门归零。

初次实车路径最长 0.35 m，操作员在旁可立即切断 12 V。无动力验收时保持 `motion_enabled=false`，验证服务拒绝或只规划、不产生电机输出；带电试验必须另行核对定位、净空和保护状态。

## 验收

1. 单元测试覆盖目标输入/地图占据、忙碌拒绝、到达后不再派发、故障/取消/超时停机。
2. 仿真中由此服务发送定点目标，移入障碍后 Nav2 重新规划，停止/故障时安全输出归零；不再由测试脚本伪造 `/explore/state`。
3. 实车无动力时确认路径规划、状态变化、取消和输出归零；不进行自主行驶。
