Yu20040207/pathfinder_robot/docs/superpowers/specs/2026-10-23-real-rviz-point-navigation-design.md

# 实车 RViz 两点导航设计

## 目标

在已保存的地图上，操作员像仿真时一样依次点击**起点和终点**。点击“开始导航”后，实车先从当前位置行驶到所选起点，确认第一段成功后再行驶到终点。两段都可预览路径；纸箱等新出现的障碍由实时激光代价地图参与规划，运动中仍由现有控制器和近障监控限速、停车。

## 当前事实与约束

- 实车定位界面已有 `/map`、车体、扫描和 **2D Pose Estimate**，但没有受控终点面板。当前激光点与保存地图墙线重合良好；这是一次静止采样，不能代替行驶中的定位验收。
- 仿真 `TwoPointNavPanel` 把任意两次点击解释为两个 `NavigateToPose` 动作：先开往所选起点，再开往终点。用户明确要求实车也采用此顺序。实车当前实际位姿仍由 AMCL 提供，是第一段规划的出发位置；地图上点出的“起点”是第一段要抵达的路点。
- 实车 `frontier_explorer` 的 `StartFixedGoal` 服务负责发送 Nav2 目标并维持探索状态、安全门、超时和故障停机；当前最大目标直线距离为 0.5 m。直接使用 RViz 默认 **Nav2 Goal** 会绕过这个状态入口，虽然底盘运动门可阻止驱动，但会造成 Nav2 目标与实车任务状态不一致。
- 车身使用 0.60 × 0.43 m 的规划轮廓；全局和局部代价地图均订阅 `/scan_mapping`。用户放置纸箱的静态试验中，雷达约 0.91 m 处看到障碍，Nav2 的 `ComputePathToPose` 已规划出绕行路径；还没有完成实车绕行。
- 当前运动门 `/base/auto_armed=false`。选点、预览和下面的无动力验收都不得使电机转动。

## 方案比较

1. **直接复用仿真面板：** 界面相似，但直接发两段 Nav2 动作，第一段可能驶向标记的“起点”，并绕过实车任务状态；不采用。
2. **只用命令行调用现有 0.5 m 服务：** 无需新界面，适合短测，但不能满足地图点选和路线预览；作为调试备用。
3. **把仿真的两点面板部署到实车，切换安全入口：** 保留同一套点击起点、终点、预览和开始的操作；面板在实车模式下改为调用 `frontier_explorer` 管理的两点任务。用户明确选择此方案。实车先维持每段 0.5 m 的试验限距。

## 操作与数据流

1. RViz 使用 `map` 固定坐标系和保存地图。若 AMCL 位姿与实际车位不符，操作员先用 **2D Pose Estimate** 校准，并确认当前激光点与地图轮廓贴合。然后像仿真一样用 **Publish Point** 依次点选起点和终点。车体实际位姿是第一段导航的出发位置。
2. 实车面板用 `ComputePathToPose(use_start=false)` 预览“当前位置→起点”，用 `ComputePathToPose(use_start=true)` 预览“起点→终点”，分别显示两段路径和长度。任一规划失败、点位不在已知可通行区域、定位不可用或两段连接不连续，启动按钮禁用。预览不发送运动命令。
3. 面板重新选点、重新定位、移动底盘、地图/代价地图变化或预览过期后，要求重新预览。UI 预览不是安全授权；后端两点任务入口在启动和第二段派发前复核地图、里程计、激光、IMU、故障、手动接管、运动门和任务忙碌状态。
4. 新增受控的两点任务接口，由 `frontier_explorer` 顺序持有两个目标，沿用现有 Nav2 action 客户端和 `/explore/state` 安全链。第一段**收到 Nav2 成功结果并确认任务仍有效**后才派发第二段；任何失败、取消、故障、超时或安全门撤销均停止整个任务，不自动重试第二段。面板不得在第一段完成回调里直接向 Nav2 发第二段。
5. 操作员明确点击 **开始导航** 后，面板只调用两点任务接口；被拒绝时显示原因，不能退回直接 `NavigateToPose`。**停止** 调用现有 `/explore/stop` 并等待 Nav2 目标终止；底盘故障或状态超时由现有安全链归零。
6. 初期对“当前位置→起点”施加 0.5 m 上限，对“起点→终点”施加 0.3 m 上限。Nav2 第一段有 0.2 m 到点容差；给第二段预留该距离，保证第二段从实际停车位置仍能通过 0.5 m 的派发检查。只做无动力选点/预览与有人看护的短距离行驶。完成直行、转向、停止和动态障碍验收后，另行扩大允许距离；每次扩大前复核实际净空，不把膨胀半径当成物理净空保证。
7. 复用仿真的 `TwoPointNavPanel` 代码与按钮流程，以独立的实车插件类启用受控服务入口；仿真仍走原来的 Nav2 action。实车 RViz 配置加载受控插件，不提供会直达 Nav2 的默认 **Nav2 Goal** 工具。

## 验收顺序

1. 主机测试：两段均规划成功才可开始；第一段失败或取消绝不派发第二段；第一段成功后仅派发一次第二段；两段期间故障、定位跳变、超时或停止均归零。实车面板不直接创建 `NavigateToPose` 动作客户端。
2. 无动力现场：保持 `/base/auto_armed=false`，用当前纸箱验证两段路径预览；点击启动应被安全链拒绝，底盘输出保持零。
3. 有人看护的地面短测：纸箱先移出车道，用首段不超过 0.5 m、次段不超过 0.3 m 的空旷目标验证顺序运动、停机与异常取消；随后在确认实测侧向净空后，才扩大目标距离做纸箱绕行。

## 遗留边界

激光雷达后方会被电池和以后安装的电脑、腰部遮挡；本阶段目标与恢复行为只允许已验证的前进和原地转向，不开放自动倒车。RViz 路径预览、局部代价地图和近障停机各自承担不同作用；任何一项失败都不能由另外一项替代。

## 2026-10-24 修订：单点直达

- 地图上**单击一次**现在表示“从当前位置前往该点”；**连续点击两次**仍是原来的起点/终点两点流程；第三次点击开始新的单点选择。
- 单点预览使用 `ComputePathToPose(use_start=false)` 计算“当前位置→终点”；两点预览仍分两段。
- 实车单点启动仍由面板依次打开运动门、等待 `/base/ready`、申请 `/base/arm_auto`，然后调用已有的 `/explore/start_fixed_goal`（`StartFixedGoal`），不绕过安全链，也不新增 ROS 接口。目标 yaw 取 `map→base_link` 到点击点的方向。
- 两点启动继续调用 `/explore/start_two_point_goal`；原有两点顺序、距离上限和失败停机规则不变。
- 本修订只完成代码、构建和单元测试；单点/两点的实车按钮流程仍需现场人员验证。
