Yu20040207/pathfinder_robot/docs/plans/2026-11-04-auto-mapping-viewpoint-plan.md

# 自动建图改造设计（视点规划 + 半径受限覆盖）

> 状态：**设计阶段，未实施**。用户要求：改造必须**新增文件**，不得修改现有导航的行为树/参数/节点。
> 调研日期：2026-11-04

## 1. 现状：导航是怎么规划的

| 层 | 组件 | 作用 | 关键参数（v1.4，已冻结） |
| --- | --- | --- | --- |
| 全局 | SmacPlanner2D（`GridBased`） | 在全局代价地图上算点到点最小代价路径 | `cost_travel_multiplier 8.0` |
| 局部 | Regulated Pure Pursuit | 取前视点算 v/ω，跟踪全局路径 | `lookahead 0.55`、`rotate_to_heading 0.55` |
| 调度 | BT `RateController` | 每 2 秒重规划整条路径 | `0.5 Hz` |

**要点**：这是"点到点"规划，本身不会覆盖区域；自动建图以前靠**前沿探索**（随机挑已知/未知边界），
因此路径零碎、时间利用率低。

## 2. 实测数据（`real_map_manual_1101`，18.4×22.9 m，自由 164442 格，可行驶 350 m²）

| 方案 | 路径长度 | 预计耗时(0.2 m/s) | 覆盖 |
| --- | --- | --- | --- |
| 面积扫描（每 0.4 m 行距、按房间蛇形） | 891 m | **74 min** | 99.2% 可行驶区 |
| Fields2Cover 单多边形（无分解） | 1950 m | 162 min | 62.5% |
| 视点规划 v1（欧氏直线排序） | 130 m | 12.8 min | 95.2% **穿墙，不可用** |
| **视点规划 v2（真实栅格路径）** | **158.9 m** | **16.8 min** | **95.3%** |

脚本：`/tmp/fwr_runs/grid_rooms.py`、`f2c_cov3.py`、`viewpoint_plan2.py`（临时目录，需要时重建）

### Fields2Cover 评估
- `ros-humble-fields2cover` 2.1.1 已装（需先 `source /opt/ros/humble/setup.bash`，否则 `libortools.so.9` 找不到）
- **梯形分解 `DECOMP_TrapezoidalDecomp` 在本场地图上两次核心转储** → 不可用
- 结论：**不采用**。视点规划不依赖它

### 房间分割评估（重要）
用门洞腐蚀分割房间，在本地图**不可靠**：

| door_closing | 房间数 | 最大房间 | <3 m² 碎块 |
| --- | --- | --- | --- |
| 0.22 m | 6 | 169.8 m² | 2 |
| 0.45 m | 6 | 124.2 m² | 1 |
| 0.70 m | 7 | 98.4 m² | 3 |

房间之间是宽开口（拱门），1.45 m 腐蚀也切不开 → **不能靠"房间标签"判断是否扫完**。

## 3. 设计方案

### 3.1 半径受限覆盖（替代房间标签）

```
R = 4 m
while R 米内还有"未看见且可达"的格子:
    选性价比最高的视点 → 走过去 → 停下扫 3 s → 更新 seen 掩膜
if R 内没有:
    R = 8 m，重复
if R=8 m 仍没有:
    进入"扩展"流程
```

- "未看见"由**射线投射**判定（120 射线、遇墙停、射程 6 m），不是"车经过即算看见"
- 房间尺度 3~6 m ⇒ R=4 m 时视点自然落在本房间 → **自动实现"扫完这间才出门"**
- 无需房间分割

### 3.2 扩展（进新房间）

```
① 找前沿（已知/未知边界）＝门洞
② 目标点必须在【已知区一侧、离边界 0.4 m】
   —— 静态层 track_unknown_space=false，未知格会被当作可通行；
      目标打进未知区会导致"穿未知规划"撞上没探到的墙
③ 到门口停 → 扫一圈 → 门后变已知
④ R 重置为 4 m，回到 3.1
```

### 3.3 终止判据

`R=8 m 内无未看见格` **且** `无可达前沿` → 建图完成。

### 3.4 防卡死

- 同一区域连续 3 次尝试未减少"未看见格" → 标记不可达并跳过
- 沿用已实车验证的**卡住自愈**（`stuck_cancel_s 2.5` + `max_stuck_retries 2`）

### 3.5 性能（能否实时）

| 候选间距 | 射线数 | 候选数 | 单次计算 |
| --- | --- | --- | --- |
| 0.5 m | 180 | 1376 | 32.2 s ❌ |
| 1.0 m | 72 | 333 | **3.3 s ✅** |
| 0.8 m | 120 | 522 | 8.4 s |

结论：**1 m 网格 + 72 射线**，且只在"到点停下扫 3 s"期间计算 → 计算时间被扫圈停顿吃掉。

## 4. 已知问题：路径中途改道（用户反馈"一下左拐一下右拐"）

**机制**：BT 每 2 s 无条件重规划；两条代价接近的通路时，地图噪声/障碍层刷新/位姿微动会让"最优"在两条路之间跳。

**解法（待实施）**：新增**建图专用**行为树 `real_navigate_to_pose_mapping.xml`：

```xml
<Sequence>
  <Inverter><IsPathValid path="{path}"/></Inverter>   <!-- 有效就不重算 -->
  <ComputePathToPose goal="{goal}" path="{path}" planner_id="GridBased"/>
</Sequence>
<FollowPath path="{path}" controller_id="FollowPath"/>
```

`nav2_is_path_valid_condition_bt_node` 本机已确认存在。
**导航用的 `real_navigate_to_pose.xml` 一个字都不改**，只在建图 launch 里指定新 BT。

**验证指标**：`角速度符号翻转次数 / 每 100 m`（历史参考：卡顿时 25 s 内翻转 26 次，正常约 4 次）。

## 5. 实施清单（全部新增文件，不动现有导航）

| # | 新增 | 说明 |
| --- | --- | --- |
| 1 | `fwr_bringup/viewpoint_planner.py` | 半径受限覆盖 + 前沿扩展；只调 `/explore/start_fixed_goal` |
| 2 | `behavior_trees/real_navigate_to_pose_mapping.xml` | 条件重规划，防中途改道 |
| 3 | `config/real_viewpoint_planner.yaml` | 视点规划参数（R、射程、覆盖率目标、终止条件）|
| 4 | `launch/real_auto_mapping.launch.py` 增参数 | 用 `viewpoint_planner:=true` 切换新旧策略，默认关（保证旧行为不变）|
| 5 | 单元测试 | 覆盖：视点选择不穿墙、R 内优先、扩展点落在已知区、终止判据 |

**验收**：导航栈原有用例全过 + 建图跑一趟，指标对比（每 100 m 翻转次数、地图增长速率、总时长）。

## 6. 实施进展（2026-11-04 上午）

### 已写好的文件（全部新增，导航侧零改动）
| 文件 | 内容 |
| --- | --- |
| `fwr_bringup/viewpoint_core.py` | 纯逻辑：自由/障碍/未知掩膜、腐蚀膨胀、BFS 距离、射线可见性（含扇面填充）、视点挑选、前沿与扩展目标、覆盖率 |
| `fwr_bringup/viewpoint_planner.py` | ROS 节点：`enabled` 默认 **False**；只调用 `/explore/start_fixed_goal` |
| `config/real_viewpoint_planner.yaml` | 15 个参数（半径 4→8 m、射程 6 m、射线 180、填充 2、最小收益 400 格、停留 3 s）|
| `test/test_viewpoint_core.py` | 8 项单元测试：射线被墙挡、扇面填充渗透 ≤fill、半径优先、跳过已访问、BFS 绕障、扩展点在已知区、覆盖率 |

### 两个关键 bug（都在仿真里抓出来的）
1. **射线太稀**：72 条射线在 6 m 处间隔 0.5 m，只标记"射线经过的线" → 每跳只增 2% 覆盖。
   修复：射线提到 **180** + 结果做 **2 格膨胀**（模拟雷达扇面）。
2. **把"未知"当成墙**：`if unknown: break` —— 但未知只是"还没记录"，物理上不挡光。
   修复：默认只被**障碍**挡住（`stop_at_unknown=False`）。改正后覆盖率暴涨（65 跳 42% → 25 跳 95%）。

### 仿真结果（增量 SLAM 模拟：未知区随移动逐步揭示）
```
起点已知 15%  →  第5跳 36.9%  →  第15跳 72.5%  →  第20跳 85.4%  →  第25跳 95.3% ✅
总跳数 25，路径 47.8 m
预计实车耗时 ≈ 47.8/0.2 + 25×3s ≈ 5.3 分钟
```

| 方案 | 路径 | 预计耗时 |
| --- | --- | --- |
| 面积扫描（0.4 m 行距） | 891 m | 74 min |
| 视点（静态全图，理想） | 159 m | 17 min |
| **视点（增量 SLAM 仿真）** | **47.8 m / 25 跳** | **≈5.3 min** |

> 静态全图那版路径更长，是因为它必须把整张图的每个角落都规划一遍；
> 真实增量建图中，机器人一边走一边"看到"，路自然短得多。

### 尚待完成
- [ ] 建图 launch 接入（`viewpoint_planner:=true` 才启用，默认关）
- [ ] 建图专用 BT（`real_navigate_to_pose_mapping.xml`，条件重规划防改道）
- [ ] 实车验证：`tools/check_stack.sh` 自检 → 打开开关 → 对比"每 100 m 角速度翻转次数"和地图增长速率

## 7. 行为树实验记录（重要，别再重做）

目标是"减少中途改道"。试过三种写法：

| # | 写法 | 结果 | 结论 |
| --- | --- | --- | --- |
| 1 | `Inverter(IsPathValid) → ComputePathToPose` | **/plan 0 次、位移 0** | 空路径时 IsPathValid 返回 SUCCESS，被反转成 FAILURE → 永不规划 |
| 2 | `Fallback(IsPathValid, ComputePathToPose)` | **/plan 0 次、位移 0** | 空路径被判"有效"，Fallback 走第一条分支 → 永不规划 |
| 3 | **`RateController hz="0.2"` + 原结构** | **/plan 7 次、位移 0.33 m、地图 +2723** ✅ | 采用 |

**核心教训**：Hamble 的 `nav2_is_path_valid_condition_bt_node` 对**空路径**不可靠
（返回"有效"），不能用来做"是否需要规划"的判据。

对照实验（同一份 launch、只切 BT）：
- 原导航 BT（0.5 Hz）：/plan 12 次、位移 2.04 m
- 建图 BT（0.2 Hz）：/plan 7 次、位移 0.33 m、地图 +2723

两者都能跑，建图版重规划更慢 → 改道机会更少。

## 8. 实机跑通（2026-11-04 下午）

### 可用配置（已实测）
```
slam_engine:=slam mapping_bt:=true use_explorer:=false
viewpoint_planner:=true viewpoint_enabled:=true
stuck_reverser:=false kickstart:=false
```
实测：**13 个导航目标全部成功、0 失败**，地图 9500 → 11664 格，每跳前进约 0.88 m。

### 又修掉的 3 个死结
| 问题 | 现象 | 修法 |
| --- | --- | --- |
| 目标太近 | 1 m 内的目标被 Nav2 判"已到达"，走一步就停 | `min_goal_m: 1.2`（视点**和**前沿目标都过滤）|
| 手动起步不可靠 | `/cmd_vel_manual` 被底盘丢弃（`sensors_ready` 间歇为 0）| 起步改用 **Nav2 目标**（`_scan_bootstrap_cell`）|
| 起步被导航目标挡住 | `command_source_allowed`：有目标在跑时手动指令一律丢弃 | 起步前先 `cancel_goal` |

### 参数取值教训
- `bootstrap_max_cells` **4000 可用、20000 反而卡死**：起步要求"目标格已知空闲"，
  门槛设太高时地图太小、找不到合法目标 → 一直空转。
- `dwell_s` 3.0 → **1.0**：3 秒会明显"走一段停一下"。

### 已知未解决
- **走一段停一下**：每跳是一个独立 `NavigateToPose`，Nav2 到点要减速停车，
  加上 dwell 就形成顿挫。下一步：**把 4~6 个视点打包成 `NavigateThroughPoses`**，
  途经点不停车（多点导航已实车验证过这套机制）。

## 9. 滚动续点（用户思路，2026-11-04 下午验证）

用户提的方案：**「在到达第一个视点之前就把第二个算好，续上去，就不会一卡一卡」**。

实现：
```
队列里始终保留 lookahead=3 个点
跑向队首 → 距队首 <0.9 m 视为"已通过"→ 出队
剩余点 <= refill_at(2) → 立刻补一个新点，取消旧目标、用"剩余+新"整条重发
被取消旧目标的回调要忽略（_chaining 标记），否则会被当成失败清空队列
```

实测（20 秒窗口）：**静止帧 0%、前进帧 399/399、位移 3.76 m**（改之前静止 38%~100%）。

### 修掉的两个副作用
| 问题 | 原因 | 修法 |
| --- | --- | --- |
| **房间没扫完就出门** | 续点时"半径限制"算成了相对**上一个点**，链式选点一步步把车带出房间 | 半径判断用**车本身**做锚点（`home_dist`），排序仍用上一点距离（避免 Z 字形）|
| **出门后进不去下一个房间** | 门洞失败后反复重试同一个门 | 失败的门拉黑（0.8 m 内不再选），换下一个门 |

### 待观察
- 门洞宽度是否够（膨胀 0.48 后窄门可能规划不出来）——靠"拉黑 + 换门"绕过，但不是根治
- 房间是否真的扫完才出门：需要看 `home_dist` 锚点后的实际表现
