Yu20040207/pathfinder_robot/docs/superpowers/plans/2026-10-05-differential-demo.md

# 差速底盘离线闭环演示

日期：2026-10-05

## 目标

在 `/demo` 话题空间中让现有地图到路径规划器带动虚拟差速机器人到达目标，验证路径、位姿、速度约束和停止行为。不连接实机串口，不发布 `/cmd_vel`。

## 设计

- 纯 Python `DifferentialPose` 按左右轮线速度积分平面位姿；`WaypointFollower` 按路径点先对准再直行，限制线速度与角速度，到达后输出零速度。该控制器只用于演示，实机路径跟踪将由 Nav2 控制器负责。
- 演示节点发布 `/demo/map`、`/demo/pose` 和 `/demo/goal`，订阅 `/demo/path`；规划节点通过参数重映射到这些话题。合成地图含障碍和通道，启动后能重复运行。
- 演示节点不导出电机速度、不读取串口；所有 `/demo` 话题与实机命名空间隔离。地图、路径变化与目标到达状态在日志中明确显示。

## 验收

1. 先写纯函数测试：直行、旋转、圆弧、速度上限、目标到达及停止。
2. 实现差速积分与路径跟随，并跑测试。
3. 增加演示启动文件，在 ROS 2 中观察 `/demo/path` 和虚拟位姿变化，确认绕障、到点停机。
4. 运行全部测试和构建；README 明确该演示不代表实机可行驶。

## 2026-10-08 验收结果

合成地图与差速运动模型的路线仿真测试覆盖不进入障碍格和到点停止。ROS 2 `navigation_demo.launch.py` 运行时收到 16 点 `/demo/path`，约 29 秒后日志报告到达 `(2.33, 0.67)` m，`/demo/reached` 为 `true`；实际目标是 `(2.375, 0.625)` m，误差在 0.07 m 容差内。话题列表只有 `/demo/*`，没有 `/cmd_vel`。该结果只证明模拟链路，不代表轮胎、地面或实机控制性能。
