Yu20040207/pathfinder_robot/docs/hardware/preview/fwr_chassis_rviz.png

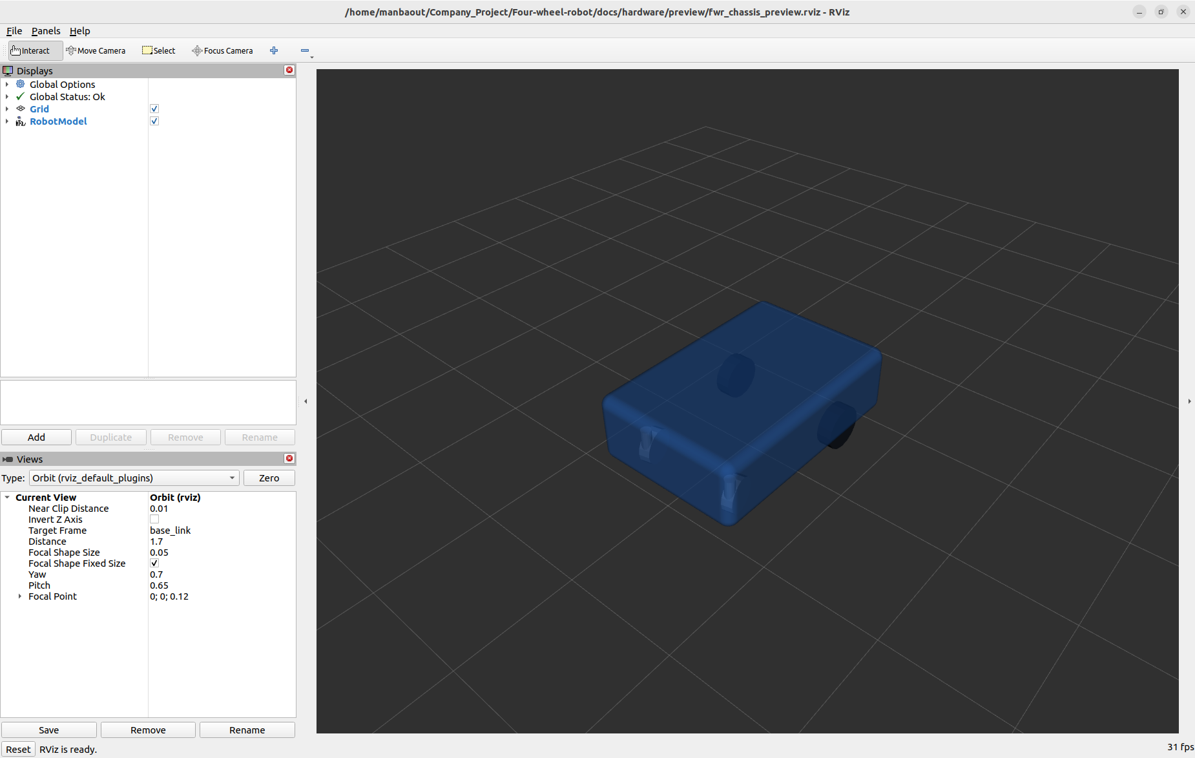
docs/hardware/preview/fwr_chassis_rviz.png
