Yu20040207/pathfinder_robot/docs/hardware/preview/live_scan_2026-10-24.png

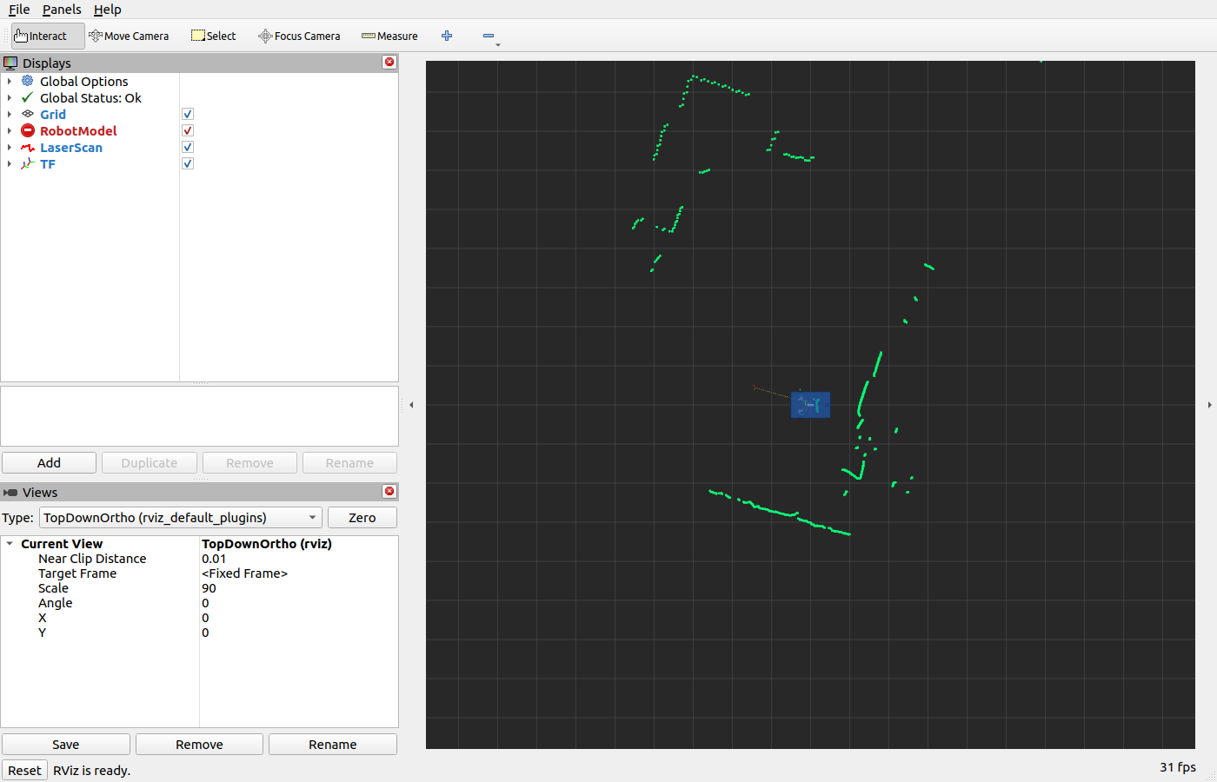
docs/hardware/preview/live_scan_2026-10-24.png
