Yu20040207/pathfinder_robot/docs/map_preview/real_map_2026-10-28_edited_放大.png

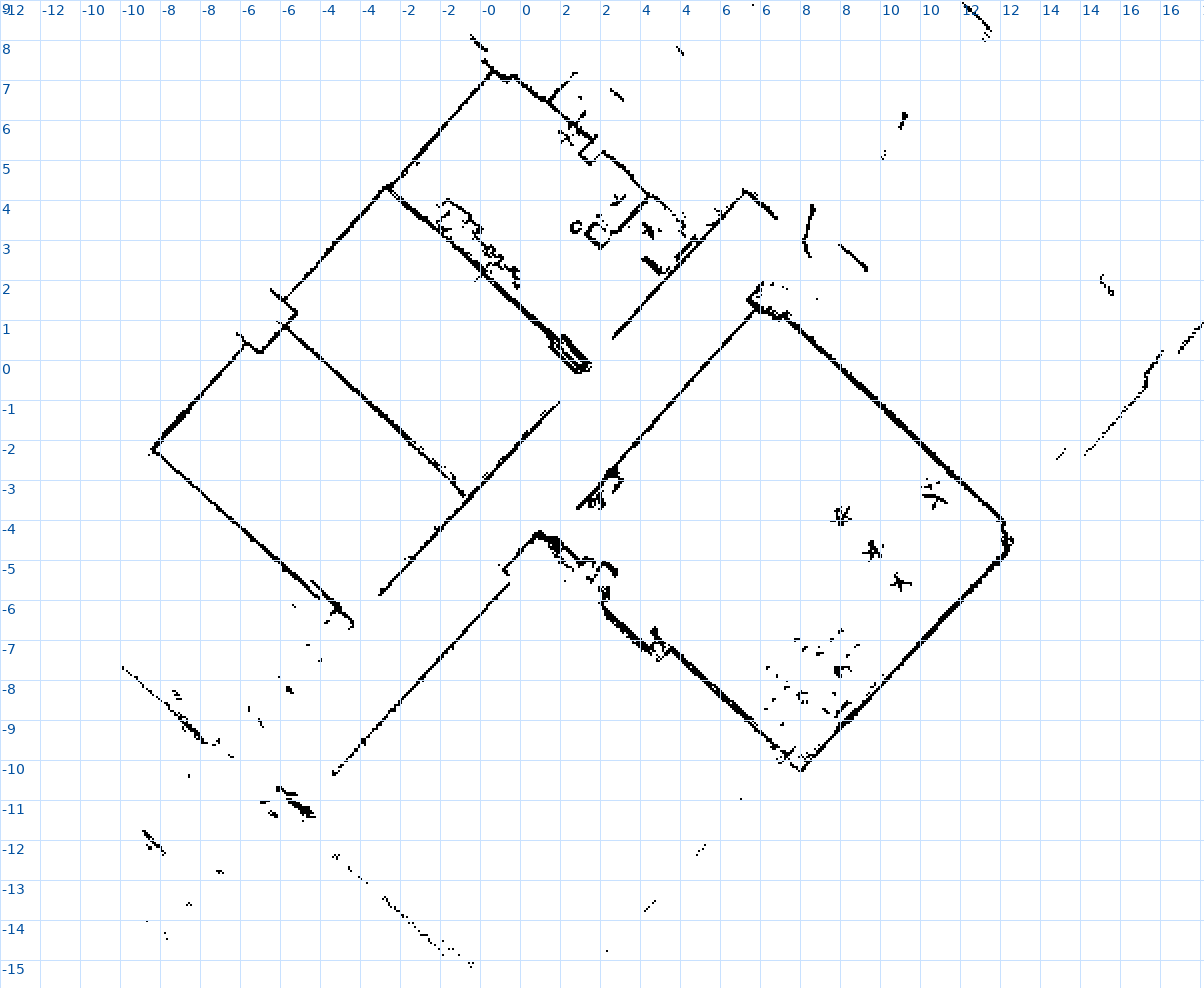
docs/map_preview/real_map_2026-10-28_edited_放大.png
