Yu20040207/pathfinder_robot/docs/map_preview/real_map_rtabmap_今天新图.png

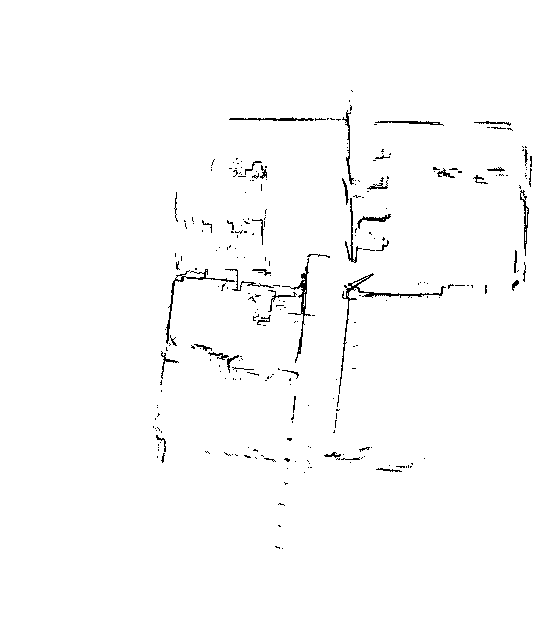
docs/map_preview/real_map_rtabmap_今天新图.png
