Yu20040207/pathfinder_robot/docs/map_preview/所有地图对比.png

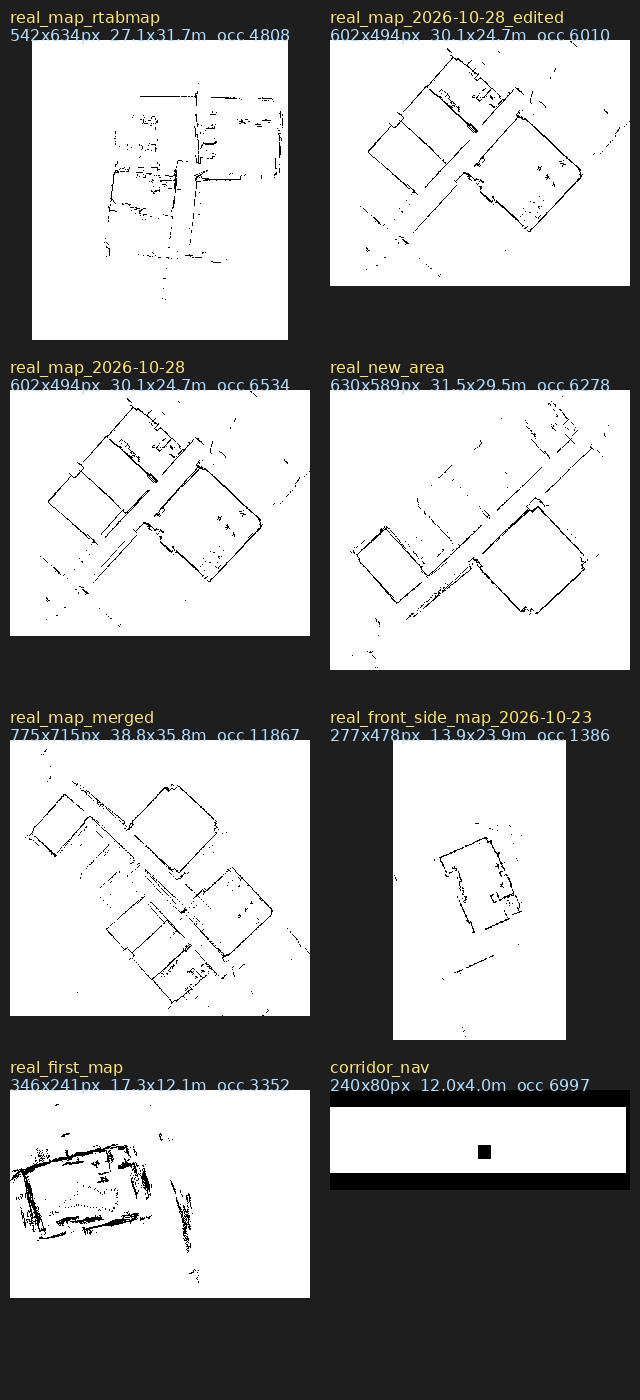
docs/map_preview/所有地图对比.png
