Yu20040207/pathfinder_robot/docs/hardware/preview/fwr_chassis_rounded.stl

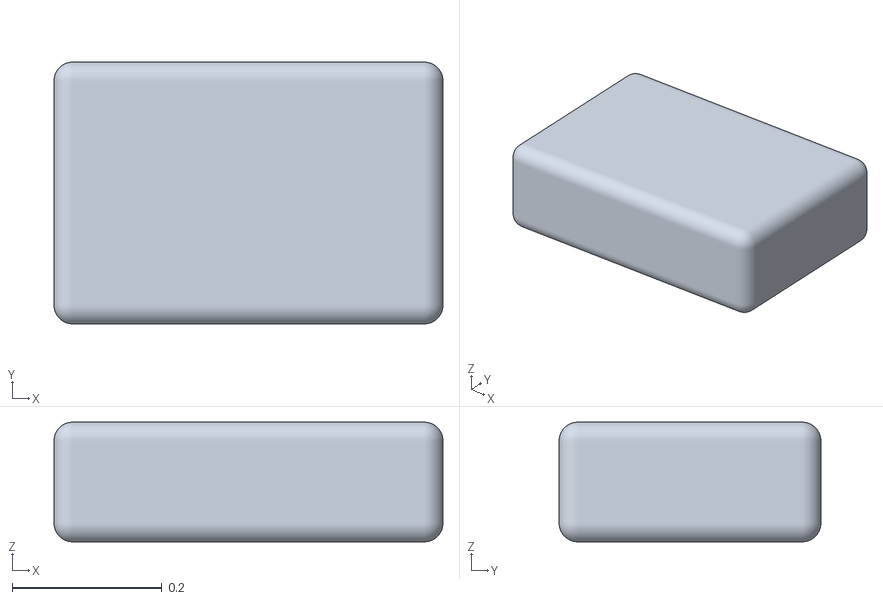
[picture p6: CAD file, 2026-10-13]
docs/hardware/preview/fwr_chassis_rounded.stl
0.52 x 0.35 x 0.16
