Yu20040207/pathfinder_robot/ros2_ws/src/fwr_bringup/description/mg513x_motor_bracket.stl

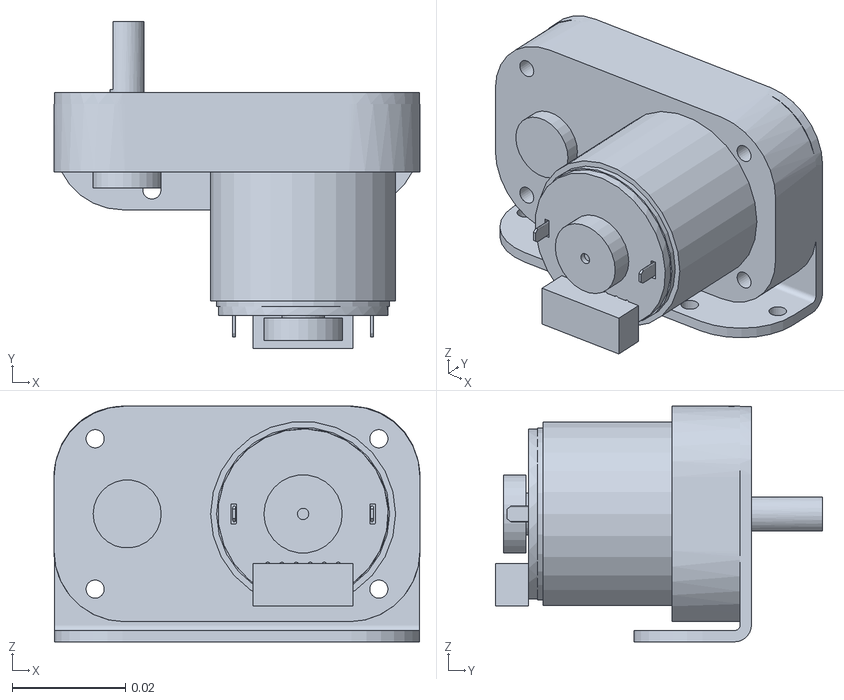
[picture p7: CAD file, 2026-10-29]
ros2_ws/src/fwr_bringup/description/mg513x_motor_bracket.stl
0.0645 x 0.0576 x 0.0415
