Yu20040207/pathfinder_robot/ros2_ws/src/fwr_bringup/description/dm_imu_l1.stl

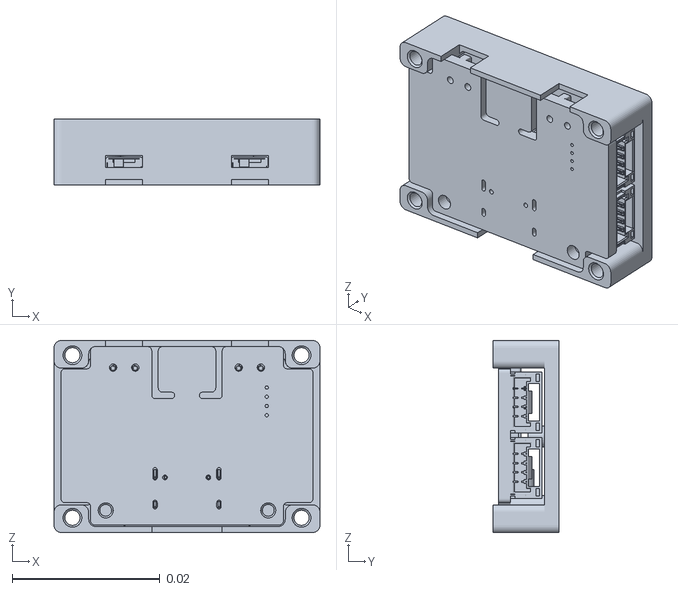
[picture p8: CAD file, 2026-10-29]
ros2_ws/src/fwr_bringup/description/dm_imu_l1.stl
0.036 x 0.009 x 0.026
