Yu20040207/pathfinder_robot/ros2_ws/src/fwr_bringup/description/at8236_d157b.stl

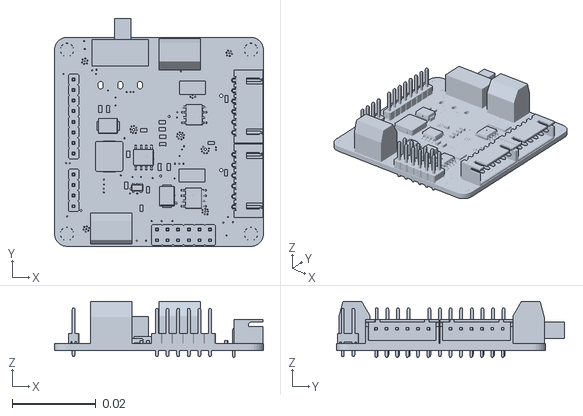
[picture p9: CAD file, 2026-10-29]
ros2_ws/src/fwr_bringup/description/at8236_d157b.stl
0.05 x 0.0545 x 0.0134
