Yu20040207/pathfinder_robot/ros2_ws/src/fwr_bringup/description/rplidar_c1_cad.stl

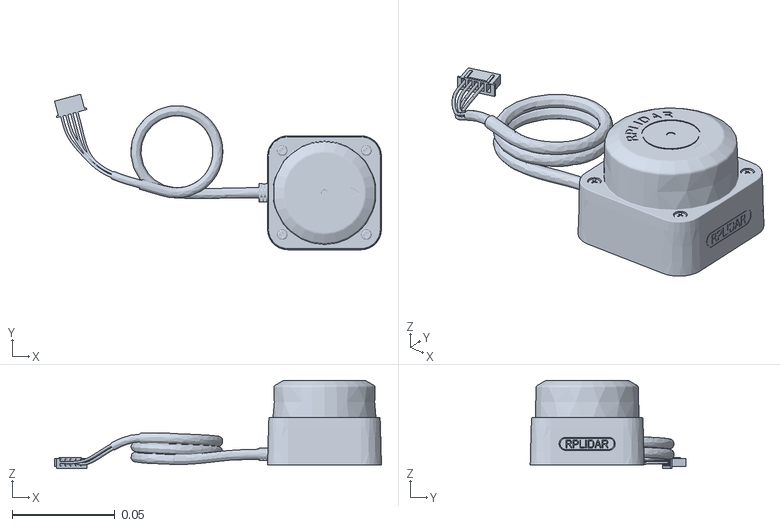
[picture p10: CAD file, 2026-10-29]
ros2_ws/src/fwr_bringup/description/rplidar_c1_cad.stl
0.159 x 0.0759 x 0.0431
