Yu20040207/pathfinder_robot/(list of files, cad)

Other CAD files:
ros2_ws/src/fwr_bringup/description/fwr_chassis_wheel_recesses.stl
