Yu20040207/pathfinder_robot/docs/hardware/wsdc2412d-wiring.md

# WSDC2412D-V3.0 双路驱动 + 24V 电机 + ESP32-S3 接线

> 驱动板：**WSDC2412D-V3.0**（12A/33V 双通道直流有刷，控制端全电气隔离）
> 电机：24V 减速电机 100:1（带 16PPR AB 相霍尔编码器）
> 主控：**ESP32-S3**（3.3V 逻辑）
> 电池：**6S 锂电**（22.2V 标称 / 25.2V 满电；7S 满电 29.4V 也在板子 33V 范围内）

---

## 1. 总览

```
        ┌──────────── 电池 6S ────────────┐
        │  + (经 15A 保险丝)      −       │
        │      │                  │       │
        │      ▼                  ▼       │
        │   P+ ┌──────────────┐ P−        │
        └──────┤ WSDC2412D-V3 │───────────┘
               │   驱动板      │
   ESP32-S3    │              │
   ┌────────┐  │  M1_A M1_B   │  M2_A M2_B
   │ GPIO4 ─┼──┤PWM1          │   │    │
   │ GPIO5 ─┼──┤INA1     M1 ──┼───┘    │   左电机
   │ GPIO12─┼──┤INB1          │        │
   │        │  │              │        │
   │ GPIO6 ─┼──┤PWM2          │        │
   │ GPIO7 ─┼──┤INA2     M2 ──┼────────┘   右电机
   │ GPIO13─┼──┤INB2          │
   │ 3.3V  ─┼──┤VCC(1) (6)    │
   │ GND   ─┼──┤GND(5) (X)    │
   └────────┘  └──────────────┘

   编码器不走驱动板，直接接 ESP32：
   M1: A→GPIO8   B→GPIO9      M2: A→GPIO10  B→GPIO11
```

---

## 2. 功率侧接线（4Pin + 两个电机端子）

| 驱动板端子 | 接到 | 线径 | 说明 |
| --- | --- | --- | --- |
| **P+**（两个端子）| 电池正极（**经保险丝**）| 16 AWG 以上 | **两个都要接**（端子容量限制，手册明确要求）|
| **P−**（两个端子）| 电池负极 | 16 AWG 以上 | 两个都要接 |
| **M1_A / M1_B** | **左**电机两根线 | 18–20 AWG | 交变输出，不分正负 |
| **M2_A / M2_B** | **右**电机两根线 | 18–20 AWG | 同上 |

**保险丝**：每个电机串 10A，或电池总线串 15A 自恢复保险丝。
手册明确写：短路/反接/堵转在无防护时会**永久损坏模块**。

> 转向接反了不用改线 —— 把该电机的两根线对调即可，或改固件里的方向。

---

## 3. 控制侧接线（CN1，2×5 双排针 2.54mm）

| CN1 脚 | 信号 | 接到 ESP32-S3 | 备注 |
| --- | --- | --- | --- |
| 1 | **VCC** | **3.3V** | 必须等于控制信号幅值，**≤5.2V** |
| 2 | **PWM1** | **GPIO4** | 左轮调速，18–60 kHz |
| 3 | **INA1** | **GPIO5** | 左轮方向 A |
| 4 | **INB1** | **GPIO12** | 左轮方向 B（新增）|
| 5 | **GND** | **GND** | |
| 6 | **VCC** | **3.3V** | 与 1 脚同源 |
| 7 | **PWM2** | **GPIO6** | 右轮调速 |
| 8 | **INA2** | **GPIO7** | 右轮方向 A |
| 9 | **INB2** | **GPIO13** | 右轮方向 B（新增）|
| X | **GND** | **GND** | 与 5 脚同源 |

### 为什么这样分配

固件现在用 4 路 PWM（`motor_pins = {4,5,6,7}`）：

| GPIO | 现在 | 改成 |
| --- | --- | --- |
| 4 | 左 正转 PWM | **PWM1** |
| 5 | 左 反转 PWM | **INA1** |
| 6 | 右 反转 PWM | **PWM2** |
| 7 | 右 正转 PWM | **INA2** |
| 12 | — | **INB1**（新接）|
| 13 | — | **INB2**（新接）|

**只多接 2 根线**，原来的 4 根线位置不变，只是含义变了。

---

## 4. 编码器接线（不接驱动板）

| 电机 | 编码器线 | 接到 |
| --- | --- | --- |
| **左 M1** | 红 MOTOR+ / 黑 MOTOR− | （这是电机电源线，接 M1_A/M1_B）|
| | 绿 GND | ESP32 GND |
| | 蓝 Vcc | **先试 3.3V** |
| | 黄 A | **GPIO8** |
| | 白 B | **GPIO9** |
| **右 M2** | 绿 GND | ESP32 GND |
| | 蓝 Vcc | 3.3V |
| | 黄 A | **GPIO10** |
| | 白 B | **GPIO11** |

> ⚠️ **ESP32-S3 的 GPIO 不耐 5V**。编码器若必须 5V 供电，
> A/B 要经电平转换（BSS138 四路模块）或 10k/20k 分压后再进 GPIO。

---

## 5. 上电前必须确认的 5 件事

1. **CN1 的 VCC 是 3.3V**（不是 5V、不是 24V）—— 接错会烧隔离芯片，**不保修**。
2. **严禁用廉价 DC/DC 给 VCC 供电**（上电过冲会烧隔离芯片）——
   直接接 ESP32 板的 3.3V 引脚（板载已是 LDO），它只要 ~15mA。
3. **INA/INB 各加 10kΩ 下拉到 GND**：手册说"输入悬空为高电平"= H,H = **脱机（轮子自由）**；
   加下拉后上电默认 L,L = **制动**，车不会溜坡。
4. **P+ / P− 两组都接**，线径 ≥16 AWG。
5. **先断开电机 12V/24V 上电测控制端**：用万用表量 CN1 的 VCC 确实是 3.3V，再上功率电。

---

## 6. 控制逻辑（手册真值表）

| INA | INB | PWM | 输出 | 电机状态 |
| --- | --- | --- | --- | --- |
| L | L | X | A=L, B=L | **制动** |
| L | H | PWM | A=PWM, B=L | **正转** |
| H | L | PWM | A=L, B=PWM | **反转** |
| H | H | X | A=Z, B=Z | **脱机**（滑行）|

固件 `drive()` 要改成：

```c
// 正转
ina=0; inb=1; pwm(duty);
// 反转
ina=1; inb=0; pwm(-duty);
// 停（建议用脱机，避免 35kg 急刹冲击减速箱）
ina=1; inb=1; pwm(0);
```

> ⚠️ 手册警告：**大能量正反转切换前要先把 PWM 降到 0 再换向**，否则可能损坏驱动。
> 现有固件 `DUTY_RAMP_PER_S 0.5` 会缓慢过零，天然满足。

---

## 7. 配套的固件改动（3 处）

| # | 位置 | 现状 | 改成 |
| --- | --- | --- | --- |
| 1 | `main.c` LEDC `freq_hz` | 10000 | **18000**（手册要求 18–60 kHz）|
| 2 | `main.c` `drive()` | 双 PWM | **PWM + INA/INB**（见上）|
| 3 | `main.c:197` 速度换算 | `210.0f/1468.0f` | **`314.159f/6400.0f`**（100mm 轮 / 100:1）|

以及 ROS 侧：

| 文件 | 参数 | 现在 | 改成 |
| --- | --- | --- | --- |
| `base_bridge_core.py` | `counts_per_rev` | 1468 | **6400** |
| | `circumference_m` | 0.2075 | **0.3142** |
| | `track_m` | 0.262 | 新轮距实测 |
| `base_bridge.py` | `wheel_speed_scale` | 0.66 | **1.0**（新电机要重新标定）|

---

## 8. 上电调试顺序

1. **只接控制线 + 编码器，不接功率电**：确认 CN1 VCC = 3.3V，GPIO 输出正常
2. **接功率电、车轮悬空**：手动发 0.1 前进，看转向指示灯（蓝=正转、红=反转）
3. **确认轮子转向正确**：左前右前应同向；反了对调 M1_A/M1_B
4. **编码器计数校验**：手转一圈车轮，`S2` 帧里的计数应变化 **6400**
5. **落地低速直行 2m**：卷尺量，对比 `/odom`，标定 `circumference_m` / `counts_per_rev`
6. **原地转 10 圈**：对比 IMU 航向，标定 `track_m`
7. 最后才开自动建图/导航

---

## 9. 电机定型（2026-11-05 确认）

**GA36Y-555 带编码器 · 24V · 80 RPM（减速比 100:1）· 出轴 8mm**

| 参数 | 值 | 对 35kg / 100mm 轮的校核 |
| --- | --- | --- |
| 空载转速 | 80 RPM | 0.25 m/s 只需 47.7 RPM（60%）✓ |
| 空载车速 | 0.42 m/s | ≥0.25 ✓ |
| 额定扭矩 | 1.85 N·m | 巡航需 1.0 ✓（1.9×）|
| 堵转扭矩 | 8.83 N·m | 最大牵引 142 N → 加速度 4.1 m/s² ✓ |
| 0.25 m/s 处可用扭矩 | ≈3.56 N·m | 巡航 3.6× / 越 2cm 台阶 1.7× ✓ |
| 编码器 | 16 PPR × 100 = 1600/圈 | ×4 解码 → **6400 counts/轮圈** |
| 功率 | 16 W | 巡航机械约 10 W ✓ |

### 出轴必须选 8mm（不要 6mm）

| 轴径 | 扭转(额定) | 扭转(**堵转**) | 弯曲(轮自重) | 结论 |
| --- | --- | --- | --- | --- |
| 6 mm | 43.6 MPa | **208 MPa** | 97 MPa | ✗ 堵转超许用，弯曲吃满 |
| **8 mm** | 18.4 MPa | 87.8 MPa | **41 MPa** | ✓ 有余量 |

- 每个驱动轮垂向载荷 ≈103 N，悬伸 20mm → 弯矩 2.06 N·m。
  **弯曲是主导载荷，不是扭矩**：6mm 已达 97 MPa（许用 100~150）。
- 6mm 的 D 槽只有 5mm，顶丝易打滑；堵转 8.83 N·m 会扭断。

### 轮子安装要求

1. **不要让齿轮箱输出轴承承受车重** —— 用带轴承的轮毂或加轴承座支撑。
2. 用**夹紧式轮毂**（clamp hub），不要单顶丝。
3. 轮子做动平衡；装好后端面跳动 **< 0.5 mm**。

### 编码器电平（务必处理）

编码器标 **DC5.0V** 供电、输出 0~5V；ESP32-S3 GPIO **不耐 5V**。
优先试 **3.3V 供电**（多数霍尔编码器可用），否则加 BSS138 电平转换或 10k/20k 分压。

### 下单前必须向卖家确认

1. **减速比**（100:1 还是 150:1）—— 决定 `counts/圈 = 64 × 比值`
2. **出轴 8mm**（默认可能发 6mm）
3. 编码器是 **AB 相方波**（不是串口/其它协议）
