Yu20040207/pathfinder_robot/docs/hardware/hp60c-validation.md

# HP60C 实机验收记录

开发电脑：Ubuntu / ROS 2 Humble / x86_64；相机序列号 `ASC60CG21001123`，USB ID `3482:6723`。厂商 SDK `v1.2.28.20241021`，固件 `V01.09_2024110714:V01.19_2024110714:L01`。

## 当前结论（2026-10-09）

**RGB、深度图和点云的 ROS 2 数据链路至少一次打通，HP60C RGB 到 YuNet 的正面人脸检测也已实机通过，但冷启动和持续推流不稳定。** 还未完成多场景画质、深度精度、RGB/深度配准、身份识别稳定性和打卡流程的长期验收。相机在 USB Bus 1 / Port 2 上首次 `start streaming` 后约 1 秒出现 `stop streaming`，有时会自行再次启动。观察到恢复等待约 13、28、40 秒，也有 72–75 秒未恢复的运行；10:24 的原厂测试恢复后数秒又停流。短时 `ros2 topic hz` 无帧不足以证明相机始终不能出帧，但一次有帧也不足以证明稳定性。日志中的 `get mjpeg from xu command failed` 仍然存在，SDK/固件或设备通信异常的具体原因尚未确定。

11:45–11:47（北京时间）补充内容验收：原厂 25 fps 驱动抓得 RGB `bgr8`、640×480，实际图像可辨认室内场景，不是先前 UVC 直读的噪声图。最初镜头朝桌面下方，深度 `16UC1` 仅 7.7% 像素非零，非零值的 10/50/90 分位数为 202/209/221（单位按厂商常见毫米格式推测，尚未用尺标定）。调整镜头朝向约 0.5–2 米外的开阔区域后，RGB 图像可辨认室内设备和背景；深度有效像素增至 52.7%，10/50/90 分位数为 1151/2383/3603，伪彩色深度图能分出近处设备与背景。数据仅保存在本机 `/tmp/` 供诊断，未纳入项目仓库；数值合理性仍需已知距离标定。

同一轮原厂驱动与二代视觉节点分开启动，二代使用 `use_camera_driver:=false` 和 `color_topic`/`depth_topic` 指向原厂话题。`/robot/vision/faces` 约 1.7 Hz 持续发布，抽样消息 `faces: []`；当前画面没有适合验证的正面近距离人脸，故只能确认 RGB 已进入推理节点，不能证明识别准确率或打卡行为。14 秒窗口内收到 RGB 18 帧、深度 10 帧；对每帧深度寻找最近 RGB 时间戳，差值中位数约 73 ms，10 帧中只有 1 帧不超过 50 ms。RGB/深度同步与空间配准仍未通过，`depth_aligned` 保持关闭。

11:48（北京时间）测试参与者面对镜头约 0.7–1.5 米。原厂驱动与二代视觉节点分别运行，`/robot/vision/faces` 连续三次报告一个人脸框，约 `(308,114,145,177)`、`(305,116,154,184)`、`(308,129,148,175)`，均为 `recognized: false`。本轮未采集或保存人脸样本，也未录入身份；测试结束后节点已停止。**HP60C RGB → YuNet 人脸检测的实机链路通过这一次测试**，身份匹配准确率、真实人员录入和打卡仍未验收。

14:10–14:12（北京时间）尝试从实时 RGB 自动提取 `test01` 的录入样本：收到 119 帧，但没有一帧满足“恰好一张清晰人脸”的录入条件。诊断抓帧显示当时画面昏暗且没有可见人脸，故未录入样本。随后相机测试进程到时退出，下一次尝试收到 0 帧。

14:13–14:15（北京时间）重启原厂相机后，采集到一张清晰的单人正面照，作为 `test01` 的 1 张样本录入本机权限为 `0600` 的 SQLite 数据库。二代视觉节点从 HP60C 实时 RGB 识别出 `test01`，单帧分数约 0.681；12 秒复查窗口中收到 24 条人脸消息，24 条均识别为 `test01`，分数范围 0.540–0.660；本机产生 1 条 `test01` 打卡记录，记录分数约 0.659，设备 `chest_hp60c`。测试后相机和视觉节点已停止。**这只证明该测试者在同一场景下的一次录入、识别和打卡成功，不构成识别率评估**；仍需不同光照、姿态、距离及非本人误识别测试。

2026-10-09 10:14–10:15（北京时间）在 USB Port 2 上用 `ros2 launch ascamera hp60c.launch.py`、640×480、25 fps 进行长时采样。恢复出帧后约 62 秒内，探针收到 RGB **238** 条、深度图 **75** 条、点云 **796** 条消息；每条 `data` 非空且至少有一个非零字节，消息时间戳持续前进。这段窗口的平均接收速率分别约 **3.8 Hz、1.2 Hz、12.8 Hz**；这是实际接收速率，不是标称配置帧率，也不证明图像内容或深度数值准确。10:13 的较短采样曾见 RGB 约 0.4 Hz、深度约 1 Hz、点云约 13.5 Hz，因此三路频率仍需优化和稳定性复测。测试结束后相机节点已退出。

2026-10-09 用二代 `vision_attendance.launch.py`、15 fps 多次测试，首轮停流后能自行恢复深度图和约 10 Hz 点云，但 RGB 采样窗口没有收到帧。25 fps 二代整套启动在两次 72–75 秒测试中均未恢复；软件 USB 复位后仍未恢复。因此二代配置目前采用与原厂一致的 25 fps 作为下一轮 RGB 验收起点，**不表示二代 RGB 已通过验收**。视觉启动文件现可通过 `color_topic`、`depth_topic` 参数连接单独运行的厂商节点，便于在相机再次稳定出帧时独立验证人脸识别。

## 2026-10-09 续测：USB 链路故障定位

14:42 和 14:45 两次重启后，原厂 25 fps 驱动分别恢复推流。单个 Python 探针同时订阅 RGB、深度图、点云，90 秒窗口分别收到 1142/1143/1142 帧，65 秒窗口三路各 838 帧；观测平均速率约 12.7/12.9 Hz，最大消息间隔约 0.12–0.17 秒，三路消息时间戳均无倒退。第二次 838 对 RGB/深度消息时间戳完全相同；这不能证明像素空间配准。两次启动均先出现约 1 秒后停流再恢复，且都有 `get mjpeg from xu command failed`；第二次恢复时另见短暂 `wrong size` 告警。由于探针同时处理大量点云，约 13 Hz 只是这个订阅端的实测速率，尚不能断定相机本身只能输出 13 fps。

15:27 再次启动并改用单路 RGB 探针以排除探针瓶颈，60 秒内收到 0 帧。内核日志显示 `usb 1-2` 从 15:27:58 开始重置，15:29:03 起反复报 `device descriptor read/64, error -110`、`device not accepting address, error -62`，随后设备断开，重新枚举失败；厂商驱动同时报 `uvc_open: No such device`。此时 `lsusb` 已找不到 `3482:6723`。**本轮无帧的直接原因是 USB 设备级失联，发生在 ROS 订阅和人脸算法之前。** 无法仅凭日志区分线缆、接头、端口供电和相机硬件故障；需用直连、换线、换口逐项排查。相机此前在 USB 2.0 480M 链路上枚举，`power/control` 为 `auto`，空闲时显示 suspended；这不是活跃推流期间掉线原因的证明。

## 换线与驱动回调修复（2026-10-09 至 2026-10-10）

更换数据线后，HP60C 于 16:21 在同一 USB Bus 1 / Port 2 重新枚举。25 fps 原厂启动在恢复后，单独订阅 RGB 的 20 秒窗口收到 273 帧（约 13.6 Hz），随后日志于 16:24:23 出现 `stop streaming`；深度单路探针接下来的 60 秒没有帧，但 `lsusb` 仍能看到设备。15 fps 对照启动后三路在 65 秒窗口分别收到 616/617/616 帧（探针约 9.5 Hz），随后同样出现 `stop streaming`，而 USB 设备仍在。故换线没有消除**设备仍在线时的停流**；尚无法断定是相机固件、预编译 SDK、USB 数据链路还是主机控制器导致。

另发现厂商 ROS 适配层 `CameraSrv::start()` 把 `onDetached` 回调指向 `onAttached`。2026-10-10 曾尝试改为真正的 `onDetached` 并重建。实机在 USB 断开时触发清理，却在厂商预编译 SDK/libusb 的 `usbi_mutex_destroy` 断言处崩溃（exit code -6）；**已回退该实验改动并重新编译**，等待厂商确认正确的断开清理方式。相机此前于 2026-10-09 17:07 断开，2026-10-10 09:00:52 重新枚举。

2026-10-10 09:01:30 修复版实验驱动启动后，100 秒窗口收到 RGB 1285、深度 1284、点云 1284 帧，探针约 12.8 Hz，时间戳未倒退。原厂 SDK 启动日志仍有 `get mjpeg from xu command failed`，09:01:35 停流、09:01:40 恢复；09:03:18 再停流、09:03:31 恢复。09:03:39 内核记录 USB 设备 16 断开；实验断开回调执行 `stop stream success` 后，进程因 `usbi_mutex_destroy: Assertion pthread_mutex_destroy(mutex) == 0 failed` 退出，ROS launch 自动重启；09:03:47 相机作为设备 17 重新枚举。此断言由实验回调清理路径触发，不能说原厂默认回调也会崩溃。回退后尚未再次实测热插拔。

2026-10-10 09:54 使用移动后的完整工作区及 `install/setup.bash` 兼容入口复测：`ros2 pkg prefix ascamera` 正确指向 `install_c8b11ea9f764/ascamera`，启动文件通过 Python 语法检查，并从新安装目录加载 HP60C 配置。90 秒订阅窗口收到 RGB 1140、深度 1139、点云 1139 帧，分别为 640×480 `bgr8`、640×480 `16UC1` 和点云消息，最大消息间隔约 0.11–0.13 秒，时间戳无倒退。**迁移路径问题已解决。** 但厂商日志仍有 `get mjpeg from xu command failed`；09:54:30 停流、09:54:48 恢复，09:56:15 再停流，直至测试在 09:56:30 到时前未见恢复。此时 USB 设备仍在 `lsusb` 中，内核本轮无 USB 断连日志。在线停流仍未解决，和路径故障无关。

2026-10-10 09:57–10:04 帧率对照：默认启动文件当前 `color_pcl: True`，单独订阅 RGB 25 秒收到 340 帧，按首末接收时间计算约 13.55 Hz；消息时间戳间隔相同，接收时消息时间戳年龄中位数约 14.2 ms。测试时另一个终端重叠启动第二个驱动，第二进程报 `uvc_open: Busy`，不能把该重叠时段用于稳定性结论。用户停止第二进程后，用临时启动文件仅将 `color_pcl` 设为 `False`，保持 640×480、25 fps；单实例 RGB 25 秒收到 341 帧（13.57 Hz），深度 25 秒收到 340 帧（13.55 Hz），时间戳年龄中位数分别约 14.1/13.3 ms。关闭彩色点云没有改善实际观测帧率；时间戳年龄很小，卡顿主要不是 ROS 订阅端积压。此轮驱动仍有 `get mjpeg from xu command failed`、`wrong size` 及间歇停流，USB 设备仍在线。测试驱动已停止。

2026-10-10 11:03 对照截图：Windows Angstrong Viewer V2.1.10_240109 处于 **2D** 模式，RGB 与 Depth 均显示 640×480、31 fps；截图没有展示点云是因为没有切换到 3D 视图，不能据此判定设备无点云。Linux 厂商 ROS 2 驱动即使没有点云订阅者，也会在每帧调用点云处理；临时跳过该调用并重建后，单实例 RGB 25 秒实收 341 帧、13.57 Hz，时间戳频率同为 13.57 Hz，中位消息年龄约 14.1 ms，与未跳过时的 13.55 Hz 基本相同。实验改动已恢复并重新编译。Windows 截图与 Linux 使用的主机、USB 端口、供电和采样口径是否一致尚未确认，因此不能单凭截图归因于 Ubuntu 系统配置。

用户随后提供 Windows Viewer **3D** 截图：`Cloud#1` 为 640×480、显示 31 fps，画面中有白色点云及坐标轴。由此确认 Windows 上位机能生成并显示点云；之前 2D 截图未显示点云只是视图选择。该截图支持相机在 Windows 组合下三路工作，但不能单凭显示帧率判断 Windows 与 Linux SDK 的采样方式一致，也不能排除 Linux 主机 USB/供电差异。

2026-10-10 11:10 用临时启动文件将 Linux 原厂 ROS 2 驱动由 25 fps 改为 30 fps，RGB/深度仍为 640×480、`color_pcl: True`。HP60C 在 Bus 1 / Port 2 以 480M 枚举；单实例 RGB 25 秒收到 374 帧，接收和消息时间戳频率均为 **14.88 Hz**，中位消息年龄 14.1 ms。日志 11:10:20 报 `get mjpeg from xu command failed`；11:10:20 开流、11:10:21 停流、11:10:23 再开流、11:10:51 再停流。相比 25 fps 配置的约 13.55 Hz，调到 30 fps 仅小幅增加实收帧率，未达到设置值；默认启动文件未改，测试进程已停止。尚未确认 Windows 测试是否为同一主机及 USB 端口，亦不应把 Windows Viewer 显示值当作与 ROS 消息到达率完全相同的测量口径。

随后用户在**这台双系统电脑的 Windows** 上测试并提供 2D/3D 截图：Angstrong Viewer 中 640×480 RGB、Depth、Cloud 均显示约 **16 fps**，三路画面可见。与这台电脑 Ubuntu 上 30 fps 配置时 RGB 实收 14.88 Hz 接近；先前约 31 fps 的 Windows 截图来自另一台电脑。由此不支持“Ubuntu 系统配置单独导致帧率减半”的判断，优先排查这台电脑的 USB 端口/控制器、链路速率、供电及 Viewer 的深度和彩色流配置。仍需确认 Windows 测试的具体物理端口、线缆、连接速率与两个环境的实际流配置；跨软件的显示值和 ROS 消息频率并非严格同口径。Linux 另有间歇停流/USB 断连，不能因两系统帧率接近就认定该稳定性问题已解决。

用户换到本机另一个物理 USB 插口后，Ubuntu 检测 HP60C 从此前 Bus 1 / Port 2 变为 **Bus 1 / Port 6**，但仍以 **480M** 枚举。保持同一临时 640×480、30 fps 启动配置，RGB 25 秒实收 374 帧、**14.90 Hz**，消息时间戳频率也为 14.90 Hz；之前 Port 2 为 14.88 Hz，换口未改善帧率。11:25:35 日志仍有 `get mjpeg from xu command failed`，11:25:35 开流、11:25:36 停流、11:25:41 恢复、11:26:09 再停流。本轮节点已停止，默认启动文件未改。两个插口均为 480M 并不单独证明 USB 带宽不足；需厂商确认相机设计连接速率和该模式应达到的持续帧率。

后续读取 HP60C USB 描述符：`bcdUSB 2.00`、`MaxPower 500mA`，UVC 视频帧描述符列有 `dwFrameInterval 333333`（约 30 fps）。这说明相机当前向主机声明 USB 2.0 能力且具有 30 fps 模式；其在 USB 3.x 插口仍以 480M 枚举并非插口故障证据。该描述符不能说明 RGB+深度同时工作时该主机能持续达到 30 fps。当前同机 Windows Viewer 约 16 fps、Linux ROS RGB 约 15 fps，而另一台电脑 Viewer 约 31 fps：更应比较主机 USB 控制器、供电、线缆和实际流组合。之前建议换 USB 3.x 插口以提升连接速率过于武断，不应把 480M 本身当成待修复的配置错误。

用户确认**同一 HP60C 和线缆**在办公本 Windows 上仍约 31 fps。11:28 后本机读取 USB 详细描述符期间，`usb 1-6` 反复记录 `device descriptor read/64, error -110`、`device not accepting address ... error -62`、xHCI setup command timeout，并在 11:29:34 断开，之后未能重新枚举。此故障发生在诊断性 USB 控制读取期间，不能据此说相机在空闲时自发断连；但也确认本机该端口/控制器与相机通信不稳定。两个已试端口均映射到 Intel `0000:00:14.0` xHCI 控制器，换口并未切换到独立控制器。当前设备已从 `lsusb -t` 消失，下一次实机测试需重新插接。排查优先级：在不改变流设置的前提下，单独测试外部供电/不同控制器路径，记录帧率及 USB 错误；尚不能把原因定为供电不足或主板故障。

14:07 用户改经 USB 3.0 扩展坞接入。`lsusb -t` 显示 HP60C 在 Bus 1 / Port 2 下的 USB 2.0 集线器 Port 1，以 480M 连接；同一 hub 还有 `r8152` 网口，控制器仍是本机 Intel xHCI。单独运行临时 640×480、30 fps ROS 驱动时，RGB 25 秒收到 375 帧、**14.93 Hz**（直连 Port 2/6 为 14.88/14.90 Hz），中位消息年龄 14.1 ms，扩展坞未改善帧率。首次实验在约 26 秒后驱动反复报 `startStreaming: not support media type`，后续未能继续出帧；期间相机仍在 USB 总线上，内核未见新的 `-110`/`-62` 错误。14:09:13 另一个终端启动了默认 25 fps 原厂驱动，之后我方第二次启动报 `uvc_open: Busy`，故第二次的深度/点云短采样约 13.65 Hz 属于那个 25 fps 实例，不能作为我方 30 fps 复测。第二次实验进程已停止，未改默认配置。后来该 25 fps 实例停止，故不能据其停止后的无帧探针判断扩展坞持续性。此扩展坞供电方式尚未确认，不能用本轮结果排除外部供电方案。

15:29 继续深度链路验收，使用默认 640×480、25 fps 厂商驱动。20 秒窗口 RGB 收到 273 帧（13.54 Hz），深度 272 帧（13.56 Hz），两路消息时间戳最近差中位和 90 分位均为 0 ms；但抽样 6 张 `16UC1` 深度图有效非零像素均为 **0%**，点云订阅收到 0 帧。抓取的 RGB 画面几乎全黑，仅见灯光轮廓，镜头当前指向的场景不适合验证深度精度。厂商日志启动时仍有 `get mjpeg from xu command failed`、短暂停流。需在明亮、非玻璃、约 0.5–2 米目标前复测有效像素和点云；当前不能据此认定深度硬件故障。此轮 RGB/深度时间戳对齐只是消息级观察，不能证明空间配准正确，`depth_aligned` 继续关闭。

## 厂商启动文件的路径修复

厂商工作区已移到本项目的 `ascam_ros2_ws/`。原 `hp60c.launch.py` 的 `confiPath` 仍指向 `/home/manbaout/ascam_ros2_ws/...`，会导致原厂启动命令找不到配置。已将其改为通过 ROS 2 的 `ascamera` 包位置自动定位，并让 CMake 安装 `configurationfiles/`。`--symlink-install` 会把配置文件装成符号链接；厂商 `CameraSrv::scanDir` 原本只接受 `DT_REG`，因此还需识别指向普通文件的 `DT_LNK`。重建后原厂命令能从安装目录读取 `hp60c_v2_00_20230704_configEncrypt.json` 并发布三路消息。

上述厂商源码目录被二代 `.gitignore` 排除。可重用的修改保存在 [`patches/ascamera-portable-config.patch`](../../patches/ascamera-portable-config.patch)；重新解压原始 `src.zip` 后，在厂商工作区运行 `patch -p1 < ../patches/ascamera-portable-config.patch`，再按 README 重建 `ascamera`。当前目录已应用补丁，不要重复应用。

## 未完成的实机验收

| 检查项 | 状态 |
| --- | --- |
| USB 枚举、厂商配置加载 | Port 2 已通过；Port 6 上早期短时测试无帧，不能据此证明端口是根因 |
| RGB、深度、点云消息 | Port 2 曾长时收到非空、非全零消息；多次启动不稳定 |
| RGB/深度图像内容与编码 | 已目视检查一组室内画面，`bgr8` / `16UC1`；需已知距离标定及多场景测试 |
| RGB/深度时间同步与空间配准 | 最近帧时间差中位数约 73 ms，尚未验证空间配准；`depth_aligned` 保持关闭 |
| 胸口安装外参 | 未标定 |
| 人脸录入、识别、打卡 | `test01` 单样本录入、同场景 24/24 帧识别和 1 条打卡记录通过；识别率、误识率与活体检测未验收 |
| 长时间运行与重新插拔 | 新增 90 秒和 65 秒稳定采样；下一次启动时 USB 描述符超时并失联，未通过 |

2026-10-04 和 2026-10-09 09:55 的测试均只等待约 10–20 秒，当时在 Port 6 看到初始 `stop streaming`、RGB 无帧。当前长时测试推翻了“设备始终无法出帧”的旧结论，不能将那几次短测试作为固件不兼容的证明。标准 UVC `/dev/video0` 仍不能直接提供可用 RGB：默认 YUYV 曾返回打包/噪声画面，MJPEG 1280×720 的 10 秒测试无帧；应使用厂商 SDK。

如后续长时运行仍出现无帧，先记录 USB 端口、启动时间、首次停流和恢复时间、三路实际接收帧率，再将完整日志提供给供应商。公开[同类故障报告](https://github.com/YahboomTechnology/Nuwa-HP60C-Depth-Camera/issues/1)提出 SDK/固件兼容性疑问，但本机现在能恢复出帧，不能直接套用其结论。不要自行刷写未经厂商验证的固件。
