Yu20040207/pathfinder_robot/ros2_ws/src/fwr_bringup/config/real_frontier_exploration.yaml

# 2026-10-31 适配本车（frontier_exploration_ros2）
frontier_explorer:
  ros__parameters:

    # --------------- TOPICS --------------- #

    # Occupancy grid topic used to compute frontiers.
    map_topic: /map

    # Global costmap topic used to filter candidate frontiers.
    costmap_topic: /global_costmap/costmap

    # Local costmap topic used to invalidate nearby blocked frontier goals.
    local_costmap_topic: /local_costmap/costmap

    # Nav2 NavigateToPose action name.
    navigate_to_pose_action_name: navigate_to_pose

    # Global frame used for frontier goals and TF lookups.
    global_frame: map
 
    # Robot base frame used for TF lookups.
    robot_base_frame: base_footprint

    # MarkerArray topic used for frontier visualization in RViz.
    frontier_marker_topic: /explore/frontiers

    # Pose topic used to publish the currently selected frontier target for debugging.
    selected_frontier_topic: /explore/selected_frontier

    # OccupancyGrid topic used to publish the optimized decision map for debugging.
    optimized_map_topic: /explore/optimized_map

    # Requires `completion_event_enabled: true` 
    completion_event_topic: exploration_complete

    # Marker size for frontier visualization.
    frontier_marker_scale: 0.15

    # --------------- QoS --------------- #
        
    # Map QoS profile selection.
    map_qos_durability: transient_local
    map_qos_reliability: reliable
    map_qos_depth: 1

    # Optional startup-only map durability autodetect helper.
    map_qos_autodetect_on_startup: false
    map_qos_autodetect_timeout_s: 5.0

    # Costmap QoS profile selection (durability is fixed volatile in code).
    costmap_qos_reliability: reliable
    costmap_qos_depth: 10
    local_costmap_qos_reliability: inherit
    local_costmap_qos_depth: -1

    # --------------- GENERAL --------------- #

    # Refresh Rate of the package.
    # `1.0` is recommended. Use `2.0` if your robot is very fast. 
    # Use `0.50` if your mapping is slow and you want lowest CPU usage.  
    map_processing_rate_hz: 0.5       # 每秒只处理 2 次地图，减少目标抖动

    # Start exploration immediately at launch.
    autostart: true

    # Keep the optional runtime control service available for manual stop/start flows.
    control_service_enabled: true     # 允许 frontier_exploration_ctl stop 紧急停止

    # Publish a completion event so product-specific integrations can react outside the package.
    completion_event_enabled: true

    # Allow a farther frontier fallback until the first successful frontier.
    # Useful if you have a very low range LiDAR or Depth sensor.
    escape_enabled: true

    # Return to the recorded start pose once no frontiers remain.
    return_to_start_on_complete: true      # 扫完回起点

    # "dp" optimizes traveling distance by comparing posibilities with limited depth. Increasing efficiency but adds extra CPU overhead.
    # "greedy" traverses the full MRTSP matrix one step at a time. Cost free.
    mrtsp_solver: dp
    # Maximum number of scored frontier candidates passed into the bounded-horizon dp solver.
    dp_solver_candidate_limit: 12
    # Number of distinct frontier visits evaluated in the candidate pool.
    dp_planning_horizon: 8

    # Enable decision-map preprocessing for frontier extraction. 
    # Disable only if you are having performance issues. Not a problem for most CPUs.
    frontier_map_optimization_enabled: true

    # Replan while navigating if target-pose visible reveal gain for active goal is exhausted.
    # Disable if you are having performance issues.
    goal_preemption_enabled: false    # 关掉抢占：原来每 2 s 换目标，Nav2 反复重规划 → 原地左右转

     # Minimum seconds between consecutive goal preemption attempts.
    # Also effects performance.
    goal_preemption_min_interval_s: 6.0

    # Skip the active frontier goal if it becomes blocked.
    goal_skip_on_blocked_goal: true

    # Enable the post-goal settle delay after a successful frontier goal.
    # Useful if you want stability over speed. Use if you have slow SLAM & LiDAR configuration. 
    post_goal_settle_enabled: true    # 到点后停 2 s 再选下一个，地图更稳

    # Minimum seconds to wait before selecting the next frontier after a successful goal.
    post_goal_min_settle: 2.0

    # Enable temporary suppression for frontiers that repeatedly fail or stall.
    # Use if you are having issues with SLAM or Nav2.
    frontier_suppression_enabled: true     # 门进不去就抑制，别反复撞

    # Behavior when frontiers exist but all of them are temporarily suppressed: stay or return_to_start. 
    # Requires `frontier_suppression_enabled: true`
    all_frontiers_suppressed_behavior: return_to_start


    # --------------- Algorithm Configuration - Advanced Users --------------- #

    # --------------- MRTSP Scoring --------------- #

    # Weight applied to the path-cost term in the frontier cost matrix.
    # Increasing this makes the explorer more distance-sensitive and conservative.
    # Decreasing it makes information gain dominate more often.
    # Example: 2.0 prefers closer frontiers, 0.5 allows farther high-gain picks.
    # 2026-10-31：加大距离权重 → 优先把附近（当前房间）扫完再去远处大前沿
    weight_distance_wd: 2.5

    # Weight applied to the frontier information-gain term.
    # Larger values favor large frontier clusters that promise more map expansion.
    # Smaller values make the robot clean up nearby small frontiers first.
    # Example: 2.0 may skip small room corners, 0.5 tends to clear them sooner.
    # 信息增益权重降低，避免“远处一大片未知”把车从房间勾走
    weight_gain_ws: 0.6

    # Max linear speed used only in the lower-bound time term.
    # It does not command the robot directly; it estimates how fast a frontier
    # can be reached when building the first row of the cost matrix.
    # Larger values reduce the time penalty of distant frontiers.
    max_linear_speed_vmax: 0.15            # 本车巡航速度

    # Max angular speed used in the heading-change part of time lower bound.
    # This matters most when candidate frontiers require large initial turns.
    # Larger values reduce the penalty of reorientation-heavy options.
    # Example: low values prefer frontiers already near the current heading.
    max_angular_speed_wmax: 1.0

    # Effective sensor range subtracted inside the paper's path-cost term.
    # Larger values reduce the effective traversal penalty between frontiers.
    # This favors frontiers that can reveal more space from farther away.
    # Example: 0.5 makes costs distance-heavy, 2.0 rewards sensing reach more.
    # Doesn't have to be a real sensor value. Used for distance scoring.
    sensor_effective_range_m: 2.0


    # --------------- Navigation Safety --------------- #

    # Minimum distance before a frontier is considered a valid target.
    # Used for dispatch not filterization.
    # Recommended value: 2.5x size of robot's radius
    frontier_selection_min_distance: 0.8

    # Distance used to treat a frontier region as recently visited.
    # Use if you are having navigation loops.
    frontier_visit_tolerance: 0.40


    # --------------- Map Optimization --------------- #

    # Minimum allowed distance from robot to a consider a frontier point as valid.
    # This prevents selecting trivially close frontiers that do not move exploration.
    # Higher values reduce local dithering but can skip useful nearby openings.
    # Example: 0.25 allows immediate local cleanup, 0.5 forces a small commit distance.
    # Recommended value: 2.5x size of robot's radius
    frontier_candidate_min_goal_distance_m: 0.8

    # Occupancy threshold applied to the global costmap during frontier validation.
    # Neighbor cells at or above this cost are treated as blocked for frontier tests.
    # Lower values make the explorer avoid inflated-cost regions more aggressively.
    # Higher values allow frontiers closer to obstacles and inflation bands.
    # Value between 0-100. Use higher values if exploration skips very small areas.
    occ_threshold: 65

    # Minimum connected frontier size accepted by WFD, measured in cells.
    # This removes tiny fragments caused by noise or partial unknown boundaries.
    # Lower values increase responsiveness but can create jittery micro-goals.
    # Higher values stabilize behavior but may ignore narrow real openings.
    min_frontier_size_cells: 16        # 忽略小前沿（墙缝里的假前沿）             # 忽略极小的前沿（地图格子 0.05 m）

    # Spatial sigma of the bilateral filter in map cells.
    # Larger values smooth over wider neighborhoods before frontier extraction.
    # Too low preserves noise; too high can merge narrow openings unrealistically.
    # Example: 1.0 keeps details sharp, 3.0 makes corridors look cleaner but broader.
    sigma_s: 2.0

    # Range sigma of the bilateral filter in occupancy-image intensity space.
    # Larger values let dissimilar neighboring cells influence each other more.
    # Small values preserve occupancy edges; large values can blur free/unknown borders.
    # Example: 10.0 is edge-preserving, 50.0 is much more permissive.
    sigma_r: 30.0

    # Free-space dilation radius after bilateral filtering, measured in cells.
    # This expands filtered free regions before running WFD on the optimized map.
    # Higher values help bridge tiny gaps, but can also over-open door thresholds.
    # Example: 0 keeps the map literal, 2 can merge thin fragmented frontiers.
    dilation_kernel_radius_cells: 1


    # --------------- Preemption --------------- #

    # Treat the current frontier as complete once the robot is this close to it; 0.0 disables this shortcut.
    # This close-enough guard also works when visible-gain preemption is disabled, but obstacle-avoidance-heavy robots should use it carefully because large values can end a frontier too early and trigger wrong exploration choices.
    goal_preemption_complete_if_within_m: 0.50

    # LiDAR range in meters used by the map-based visible reveal gate above.
    goal_preemption_lidar_range_m: 8.0      # C1 实际有效距离

    # LiDAR field of view in degrees used by the visible reveal gate above.
    goal_preemption_lidar_fov_deg: 250.0   # 本车雷达实测有效视场（后方 ±55° 被车身挡）

    # Angular spacing in degrees between LiDAR ray-cast samples for visible reveal estimation above.
    goal_preemption_lidar_ray_step_deg: 1.0

    # Minimum visible reveal length in meters required to keep the current goal instead of preempting.
    goal_preemption_lidar_min_reveal_length_m: 0.5

    # Additional yaw offset in degrees applied to the target-pose LiDAR heading model above.
    goal_preemption_lidar_yaw_offset_deg: 0.0


    # --------------- Suppression --------------- #

    # Number of failed attempts before a frontier area is temporarily suppressed.
    frontier_suppression_attempt_threshold: 2

    # Initial side length in meters for a newly suppressed square area.
    frontier_suppression_base_size_m: 1.0

    # Additional outer ring width in meters used to detect nearby repeated failures and expand suppression.
    frontier_suppression_expansion_size_m: 0.5

    # Suppression entry lifetime in seconds before old regions and attempts are removed.
    frontier_suppression_timeout_s: 90.0

    # Maximum allowed time in seconds without meaningful progress before a frontier goal is canceled.
    frontier_suppression_no_progress_timeout_s: 20.0

    # Minimum distance_remaining improvement in meters required to count as progress.
    frontier_suppression_progress_epsilon_m: 0.25

    # Delay suppression activation during startup so late navigation bring-up does not poison frontier memory.
    frontier_suppression_startup_grace_period_s: 15.0

    # Maximum number of tracked failed frontier attempt records kept in memory.
    frontier_suppression_max_attempt_records: 256

    # Maximum number of active suppressed regions kept in memory.
    frontier_suppression_max_regions: 64
