Yu20040207/pathfinder_robot/ros2_ws/src/fwr_bringup/config/hp60c.yaml

/ascamera_hp60c/camera_publisher:
  ros__parameters:
    usb_bus_no: -1
    usb_path: "null"
    color_pcl: false
    pub_tfTree: true
    depth_width: 640
    depth_height: 480
    rgb_width: 640
    rgb_height: 480
    fps: 25
