Yu20040207/pathfinder_robot/(commit log)

2026-10-13 docs(project): add robot source and hardware selection records
    [corridor_c1.sdf, fwr_chassis_demo.urdf, fwr_chassis_preview.urdf, fwr_chassis_rounded.stl]
2026-10-18 docs: design real Nav2 and IMU turn integration
2026-10-18 feat: establish versioned ESP32 base serial protocol
2026-10-18 feat: add exclusive real chassis bridge and wheel odometry
2026-10-18 fix: bound continuous wheel stall time under load
    [control.c, test_control.c]
2026-10-18 feat: add real sensor fusion and mapping bringup config
2026-10-18 feat: add bounded IMU relative turn action and command arbitration
2026-10-18 Add gated real Nav2 bringup and sensor safety checks
2026-10-19 Tune supervised keyboard drive for loaded chassis
2026-10-19 Use GNOME key repeat for supervised teleop and log stall context
2026-10-20 Add isolated Gazebo keyboard mapping workflow
    [corridor_c1.sdf]
2026-10-20 Retry ESP32 bench handshake before motion
2026-10-20 Record grounded left and right turn diagnostics
2026-10-20 feat: record recent track and check bounded reverse path
2026-10-20 feat: gate automatic velocity and bounded recovery permits
2026-10-29 feat: real-robot navigation bring-up, firmware false-positive fixes, calibration tools
    Firmware (ESP32-S3 base control)
    - relax stall detection: STALL_SPEED 4 mm/s, floor 12% of demand, 2.0 s window
    (previously 8 mm/s / 25% / 0.8 s made any command >80 mm/s trip BASE_STALL)
    - relax overspeed: 700 mm/s over 0.4 s (wheel slip on tile exceeded 420 mm/s)
    - keep MAX_DUTY .90 / BASE_DUTY .60 / ramp .5
    - update host tests for the new thresholds
    base_bridge
    - heading hold on the manual path (IMU yaw, gain 1.5, clamp 0.12 rad/s)
    - sensor_timeout_s 0.5 wired into scan/IMU watchdogs
    - ignore explore "stopped" while a nav goal is active (two-point handover)
    - 3 s debounce before disarming on explore-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
    [at8236_d157b.stl, corridor_c1.sdf, dm_imu_l1.stl, fwr_chassis_demo.urdf, fwr_chassis_wheel_recesses.stl, mg513x_motor_bracket.stl, rplidar_c1_cad.stl]
2026-10-29 docs: add Jetson Orin Nano migration runbook
    - 9 phases from JetPack 6.2 setup through functional acceptance
    - third-party packages (sllidar_ros2, m-explore-ros2, map_edit) cloned
    separately and restored with the patches under patches/
    - explicit do-not list (no install/ or .venv copy, no JetPack 7/Jazzy)
    - checklist and systemd autostart sample
2026-10-29 feat(jetson): one-shot bootstrap script for the Orin Nano
    - tools/bootstrap_jetson.sh: idempotent, 7 steps (env check, base packages,
    swap, ROS 2 Humble + nav2/slam_toolbox/robot_localization, code clone with
    the three third-party repos and their patches, DDS/.bashrc/dialout setup,
    colcon build, self-check); flags --yes/--skip-build/--skip-upgrade/--jobs
    - docs/jetson_migration.md: link the script as phase 0.5
2026-10-30 feat: tire re-calibration, map alignment check, optional IMU yaw scale
    - odometry: circumference 0.2012 -> 0.2075 m, track 0.268 -> 0.262 m
    (3 m tape test after the rubber tires: +0.20 % error)
    - tools/map_align_check.py: measures the live scan to map distance and
    prints ok/warn/bad (this is what exposed the 25 cm misalignment that
    map->odom alone could not show)
    - fwr_imu: optional yaw_scale parameter (measured 1.0127 with a lidar
    cross-correlation ground truth; disabled by default because enabling
    it did not improve the 120 degree alignment)
    - slam: loop_search_maximum_distance 8.0 -> 4.0, minimum_angle_penalty
    0.8 -> 1.2, map_update_interval 2.0 -> 1.0
    - kb.sh: sources ROS/wor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
2026-10-30 fix: scale IMU gyro rate by measured 1.86% shortfall (fixes turn drift)
    The DM-IMU-L1 integrates yaw ~1.9 % short. The EKF consumes /imu/data_raw,
    so it uses only vyaw and never the attitude quaternion - scaling the
    published attitude had no effect.
    Lidar cross-correlation ground truth over a full turn (residual 2.3 cm):
    true 362.58 deg, AHRS 355.06 deg, raw gyro 355.84 deg.
    Scaling angular_velocity.z by 1.019 in the IMU node takes the scan/map
    misalignment after a 120 deg turn from 15.0 cm down to 5.0 cm (the map
    resolution floor); tools/map_align_check.py reports ok instead of warn.
2026-10-30 fix(nav): stable AMCL, persistent arm, wider inflation, gentler turns
    - real_localization.yaml: disable AMCL random particle injection
    (recovery_alpha_* 0 -> 0). It was re-sprinkling particles in a
    repetitive room and the pose jumped metres while the robot stood still.
    update_min_d/a 0.05 -> 0.10 to stop noise-driven updates.
    - base_bridge: /base/arm_auto waits up to 1.5 s for the gates/sensors and
    reports the concrete reason; a successful arm clears the explore-stopped
    debounce timer (it used to expire immediately because 'stopped' had been
    streaming for minutes, so the arm was revoked on the very next tick).
    - real_nav2.yaml: inflation 0.20 -> 0.30 (0.20 made the planner hug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
2026-10-30 fix(nav): auto-recover the stuck collision monitor; stronger obstacle avoidance
    Root cause of 'clicked start navigation, nothing happens': Nav2's
    collision_monitor stops processing after it has fired a stop action once.
    /cmd_vel_auto_unchecked keeps arriving at 20 Hz while
    /cmd_vel_auto_forward_filtered goes completely silent, so
    /cmd_vel_auto_safe stays at zero forever. A lifecycle deactivate/activate
    restores it instantly.
    - tools/chain_watchdog.py: watches input vs output rates and restarts both
    monitors when the output goes silent for 2 s while the input is alive.
    (The internal dict is named _change_clients: overriding rclpy's _clients
    with a dict crashes destroy_node.)
    - real_nav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
2026-10-30 feat(tools): one-shot mapping launcher
    bash tools/start_mapping.sh starts Cartographer (or slam_toolbox with
    --slam) plus RViz and the map health monitor: checks the three serial
    devices, clears stale nodes, verifies /scan /map /wheel/odom, then prints
    the save/check commands. 'stop' tears everything down.
2026-10-30 feat(map): expanded 26.5 x 27.4 m Cartographer map
    - maps/real_map_2026-10-30_expand.*: standard ROS trinary map saved from
    the live /map (0 occupied / 254 free / 205 unknown), 530x534 at 5 cm
    - archive kept outside the repo: ~/.carto_maps/expand_1030.pbstream (5.9 MB,
    resumable) plus the raw pbstream-derived pgm for reference
    - verified with AMCL: scan-to-map alignment median 7.1 cm (50 % < 10 cm)
    after seeding; much tighter than the live Cartographer pose at the end of
    the long session (which read 25-86 cm and was unstable)
2026-10-30 fix(carto): tune for featureless rectangular rooms
    An empty room with four straight walls is the worst case for 2D SLAM with
    a 180 deg lidar: a rectangle has 90 deg symmetry, so the scan matches a
    rotated pose almost as well as the true one and the map slowly skews
    (observed by the operator while scanning the empty east room).
    - real_time_correlative_scan_matcher.angular_search_window 20 -> 35 deg
    so the matcher can recover from a larger angular error instead of
    locking onto a rotated pose
    - submaps.num_range_data 90 -> 120 (steadier wall estimation)
    - POSE_GRAPH.optimize_every_n_nodes 30 -> 20 (skew pulled back sooner)
2026-10-30 tools: re-threshold a Cartographer probability pgm into a trinary nav map
    cartographer_pbstream_to_ros_map keeps the full occupancy gradient
    (pixel = 255*(1-p_occ), 128 = unknown). tools/map_rethreshold.py converts
    it to 0/205/254 with configurable thresholds.
    Measured on the expanded map: treating >=50 % probability as wall doubles
    the wall count (3967 -> 8479) but costs 64 % of the navigable area
    (eroded usable space 103.1 -> 37.5 m2) because the extra cells are lidar
    ray artefacts and wall fuzz, not real walls. The map_saver output
    (occupied_thresh 0.65) remains the better navigation map; fix individual
    broken walls in the editor instead.
2026-10-30 docs: research on the rear lidar blind spot and open-source options
    Summarises Steve Macenski's guidance that graph-based 2D SLAM wants >=180
    deg of view (we are exactly at the lower bound), the tuning he suggests for
    low-FOV scanners, and five candidate fixes: raising the lidar, HP60C depth
    camera to virtual laser scan (depthimage_to_laserscan is already installed),
    a second rear lidar merged with ros2_laser_scan_merger / ira_laser_tools,
    a 360 deg lidar, and driving-strategy compensation.
2026-10-30 feat(tools): SLAM benchmark harness (record once, replay offline)
    Driving the same route for every SLAM variant is slow and unfair (traffic,
    poses differ). Instead:
    - tools/record_mapping_bag.sh records /scan_mapping /scan /odom /wheel/odom
    /tf /tf_static /imu/data_raw into ~/fwr_bags/<name>
    - tools/bench_slam.sh replays that bag with --clock into slam_toolbox (current
    params), slam_toolbox with the low-FOV params Macenski recommends
    (0.25/0.25, loop distance 5.0) or Cartographer, saves the map and scores it
    - tools/map_quality.py scores maps on walls, solidity, free/usable area,
    fragment count, dominant wall directions, circular within-cluster spread
    and orthogonal pairs
    Baseline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
2026-10-30 feat(mapping): wall-following mapping mode, 250 deg lidar FOV, mixed manual commands
    Three findings from the field today:
    1. The lidar only has ~90 deg physically blocked (rear +/-45 deg), not the
    180 deg we were masking. Raising /scan_mapping's rear mask from +/-90 to
    +/-55 deg takes the usable field of view from 180 to ~250 deg.
    2. The manual channel rejected any command with both linear and angular
    velocity ('one low-speed axis at a time'), which silently dropped every
    wall-follower command. manual_velocity() gains allow_mixed and base_bridge
    exposes manual_allow_mixed (default false, keyboard behaviour unchanged).
    3. The frontier-exploration autopilot spent its time piv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
2026-10-30 feat(wall-follower): arc turns, direction lock, fault recovery
    - arc turns: only pivot when the front is closer than pivot_m (0.38 m);
    between 0.38 and 1.10 m the robot keeps arc_min_speed_ratio (35 %) of its
    speed while steering, so corners are one continuous curve instead of
    stop-turn-go.
    - direction lock: once an avoidance direction is chosen it is held for
    turn_commit_s (1.5 s). Without it the gap term flipped sign whenever the
    two front sectors were within a few cm of each other, producing the
    left-right jitter seen in the field.
    - fault recovery: a stall fault (front pushed into a wall) now runs a
    five-stage sequence (close gates, clear_fault, reopen gates, reverse,
    res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
2026-10-30 feat(tools): resume mapping on an existing Cartographer pbstream
    tools/continue_mapping.sh starts the base stack, then cartographer_node with
    -load_state_filename so new scans extend the existing pose graph instead of
    starting from scratch, and optionally launches wall_follower for automatic
    expansion. Finish with tools/cartographer_save.sh to persist the merged
    pbstream + map.
    Map acceptance criteria used this session (measured with tools/map_quality.py
    and tools/map_align_check.py): scan/map alignment <5 cm, wall solidity >85 %,
    wall direction spread <8 deg, two orthogonal direction groups, >10 m2 of
    goal-placement area, and the 3 m odometry scale error <1 %.
2026-10-30 tune(wall-follower): doorway entry, side switching, wider sensors, slower
    Field notes from the large-area run:
    - the robot drove straight past a doorway on its wall side; it now turns
    into an opening when the followed side goes away (> target+1.2 m or no
    return), capped at 2.5 s so it cannot circle in open space
    - following only one side never enters openings on the other side, so the
    robot now switches the followed side every 8 m of travel
    - front sector +/-20 -> +/-35 deg and the diagonal sectors widened to 40:
    a wall approached at 30-60 deg off-axis used to be invisible until it was
    too late
    - cruise 0.12 -> 0.09 m/s
    Field result: 0 stall latches in 140 s (was 33), corridor cent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
2026-10-30 perf(wall-follower): 276 % -> 5 % CPU, reverse along own trail
    The /map subscription plus a tf2 listener made the node rebuild Python objects
    for a 90k-cell OccupancyGrid every second: top showed 276 % CPU and the lidar
    and Cartographer starved, which the operator saw as a laggy scan that no longer
    matched the map.
    The rear-clearance test now uses the odometry trail the robot just drove: if at
    least rear_check_m of trail is behind it, reversing along that path is safe by
    construction, no map or TF needed. Same escape behaviour, 5 % CPU.
2026-10-31 feat(wall-follower): doorway detection with centre transit; fix endless pivot
    - detect a doorway as a contiguous open arc (22-70 deg) bounded by returns
    closer than 2.2 m on both sides, then aim at the arc centre and drive
    through for door_commit_s with an 8 s cooldown so an open hall cannot
    trigger it repeatedly
    - fix the fault-recovery state machine: stage 4 checked 'st > 4.2 -> pivot'
    before 'st > 5.4 -> done', and the pivot branch returns, so recovery never
    completed and the robot pivoted forever after any stall (24 door hits and
    no forward progress in the field)
    - earlier in this run: avoidance start 1.45 -> 1.85 m, front cone +/-35 ->
    +/-45 deg, escape now prefers reversi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
2026-10-31 feat(rviz): start/stop-mapping buttons in the nav panel
    The wall-following mapper drives on its own, so the operator needs a single
    click emergency stop without a terminal. The panel now publishes a zero Twist
    on /cmd_vel_manual and flips motion_enabled/manual_enabled/manual_allow_mixed
    off through /base_bridge/set_parameters; the start button flips them back.
    real_mapping.rviz loads the panel so it is available while mapping.
2026-10-31 feat(route): record a hand-driven route and replay it
    The operator asked to drive the mapping run by hand and have the robot learn
    that route, including how it exits and enters rooms. Reactive wall following
    keeps failing exactly there.
    route_node has two modes:
    - record: every 0.30 m of odometry the pose is appended and published on
    /recorded_route; Ctrl+C writes ~/.fwr_routes/<name>.yaml
    - follow: pure-pursuit along the stored waypoints on /cmd_vel_manual, pausing
    when the front drops under 0.5 m and aborting if it stays blocked for 3 s
    tools/manual_mapping.sh starts Cartographer plus the recorder, tools/replay_route.sh
    replays a stored route.
2026-10-31 feat(mapping): switch to frontier_exploration_ros2, fix wall-crossing plans
    Replaced the hand-written wall follower with the open-source
    frontier_exploration_ros2 package (Humble, MRTSP ordering, non-360 deg lidar
    support, RViz panel). Lesson recorded: research existing packages first.
    Field failures fixed:
    - plans crossed walls because the global costmap treated unknown cells as free
    while the map has 5-15 cm gaps in walls (measured path endpoint 0.00 m from a
    wall). map_seal.py dilates obstacles into /map_sealed and the static layer
    now reads it: clearance is 0.35 m.
    - inflation 0.30 -> 0.40 with cost_scaling 3.0 (0.86 m doorways stay passable)
    - /mapping/save service stops the ro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
    [real_frontier_exploration.yaml]
2026-10-31 fix(nav): restore map-sized global costmap, add regression smoke test
    Root cause of the 'single point planning failed' regression: the previous change
    pointed the costmap static layer at /map_sealed, but map_seal only ran in
    mapping mode, so navigation had no static map and the global costmap collapsed
    to a 5x5 m rolling window - any goal further than that failed to plan.
    map_seal now runs in both modes.
    Also fixed while hunting it:
    - real_nav2.yaml had two identical local_costmap blocks (the second silently
    replaced the first); removed the duplicate
    - global costmap gains footprint_clearing_enabled so a robot standing in the
    inflation ring of a wall is not reported as a lethal start ce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
2026-10-31 fix(nav2): correct footprint-clearing namespace, restore path clearance
    - footprint_clearing_enabled belongs to the layer namespace in Humble
    (static_layer.footprint_clearing_enabled); the top-level key was ignored, so a
    robot parked in a wall's inflation ring still reported cost 99 at its own cell
    and planning failed. With the layer key set, the plan now starts from the
    robot normally.
    - cost_scaling_factor back to 2.0: 3.0 decayed so fast the planner considered
    hugging walls cheap.
    - smoke_test.py measures clearance only on the path interior (endpoints are
    fixed by the robot and goal) and treats 0.15-0.25 m as a warning (narrow doors
    legitimately need it) while <0.15 m is a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
2026-10-31 feat(explore): room-level explorer that finishes a room before leaving it
    Field feedback: global frontier exploration hops out of a room as soon as a
    larger frontier appears elsewhere, so room walls stay unclosed.
    room_explorer.py segments free space by eroding it door_closing_m (0.42 m),
    which splits the map at doorways into room-sized components. It then only
    dispatches frontiers that fall inside the robot's current room, and switches to
    outside frontiers once the room's own frontiers are exhausted - visible in the
    logs as '房间内前沿' followed later by '房间外前沿'.
    Also in this change:
    - front_stop polygon shrunk to [0.30..0.52] x +/-0.26; the old [0.20..0.62]
    x +/-0.31 tr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
2026-10-31 feat(ultrasonic): rear A22 x4 over RS485 as sensor_msgs/Range
    Node: fwr_bringup/ultrasonic_rear.py
    - minimal Modbus RTU client (stdlib termios), 9600 8N1, slave 0x01, reads
    0x0106 count=4 -> 01 03 08 D1 D2 D3 D4 CRC
    - publishes four sensor_msgs/Range: ultrasonic_rear_{left_out,left_in,right_in,
    right_out}; the anomaly codes 0xFFFF/0xFFFE/0xFFFD are treated as 'no reliable
    reading' and are simply not published (never 0, never free space)
    - opens by /dev/serial/by-id, closes and retries with backoff on any read/write
    error (this USB-RS485 adapter already dropped once in the field)
    - tracks per-sensor last-valid age and publishes /ultrasonic_rear/status
    Integration:
    - four static TFs b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
2026-10-31 feat(ultrasonic): three-point calibration and rear reverse guard
    Calibration with a box at 0.20/0.30/0.50 m from the rear edge:
    left_in / right_in are within 3 mm across the range
    left_out reads +26..30 mm (and +59 mm at 0.2 m, it is aimed 10 deg outwards)
    right_out never reports a false near reading, only the far background
    This also confirmed the interface mapping (1..4 = left_out/left_in/right_in/
    right_out): a box on the rear left made interfaces 1 and 2 the closest.
    - ultrasonic_rear gains offsets_m (default [0.028, 0, 0, 0])
    - rear_guard.py: median over 5 frames, 3 consecutive confirmations, hysteresis
    (block below 0.30 m, release above 0.45 m) -> /base/rear_blocked
    - base_bri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
2026-10-31 fix(base): initialise _rear_blocked before use
    Adding the /base/rear_blocked subscription without initialising the attribute
    crashed base_bridge on startup (AttributeError in the manual velocity path),
    which the nav smoke test caught. Initialise it next to the subscription.
    Verified: base_bridge stays up, guard reports blocked with the box behind,
    a 2 s reverse command still yields 0.000 m, and the nav smoke test passes.
2026-10-31 feat(nav): allow path reversing, gated by the rear ultrasonic guard
    The operator accepted option B: let the planner produce reversing segments, with
    the rear sensors as the hard interlock.
    - real_nav2.yaml: allow_reversing true
    - base_bridge_core.nav_reverse_ok(): forward always passes; reverse requires the
    guard enabled AND rear_blocked false
    - base_bridge navigating path: no longer rejects every negative linear velocity;
    it consults nav_reverse_ok (halt + warn when blocked) and clamps the reverse
    speed to max_reverse_mps (0.12 m/s)
    - tests: test_nav_reverse.py (3 cases); test_real_nav2_config now expects true
    Verified on hardware: arm_auto armed, rear_blocked false, -0.05 m/s for 1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
2026-10-31 feat(explore): short escape reverse when a frontier keeps failing
    Option A for stuck recovery. When the same frontier goal fails
    escape_after_failures times (2 by default) the explorer:
    1. switches the base to the manual channel (motion_enabled + manual_enabled)
    2. publishes -0.06 m/s on /cmd_vel_manual for at most 0.25 m or 2.5 s
    3. zeroes the command, returns to the auto channel and blacklists the goal
    The manual channel is used on purpose: nav-channel reversing needs the recovery
    permit plus /explore/state=reversing, and that topic is owned by the supervisor,
    so two nodes would fight over it. Manual reverse is already interlocked by the
    rear ultrasonic guard (verified: 0.000 m wi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
2026-10-31 fix(gate): release the manual latch; slow turns to cut scan smear
    Stuck-robot root cause: the room explorer's short escape opens manual_enabled,
    which latches AutoCommandGate._manual; the latch was only released by the
    stopped->selecting sequence the supervisor runs once at startup. After a single
    escape the gate therefore dropped every nav command for the rest of the session
    (/cmd_vel had output, /cmd_vel_auto_unchecked stayed zero, the robot never moved).
    The latch now also clears as soon as the manual channel is off and the mode is
    back to navigating; three unit tests cover it.
    Ghosting: rotate_to_heading_angular_vel was 0.8 rad/s, i.e. 4.6 deg per 0.1 s
    lidar sweep, which skews the clo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
2026-10-31 fix(watchdog): recover collision monitors from unconfigured
    'Silent chain, robot will not move, every goal fails' turned out to be both
    collision monitors sitting in unconfigured, where deactivate/activate both fail -
    the watchdog only knew those two transitions, so the chain stayed dead forever.
    It now reads get_state and runs configure->activate, activate, or
    deactivate->activate as appropriate, plus a 5 s health sweep.
    Also verified the adaptive escape on hardware: front clearance 0.32 m, reversed
    0.62 m, stopped at 0.88 m once the front was clear enough to turn.
    Known issue: left_in and right_in ultrasonics report stale (no response), wiring
    or power on those two probes needs a look.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
2026-10-31 fix(ultrasonic): tolerate transient CRC errors instead of reconnecting
    The two 'stale' channels were not faulty probes: raw Modbus reads returned
    2.0/2.0/1.7 m on all four. A single CRC error was dropping the serial link and
    reopening it, which lost about a second of data and made those channels look
    stale. Bad frames are now counted and only three consecutive ones trigger a
    reconnect (max_bad_frames); the restarted stack shows zero reconnects.
    Ghosting after slowing turns to 0.45 rad/s: max wall thickness 0.30 m -> 0.22 m
    (-27 %) with narrow double-wall gaps 2.73 -> 2.63 m2.
2026-10-31 fix(explore): escape when goals keep getting skipped
    Goal validation was skipping unreachable frontiers without triggering any escape,
    so a boxed robot sat there forever while the explorer kept discarding goals.
    Three consecutive non-traversable goals now start the short reverse escape.
    Also records the session conclusion: the remaining lack of progress is not a
    single bug but a mobility limit - the site is narrow (front/left/right often
    under 0.4 m) while the chassis needs about a 1 m turning radius, and the
    collision stop polygon is already squeezed to its practical minimum.
2026-10-31 docs: the robot not moving is encoder fault 4, not path planning
    Evidence chain: the command reaches /cmd_vel_auto_forward_filtered intact (front
    3.42 m clear, monitor active) but /cmd_vel_auto_safe stays zero because the
    safety selector sees odom->base TF lagging 0.45-2.0 s (limit 0.25 s), which in
    turn comes from the base reporting /base/fault = 4 = BASE_ENCODER and disarming.
    Clearing the fault in a base-only stack restored motion (manual 1.2 s gave
    0.026 m), and restarting auto-mapping tripped fault 4 again immediately.
    Firmware trips BASE_ENCODER after more than 8 encoder skips while active, so the
    chassis locks up as soon as it drives. This is a wiring/magnet/EMI problem on
    the encod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
2026-10-31 fix(scan): the lidar mask was stuck at +-90 deg; use +-50 deg (260 deg FOV)
    The operator noticed the scan looked like 180 degrees and was right: the running
    node reported rear_half_angle_rad = 1.5708, because both mapping launch files
    hard-code that value, which overrides the code default. The change I made this
    morning (radians(55)) never took effect.
    Now math.radians(50), verified by measuring the mask boundary in the live scan:
    everything inside |angle| <= 50 deg is masked, beyond that only natural NaNs
    (8-11 %). Effective field of view is 260 deg instead of 180 deg, which explains
    the thin walls, the ghosting and the repeated 'side walls not scanned' problem.
    AGENTS.md corrected and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
2026-10-31 docs(AGENTS): the lidar mask must be changed in the launch file
    Records that real_mapping.launch.py overrides rear_half_angle_rad, that the
    value is now +-50 deg (260 deg field of view), and that editing the node default
    has no effect - the reason the robot ran with 180 deg for so long.
2026-10-31 feat(sim): four-room Gazebo Fortress world feeding the real mapping stack
    Adds a simulation that reuses the production code path end to end so algorithm
    changes can be validated before touching the robot.
    - sim/worlds/four_rooms.sdf: 2x2 rooms (14x14 m) with furniture and 0.9 m doorways
    - sim/models/fwr_bot/model.sdf: 0.60x0.43 differential drive, a 360 deg gpu_lidar
    mounted upside down (scan angle 0 = rear, matching the real robot), four narrow
    rear lidars standing in for the A22 ultrasonics, and an IMU
    - sim/config/bridge.yaml: 11 ros_gz_bridge mappings
    - sim/config/sim_2d.lua: same Cartographer config, only tracking_frame=base_link
    - sim/launch/sim_bringup.launch.py: gazebo + robot +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
    [four_rooms.sdf]
2026-11-01 fix(sim): make the four-room simulation actually map and navigate
    Five real bugs found while bringing the sim up, all with field impact:
    1. The sim robot now comes from the production URDF (meshes, track 0.315,
    wheel radius 0.0325) instead of a hand-written SDF, so Gazebo shows the same
    robot RViz does.
    2. The simulated ultrasonics sat inside the chassis and read 0.12-0.19 m of
    self-echo, which latched rear_blocked and made the range layer mark the
    robot's own cell lethal ('Starting point in lethal space'). They now sit at
    x=-0.33, outside the body.
    3. map_seal's one-cell dilation turned the cell under a robot that drives 5 cm
    from a wall into an obstacle. It gained a fi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
2026-11-01 docs(sim): first successful exploration run and what did not work
    With the real URDF model, a natively 260 deg lidar, Cartographer reading /scan,
    IMU enabled, and map_seal's fixed canvas plus no dilation:
    14 minutes, map 16x14 m (world is 14x14), 62 m2 free, all four rooms entered
    (7/7/14/34 m2 per quadrant), 25 in-room goals, 15 outside, 7 escapes,
    and zero patience-exceeded, zero lethal-space and zero planner crashes.
    So autonomy works in the sim; map quality does not yet (interior walls
    incomplete, one wedge-shaped artefact).
    Recorded negative results so they are not retried: masked scans break
    Cartographer (NaN and inf both), disabling use_imu_data degrades the map to
    391x297 m,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
2026-11-01 docs: analysis of why auto-mapping regressed after the ultrasonic work
    Traces the two field symptoms to four concrete changes rather than the sensors
    themselves:
    1. collision_monitor_reverse has a rear stop polygon, and Nav2's stop action
    zeroes the whole Twist, rotation included. The safety selector demands a
    non-zero angular reply from BOTH monitors for a pure rotation, so any rear
    obstacle within 0.3-0.45 m vetoes every turn - 'a turn was planned but the
    robot stands still'. Same limitation is discussed upstream in navigation2
    issue 3313.
    2. The local costmap range_layer runs with clear_on_max_reading=false, while the
    ultrasonic publishes max_range for 'no target', so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
2026-11-01 docs(sim): add a README and move the model generator into the repo
    The simulation is reproducible from the repo now: sim/tools/make_model.py builds
    the Gazebo URDF from the production chassis description, the README documents the
    two launch entry points, the mapping between sim and robot components, and the
    two pitfalls (software GL needed for GPU sensors, and the ruby-based gazebo
    process naming that makes cleanup tricky).
2026-11-01 docs: simulation handover for the next session
    Collects everything needed to continue in simulation: environment quirks (software
    GL, gpu_lidar, imu-system plugin, ruby-named gazebo processes), the exact launch
    commands and the process-cleanup trap, what already works (sensors, Cartographer,
    RViz, Nav2 lifecycle), and the remaining blocker - Nav2 planning fails with
    'Robot is out of bounds of the costmap', so the explorer keeps failing goals and
    the robot does not move.
    Also restates the real-robot regression analysis: the rear stop polygon of
    collision_monitor_reverse vetoes rotation, range_layer with
    clear_on_max_reading=false grows a phantom wall behind the robot, and /map_sealed
    being r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
2026-11-01 fix(nav): unblock rotation, stabilise the map, pin the costmap size
    Acts on the handover list.
    C1 (regression fix): the selector demanded non-zero angular replies from BOTH
    monitors before allowing a pivot, but the reverse monitor's rear stop zone fires
    whenever a wall is 0.3-0.45 m behind, so every rotation was vetoed - the robot
    planned turns and then sat still. Rotation now only needs the forward reply
    (require_reverse_monitor defaults to false), the reverse monitor is no longer
    launched, and reversing stays guarded by base_bridge's rear ultrasonic interlock,
    which blocks reverse without blocking rotation.
    C2: range_layer clear_on_max_reading is true, so a max-range ultrasonic reading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
2026-11-01 fix(sim): lidar was blind ahead, and casters spun forever
    Two simulation defects the operator spotted:
    The lidar is mounted upside down (its own +x points to the robot's rear), but the
    scan range was written as +-130 deg around that axis, which covered the rear and
    left a 100 deg blind wedge straight ahead - the sim robot had been driving half
    blind. The range is now 50..310 deg so the blind zone sits at the rear like the
    real robot. Verified: 720 points over 260 deg, 138 echoes within +-25 deg of the
    front (nearest 0.56 m) and zero at the rear.
    The two front casters are continuous joints with no friction in Gazebo, so the
    swivel spun continuously. make_model.py now sets damping 8.0/fri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
2026-11-01 fix(sim): lidar scan zero is the front, per the operator
    The operator confirms the C1 is mounted with the cable aft and the arrow forward,
    so scan angle 0 is the robot's forward direction. I had relied on a comment in
    the production URDF ('Physical C1 scan zero faces chassis rear') and rotated the
    sim lidar 180 degrees, which made it cover the rear instead of the front.
    The sim model now drops that 180 degree joint offset and the matching static TF.
    Verified: 138 echoes within +-25 deg of scan angle 0 (nearest 0.56 m), zero at
    180 deg, and symmetric 1.30 m returns at +-90 deg.
    This raises an unverified question for the robot: scan_mapping_filter masks
    |angle| <= 50 deg, which under this c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
2026-11-01 fix(sim): headless gazebo, clean /scan, caster damping
    Four environment fixes verified this round:
    - The Gazebo GUI hangs under software rendering (the server never answers, so
    ros_gz_sim create times out on 'Requesting list of world names'). The launch
    now defaults to headless with --headless-rendering; gui:=true opens the 3D view.
    - A real sllidar_node left running from an earlier orientation measurement was
    publishing real-time /scan alongside the sim's sim-time /scan. Half the
    timestamps went backwards, Cartographer discarded the scans ('Ignored
    subdivision because the scan time decreased') and produced no map. Killing it
    gives zero time reversals.
    - Caster joints got dam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
2026-11-01 feat(sim): corridor world, bootstrap drive, and the free-space finding
    World rebuilt to the requested layout: a 2 m wide central corridor running along
    Y with two rooms on each side (four in total), 1.0 m doors onto the corridor and
    5 m tall walls. Generated by sim/tools/make_world.py so the geometry stays
    consistent.
    The sim also needs the kick that auto_mapping_supervisor performs on the robot:
    without it the map starts with only a few square metres of free space, which is
    below room_explorer's threshold, so the explorer never sends a goal - a deadlock
    where mapping needs motion and motion needs mapping. sim_bootstrap_drive waits
    25 s, drives 1.2 m and hands over. It has to publish on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
    [four_rooms.sdf]
2026-11-01 fix(nav): watchdog no longer manages the removed reverse monitor; shallower stop zone
    Two fixes from watching the robot spin in place:
    - chain_watchdog still listed collision_monitor_reverse, so it kept trying to
    deactivate a node that no longer exists. MONITORS now only has the forward
    monitor.
    - The forward stop polygon was 0.32-0.45 m deep, which vetoed pivoting whenever
    an obstacle sat 0.34-0.39 m ahead - exactly the 'should turn left here but
    cannot' situation. It is now 0.28-0.33 m (the body front edge is at 0.30 m)
    and front_slow still slows from 0.33 out to 0.75 m. With this the supervisor's
    kickstart completes and hands over to the explorer.
    New blocker: the map is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
2026-11-01 fix(carto): write free space - miss_probability 0.49 was too close to threshold
    Controlled experiment with the operator driving manually: before the change a
    0.15 m move grew the free area from 9.0 to only 9.7 m2 while the unknown area
    grew by 47 m2 - the map expanded but nothing became free. After driving one room
    with explicit range_data_inserter settings the free area reached 47.6 m2.
    fwr_2d.lua never configured the inserter, so Cartographer used the default
    miss_probability of 0.49, which barely crosses the 0.5 free threshold; rays marked
    walls but never carved the space they passed through. That single detail explains
    the thin walls, the ghosting, the empty-looking corridor, the expl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
2026-11-01 fix(nav): turn in place when forward is blocked, and stop the zig-zag
    Four behaviour fixes validated on the robot:
    - When the forward stop zone blocks a 'drive forward and turn' command, the
    selector now outputs a pure rotation instead of a zero command, preferring the
    requested side and falling back to the opposite one. This is what the operator
    kept asking for ('just turn right there').
    - Rotation pass-through uses a +-20 deg front sector and a 0.34 m threshold, so a
    wall beside the robot no longer vetoes turning in place.
    - Anti-oscillation: angular_dist_threshold 1.2 -> 0.35 rad (rotate to heading
    first), lookahead 0.45 -> 0.60 with a 0.40 floor. Angular velocity samples now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
2026-11-01 fix(nav): compare rotation clearance against the rotation centre, not the lidar
    The lidar sits 0.21 m ahead of the body centre, so the radius a pivot sweeps
    (0.37 m) is only 0.16 m away when measured from the lidar. The threshold was
    0.34 m, effectively demanding 0.55 m of real clearance, which is why the robot
    refused to turn in places where there was obviously room.
    Still to verify: with 0.16 the selector still returns zero at the current spot, so
    the passthrough flags or their update path need one more look (log last_reason).
2026-11-01 fix(nav): two logic errors that made every rotation look unsafe
    1. Rotation clearance ignored the lidar's 0.21 m forward offset. A pivot sweeps
    0.37 m from the body centre, so a lidar reading above 0.16 m is already safe;
    the threshold was 0.34 m, effectively demanding 0.55 m of real room, which is
    why the robot refused to turn where there was obviously space.
    2. 'Forward blocked' was tested against that same rotation threshold instead of
    the 0.45 m forward stop zone, so at 0.27 m the robot counted as neither free
    (no rotation) nor blocked (no turn-in-place) and just output zero. A dedicated
    forward_block_m parameter now drives that decision.
    Measured over three minutes: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
2026-11-01 feat(mapping): slam_toolbox becomes the default engine; pause now stops the robot
    Field comparison settled it: Cartographer still failed to close loops in this
    corridor layout even after relaxing min_score, constraint distance and the
    correlative search windows, while slam_toolbox produced continuous, closed
    walls. real_auto_mapping now defaults slam_engine:=slam (carto still selectable).
    The pause button did nothing: /explore/pause was published by the supervisor but
    no node subscribed. The directional safety selector now subscribes and outputs
    zero while paused, so pause actually stops the autonomous path.
    Also records every tuned parameter from today in AGENT_LOG for reuse.
2026-11-01 fix(nav): seal the map properly so plans stop cutting through walls
    The manual slam map has scattered noise dots - 14 percent of wall cells are
    isolated fragments and the walls were split into 146 connected components, so the
    planner happily squeezed through the gaps between fragments.
    map_seal now removes obstacle components smaller than min_cluster_cells (4 cells,
    i.e. noise dots) before dilating, and the navigation launch dilates 2 cells
    instead of 1. Measured on the current map: connected wall components drop from
    146 to 75 and the sealed grid grows from 3.6k to 11.3k obstacle cells.
2026-11-01 fix(nav): dilate the sealed map by 3 cells
    Two cells still left gaps wide enough for the planner to thread through on the
    manual map. With three cells (15 cm) three different start/goal pairs - including
    one from the left wing to the right room - all plan with zero points inside lethal
    cells.
2026-11-01 fix(map_seal): publish at 2 Hz again
    At 0.5 Hz the global costmap can be empty for up to two seconds after startup,
    which makes the first preview or plan a straight line that appears to cut through
    walls - and RViz keeps drawing that stale path afterwards. Verified the robot's
    own cell costs 0 and the wall cells cost 100 once the seal is published, so the
    sealing itself is correct.
2026-11-01 fix(nav): footprint_clearing on the global costmap - this was the wall crossing
    Captured the panel's actual preview path: 108 points from (0.3,0.2) to (0.3,-4.7)
    with nine cells at cost 99, all clustered at x=-0.4, y=-0.3..-0.5 - right beside
    the robot itself, not at a distant wall. The planner was routing out of the
    obstacle it was standing next to.
    footprint_clearing_enabled was only set on the static layer, never on the global
    costmap itself, so the robot's own footprint was never cleared. With the
    costmap-level flag the 5x5 neighbourhood around the robot drops from cost 82 to 0
    and the path to the operator's goal is 87 points with zero lethal cells.
2026-11-01 fix(map_seal): the fixed canvas was shifting the map - this is why plans crossed walls
    Checked the sealed map against the source: zero of 201 wall points lined up at any
    offset within +-6 cells, i.e. the fixed-canvas copy was not placing the map
    correctly at all. The global costmap therefore held the walls in the wrong
    places, so the planner legitimately drove through what RViz drew as walls.
    With the fixed canvas disabled (plain passthrough) the two grids match exactly:
    367x458 at (-2.4,-14.9) for both, 151 of 151 sampled wall points aligned.
2026-11-01 feat(map_edit): one-click load of the map currently in use, plus lessons learned
    Adds a '选择当前地图（直接编辑）' button to the Map Edit panel. It reads
    yaml_filename from /map_server and reuses the existing loadAndPublishMap() path,
    so the original '选择本地地图文件' flow is untouched.
    AGENTS.md gains a section listing the mistakes from today's wall-crossing hunt:
    check the data source before the algorithm (map -> map_sealed -> costmap, point by
    point), verify every coordinate-shift routine against real feature points, treat
    RViz lines as possibly stale, A/B any costmap parameter change, and reuse proven
    functions instead of writing parallel implementations when addin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
2026-11-01 feat(map_edit): track the Map Edit panel and its new load-current-map button
    ros2_ws/src/map_edit/ was in .gitignore, so the panel - including the button added
    today - was never versioned and would vanish on a fresh checkout. Force-add the
    package.
    The button reads yaml_filename from /map_server and reuses loadAndPublishMap(), so
    the original file-dialog flow is untouched. It also no longer asks 'save first':
    is_saved only turns true after this panel performs a save, so a freshly opened RViz
    used to report unsaved even for a good map on disk.
2026-11-01 chore: bump map_edit submodule (load-current-map button + wrap)
2026-11-01 chore(rviz): start the navigation view nearly full screen (1910x1190)
    The window had no Window Geometry section so RViz used its default size, and the
    GNOME title bar offered no maximize button for it. Pinning the geometry to the
    1920x1200 panel makes it open essentially full screen.
2026-11-01 feat(tools): edit_map.sh - edit the map without map_server overwriting it
    Stopping the stack also closes RViz, and once map_server is gone the new
    'choose current map' button cannot read its yaml_filename. This script stops the
    stack, brings RViz up on its own, and prints the exact steps: pick the file with
    the original button, select the eraser tool, edit, save, then relaunch navigation.
2026-11-01 tune(nav): inflation 0.30 -> 0.45 so plans stop hugging door corners
    Inflation only shapes the cost gradient, it never blocks a cell, so raising it is
    safe for doorways while giving the planner room to stand off from walls.
    Measured on the current map, path to (11.05,0.05): 278 points, average clearance
    0.79 m; the single 0.07 m sample is the doorway pinch itself.
2026-11-01 docs: why the pivot-escape cannot be solved by shrinking the stop zone
    Field case: 0.24 m ahead, 0.33 m left and right - a right pivot would clear it.
    Shrinking front_stop to 0.22 lets the pivot through but the guardrail test rejects
    anything shallower than the 0.30 m chassis edge, and that test exists because 0.28
    actually caused a wall collision.
    The monitor sits before the safety selector, so once it zeroes the command the
    selector cannot revive it. Pivot escape has to be injected after the monitor;
    logged the design for the next session.
2026-11-01 feat(nav): adaptive pivot escape when the collision monitor freezes the robot
    Field case: 0.24 m ahead, 0.33 m either side, Nav2 asking to move but the forward
    monitor zeroing every command - the robot sits still. The monitor runs before the
    selector so it cannot be overruled there; the selector now escapes on its own.
    Rules: only when Nav2 actually wants to move, the front is inside the forward block
    distance, and one side has at least rotate_clear_m of room. It pivots at
    escape_turn_rate toward the wider side and re-checks the front every tick - it stops
    the instant the front is clear, so the angle is whatever was needed (10 degrees is
    fine, no minimum). If neither side has room it sta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
2026-11-02 feat(watchdog): restart the lidar when /scan goes silent
    Field failure: a ~20 s scan dropout left the local costmap with no obstacle data,
    controller_server aborted follow_path repeatedly and Nav2 reported Goal failed -
    the robot simply stopped with a healthy motion gate.
    chain_watchdog now subscribes /scan, and if it sees no message for scan_stale_s
    (2 s) it restarts sllidar_node on its by-id serial path, with a 10 s cooldown so a
    persistently dead lidar is not thrashed. Decision logic verified in isolation.
2026-11-02 feat(nav): run the chain watchdog inside the navigation stack too
    It now guards /scan as well as the collision monitor, and navigation is exactly
    where a lidar dropout kills the run. Previously the watchdog only came up with the
    auto-mapping launch.
2026-11-02 fix(watchdog): warn on scan loss by default, and restart with the full lidar args
    Auto-restart made things worse in practice: the restart command only passed
    serial_port, so the node died on the wrong baudrate, the watchdog saw the silence
    again and killed it in a loop - ending with no lidar at all. restart_scan now
    defaults to false (alert only) and, when explicitly enabled, passes baudrate,
    frame_id, scan_mode and angle_compensate exactly as real_mapping.launch.py does.
2026-11-02 tune(nav): 0.15 m/s on straights with curvature-based slowdown
    desired_linear_vel back to the previously proven 0.15, and RPP's regulated
    velocity scaling is on so the speed drops with path curvature (min radius 0.9 m,
    floor 0.06). Smoother now ramps 0.8 / -0.9 so the change of speed is continuous
    rather than stepped.
2026-11-02 fix(panel): resuming an interrupted two-point task keeps both legs
    Resume always used the single-goal client with the final goal, so stopping on the
    way to the start point and pressing resume sent the robot straight to the end.
    handle_real_goal_response now records whether the interrupted task was two-point,
    and send_real_navigation_request re-issues the two-point service in that case -
    explorer plans from the current pose to the start point and then the goal.
2026-11-02 fix(safety): front stop depth 0.45 -> 0.38 keeps doorway crossings from tripping it
    Log showed 'Robot to stop due to front_stop polygon' at the doorway: approaching at
    an angle put the door frame inside the 0.45 m deep zone, Nav2 then aborted the goal.
    0.38 keeps 8 cm beyond the 0.30 m chassis edge and still satisfies the guardrail
    (start >= 0.30, span <= 0.20).
2026-11-02 fix(launch): keep the chain watchdog out of the navigation stack
    It reads collision_monitor_forward as 'unknown', forces a deactivate->activate
    cycle, both transitions fail and the monitor is left unusable - /cmd_vel_auto_safe
    sticks at zero and the robot will not move at all. That is worse than the stall it
    was meant to cure, so it no longer comes up with navigation; run
    tools/chain_watchdog.py by hand when needed.
2026-11-02 fix(nav): map_server was republishing /map at ~30 Hz and wrecking AMCL
    Measured 178 map messages in six seconds with only map_server as publisher. Every
    one of them made AMCL re-initialise its particles, so the pose never settled and
    controller_server aborted follow_path over and over - the robot simply would not
    move even though the plan and the costmap were fine.
    Setting map_publish_period explicitly to 0.0 brings it back to a single latched
    publication (1 message in six seconds).
2026-11-02 fix(launch): start auto_explore_state, without it the selector blocks every command
    directional_safety_core requires /explore/state == 'navigating' before it lets any
    velocity through (line 134). The node that publishes that state existed but was
    never launched by anything, so the state sat at 'stopped': Nav2 produced a healthy
    0.07/-0.17 m/s on /cmd_vel and the selector turned it into 0.0/0.0 every cycle.
2026-11-02 revert(nav): stop launching auto_explore_state unconditionally
    It published /explore/state=navigating every second, fighting the explorer's own
    state machine: the goal was cancelled 0.1 s after being sent, so navigation 'ended
    as soon as it started'. Also a safety regression - the chain stayed open with no
    task. State is again owned solely by frontier_explorer, which reports 'stopped'
    while idle.
2026-11-02 tune(nav): inflation_radius 0.35 -> 0.45, min clearance 0.05 -> 0.10 m
    Measured on both goals: minimum distance to a lethal cell doubled from 0.05 m to
    0.10 m and the average stayed 0.43-0.44 m, while both goals still plan - so the
    wider gradient pushes paths off the door frames without closing the doorways.
2026-11-02 tune(nav): rotate-to-heading angular velocity 0.45 -> 0.6 rad/s
    Aligning with the path took 3.5 s for a 90 degree turn, which the operator noticed as
    slow heading correction. 0.6 brings that to about 2.6 s; overshoot is still bounded
    by max_angular_accel 4.0.
2026-11-02 revert(nav): disable regulated linear velocity scaling
    Enabled earlier today for curvature slowdown; since then controller_server aborts
    follow_path every cycle with /cmd_vel empty while the plan, the TF tree and the
    costmap are all healthy. Reverting the newest change first to see whether it is the
    one that broke execution.
2026-11-02 chore(diag): log the fixed-goal state machine each tick
    Temporary instrumentation for the two-point task that never advances from leg 1 to
    leg 2: prints goal status, dispatched counter, leg count, enabled flag and index so
    one reproduction reveals whether Nav2 reports success.
2026-11-02 tune(nav): inflation_radius 0.45 -> 0.35
    0.45 was sized for the circumscribed radius, which wastes clearance sideways: the
    chassis only needs 0.215 m to either side. 0.35 still gives a margin while letting
    the robot plan through gaps it physically fits; true collision safety comes from the
    rectangular footprint check, not from the circular inflation.
2026-11-02 chore(diag): only log the fixed-goal state when it changes
    The per-tick print flooded the launch log and hid controller and planner messages
    during the doorway failure.
2026-11-02 feat(nav): escape in 0.3 s, survive more retries, accept a looser auto seed
    Three linked fixes for the doorway deadlock and the lost auto-localisation:
    - escape_after_s 1.5 -> 0.3: Nav2 exhausts its retries 0.6 s after front_stop
    trips, so a 1.5 s escape could never win the race. The escape still requires a
    blocked front, a clear side and an active task, so 0.3 s of standstill is a strong
    signal rather than a hair trigger.
    - BT number_of_retries 2 -> 6: keeps the task alive long enough for the escape to
    take over instead of failing almost immediately.
    - auto_initial_pose max_score_m 0.10 -> 0.15: the current map matches at 0.127 m and
    was being rejected, so the operator had to pl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
2026-11-02 tune(safety): narrow the slow-down zone so walking beside walls and turning through doors stops triggering it
    front_slow fired seven times in one run and none of them was a real head-on
    approach: the zone was +-0.30 m wide against a +-0.215 m chassis, so side walls and
    door frames swept through it, and max_points 1 meant a single return was enough.
    Now +-0.22 wide, three points required, ratio 0.8.
2026-11-02 fix(explorer): do not kill the task on a 0.5 m pose correction
    AMCL legitimately corrects its pose by more than half a metre when the laser disagrees
    with where the wheels think the robot is. The explorer treated that as a lost fix and
    cancelled the goal, which is why runs ended 'canceled' with the safety chain untouched.
    Raised to 1.0 m and the event is now logged instead of being silent.
2026-11-02 tune(nav): footprint_padding 0.02 -> 0.06 to keep plans off door frames
    RPP cuts the inside of corners and use_collision_detection is off, so nothing stops
    the planner from routing within a few centimetres of a door frame. Padding the
    footprint makes the planner treat the robot as 6 cm wider, so it leaves more room at
    the corners. Doorways are 1 m wide and the padded footprint is 0.55 m, so they stay
    plannable.
2026-11-02 fix(nav): use Nav2's stock behaviour tree instead of the custom one
    The custom tree replans every second inside a PipelineSequence, so FollowPath is
    preempted once a second. In practice that occasionally desynchronises the tree from
    the controller's action server: the goal reports active, /cmd_vel carries not a single
    message and the robot sits still until the stack is restarted.
    Switching to the stock navigate_to_pose_w_replanning_and_recovery tree removes our
    custom tree as a variable; it also brings BackUp into the recovery rotation, which is
    what a doorway stall actually needs.
2026-11-02 fix(panel): give the task 6 s to reach RUNNING before closing the gate
    With Nav2's stock behaviour tree the action starts by clearing costmaps, so 2.5 s was
    not enough and the panel cancelled with 'task did not enter running state', closing the
    motion gate - the operator saw the start button do nothing.
2026-11-02 fix(nav): point the BT at Nav2's stock xml by path; an empty string is an empty tree
    Setting default_nav_to_pose_bt_xml to '' does not mean 'use the default' - bt_navigator
    loads an empty tree and every goal fails within milliseconds with
    'Behavior tree threw exception: Empty Tree'. Use the absolute path of
    navigate_to_pose_w_replanning_and_recovery.xml instead.
2026-11-02 fix(nav): use the stock BT structure without BackUp
    Two separate faults: an empty default_nav_to_pose_bt_xml is an empty tree (every goal
    failed in milliseconds), and the stock XML requires a /backup action that this robot
    does not configure, so bt_navigator could not even load it. The tree is now a copy of
    the stock one with BackUp replaced by Wait.
2026-11-02 fix(nav): BT loop 100 Hz -> 20 Hz
    The log kept warning 'Behavior Tree tick rate 100.00 was exceeded', and after that the
    goal stays active while /cmd_vel carries nothing - the robot sits still in open space
    (the laser shows 1.3 m ahead and 1.0 m either side). bt_loop_duration 10 ms is more
    than navigation needs; 50 ms (20 Hz) leaves the BT thread enough headroom.
2026-11-02 fix(nav): xy_goal_tolerance 0.2 -> 0.4 to cover the planner's goal snapping
    When a requested goal falls inside the inflation zone SmacPlanner2D snaps the path end
    to the nearest free cell; measured offset 0.34 m against a 0.20 m tolerance, so the goal
    checker never reported arrival. The robot reached the snapped endpoint, then sat there
    with the task still 'active' and no velocity commands.
2026-11-02 fix(nav): rotate to the path heading before driving
    Leg 2 stalled with /cmd_vel_nav at 0 Hz while the whole chain behind it ran at 24 Hz:
    the robot had turned away from the path, so the pure-pursuit carrot sat behind it and
    computeVelocityCommands produced nothing, aborting once a second. With
    use_rotate_to_heading the controller turns in place to the path heading first.
2026-11-02 revert(nav): keep use_rotate_to_heading off - it fights the rotation shim
    The guard test documents that enabling it forms a limit cycle with RotationShim, which
    owns heading alignment here. Back to false; the leg-2 stall must have another cause.
2026-11-02 revert(nav): back to our own BT structure - the stock one wraps FollowPath in a costmap-clearing RecoveryNode
    The operator noticed the leg-2 stall only appeared after the switch to the stock tree.
    The stock tree puts FollowPath inside RecoveryNode(number_of_retries=1) whose recovery is
    ClearEntireCostmap(local), so a single controller hiccup wipes the local obstacles and
    retries - a behaviour our previous tree never had. Restored the previous tree (Spin then
    Wait, retries 6) and kept today's bt_loop_duration fix.
2026-11-02 fix(nav): INPUT_ULTRASOUND is not a valid range-layer sensor type
    Nav2 logs 'range_layer: Invalid input sensor type: INPUT_ULTRASOUND' and silently
    falls back to INPUT_ALL, which makes the rear ultrasonic layer consume range messages
    it was never meant to. INPUT_SONAR is the correct value for the A22 ultrasonics.
2026-11-02 revert(nav): drop the sensor-type line and restore footprint_padding
    The range layer already ran on its default before I touched it, and two of my
    'sensor type' values were rejected as invalid - removing the line is both correct and
    quiet. footprint_padding goes back to 0.02, the value in use when navigation last
    completed end to end.
2026-11-02 fix(costmap): drop the rear range layer that was stalling the local costmap
    It logged 'No range readings received for 2.6 s' every few seconds even though the
    four ultrasonic topics publish at 3.6-6 Hz, and a starved range layer blocks the
    costmap update - so the controller had no fresh costmap, computeVelocityCommands
    failed and follow_path aborted once a second. Reverse safety is already covered by
    rear_guard publishing /base/rear_blocked, so the layer is redundant.
2026-11-02 docs: the range layer stalling the local costmap was the leg-2 root cause
    Explains why short goals always arrived and long ones always stalled: a starved
    range layer delays the costmap update, the controller then cannot compute a fresh
    control cycle and aborts. Recorded the symptom chain and the fix, and added the check
    to the recommended diagnosis order.
2026-11-02 tune(nav): constant lookahead - velocity-scaled lookahead oscillates
    With use_velocity_scaled_lookahead_dist the carrot distance follows the measured speed,
    which feeds back into the next command: /cmd_vel was alternating 0.12 / 0.07 m/s and the
    motion felt stuttery. A fixed lookahead decouples the two.
2026-11-02 tune(safety): front stop needs 6 points, so a door frame at a glancing angle no longer halts the robot
    At the second doorway the robot drifted toward the frame and front_stop tripped six
    times, failing the goal. A frame seen obliquely returns only a few points while a wall
    straight ahead returns many, so raising max_points from 3 to 6 keeps the real protection
    and ignores the frame.
2026-11-02 feat(safety): the pivot escape also triggers when either side gets too close
    Field case: the left door frame entered the monitor's stop rectangle while the
    selector's own forward measurement still read 0.45 m or more, so the escape never
    fired and Nav2's Spin was blocked ('Collision Ahead - Exiting Spin'), failing the goal.
    The escape now also engages when min(left, right) < near_side_m (0.45) and turns away
    from the near side, exactly as the operator described. Still gated on an active task,
    2 s of genuine standstill and the far side having rotate_clear_m of room; the exit
    condition now needs both the front and the sides to be clear.
2026-11-02 revert(nav): restore the tuning that completed navigation end to end
    Back to inflation 0.48, cost_scaling 1.2, angular_dist_threshold 0.35,
    velocity-scaled lookahead on and front_stop max_points 3 - the combination in use when
    the two-point task last finished. The later 'smoothness' experiments made behaviour
    worse (constant rotation after start), so they are rolled back.
2026-11-02 feat(nav): optional node that widens inflation on U-turn segments
    Turning radius comes from the path, not the controller, so the only way to make a
    U-turn swing wider is to make hugging its inner corner more expensive while that
    segment is being planned.
    turn_radius_boost watches /plan, compares the path tangent at the start with the one
    3 m ahead, and once the angle stays above turn_deg for hold_cycles it raises
    inflation_layer.inflation_radius via set_parameters, restoring it afterwards.
    Measured on synthetic paths: straight 0 deg, a 4 m radius curve 43 deg, a U-turn
    90 deg, so the default threshold is 70 deg. Ships disabled (enabled: false) and is not
    launched yet, so the current worki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
2026-11-02 feat(rviz): a '掉头判定' marker display so the verdict is visible during navigation
2026-11-02 fix(viz): a 2 m window with the first metre skipped marks real U-turns only
    At 0.6 m the marker caught the jitter at the path start (a false 90 degree segment right
    next to the robot) while missing the real 1 m radius loop, which only turns about 35
    degrees over that distance. A 2 m window plus skipping the first metre detects the
    semicircle and reports nothing for straights and 4 m radius curves.
2026-11-02 fix(safety): ignore angular sign flips below 0.05 rad/s
    Measured cause of the stutter: the collision monitor echoes at 10 Hz while the selector
    runs at 20 Hz, so during a turn the echoed angular sign lags the command. The core
    rejected the whole frame on any sign mismatch, which also threw away a perfectly good
    linear velocity - 15 sign-angular and 11 no-reply rejections in three minutes, cutting
    the command in 14 percent of frames while the controller's own output was smooth
    (0.0013 m/s jitter).
    A mismatch now only rejects when either value exceeds 0.05 rad/s (3 deg/s), which is
    below any meaningful steering input for this differential base.
2026-11-02 fix(nav): replan at 0.5 Hz because a far goal takes 1040 ms to plan
    Measured with the planner action: the right room takes 1040 ms, the centre 2 ms. The
    RateController was running at 1 Hz, so the tree cancelled each plan just as it finished;
    FollowPath then received no path and the goal failed about three seconds after start -
    the 'press start and it ends immediately' report.
2026-11-02 fix(safety): stop wiping the monitor reply cache whenever the direction changes
    The controller alternates between drive and pivot constantly (rotation shim), and each
    switch cleared filtered{} - so the next few frames had no forward reply and were rejected
    outright, dropping the linear velocity. The cache is already keyed by direction and every
    entry is timestamp-checked (stale/future reply), so clearing it only cost motion. This is
    the mechanism behind the remaining stutter: 4 sign-angular and 3 no-reply rejections in a
    20-frame sample.
2026-11-02 tune(nav): rotation shim threshold 0.35 -> 0.6 rad for a caster base
    Measured at doorways: four full stop-and-pivot events in 150 s, each forcing linear
    velocity to zero - the operator's 'very slow halfway through the door'.
    The base is a two-wheel differential drive with two casters (URDF confirms
    left/right_drive_wheel plus a caster), not a four-wheel scrub-steer, so arcing through a
    moderate corner has no scrubbing cost; the shim only needs to catch genuinely large
    heading errors. Also corrects the config comment that claimed four-wheel scrub.
2026-11-02 tune(safety): shallow the slow-down zone to 0.50 m so crossing a doorway does not trigger it
    The reply captured at every door dip was 0.12, exactly 0.15 x 0.8 - the front_slow zone
    reaching 0.75 m was catching the far door frame as the robot passed through. At 0.50 m
    only a genuine approach slows; front_stop at 0.38 m still guards the last stretch.
2026-11-02 fix(nav): the smoother was capping cruise speed at 0.12 while the controller asked 0.15
    The monitor's echo was permanently 0.12 with zero slowdown events in the log, which
    pointed upstream: velocity_smoother.max_velocity[0] was 0.12, clipping every command the
    controller produced. Aligned to 0.15 so the configured cruise speed is actually
    reachable, and any controller dip is now against a 0.15 baseline instead of 0.12.
2026-11-03 tune(nav): smoother max_accel 0.8 -> 0.35 to filter small command variations
    The old 0.12 velocity cap acted as a low-pass filter: the controller asked 0.15, the cap
    flattened it to a constant 0.12 and its small variations never reached the wheels. With
    the cap raised to 0.15 the +/-0.02 wobble passes straight through and the straight-line
    motion became jerky. A lower acceleration limit restores the filtering while keeping the
    higher cruise speed.
2026-11-03 docs: record the smoother settings and the unresolved odometry discrepancy
    max_accel 0.35 keeps the 0.15 cruise speed while filtering the command wobble that made
    straight lines jerky; the operator confirms it is better.
    Left open: /odom averages 0.231 m/s against a 0.142 m/s command, yet a 1.5 m straight run
    reported only 1.264 m of travel. Both cannot be right, so the odometry scale deserves a
    dedicated tape-measure calibration.
2026-11-03 feat(panel): draw a heading arrow at the start and goal points
    The goal's yaw is the approach direction (atan2 from the current pose to the goal), which
    was invisible in RViz - only a sphere marked the point. Both points now also get an
    arrow along that same yaw, so the final heading is visible before starting.
    Uses the identical formula the goal request uses, so the arrow cannot disagree with the
    heading actually commanded.
2026-11-03 feat(panel): manual goal heading - checkbox plus degrees spin box
    The goal yaw was always derived from the approach direction, with no way to override it
    when the operator wants the robot to finish facing a particular way (into a room, along a
    corridor). A '手动朝向' checkbox enables a -180..180 degree spin box whose value is used
    for the goal request and for the arrow, so the displayed heading is always the one that
    will be commanded; toggling or editing republishes the markers immediately.
2026-11-03 fix(firmware): let the speed loop's integral go negative, and correct the device paths
    Measured with /base/motor_debug and /wheel/odom at the same time: the firmware's own
    speed estimate (214 mm/s) matched ROS odometry (204) but both were 1.5x the commanded
    141 mm/s, so the loop simply was not converging. The feedforward 0.22+0.0035v is too high
    at low speed and the integral term was clamped to [0, 0.75], so the error could never be
    trimmed downward. Allowing [-0.30, 0.30] lets it settle.
    Also fixes AGENTS.md, which had the ESP32 and IMU serial ports swapped: udev reports
    ttyACM0 = Espressif, ttyACM1 = DM-Tech IMU. base_bridge already used the by-id path, so
    the running system was unaffe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
    [control.c]
2026-11-03 tune(nav): cruise speed to the 0.20 ceiling now that the firmware tracks commands
    With the speed loop fixed the command is finally honest: /cmd_vel 141.6 mm/s produced
    143.7 mm/s of real motion, against 214 mm/s before. That felt slower only because the
    base used to overshoot by 50%, so the setpoint is raised to the documented 0.20 m/s
    ceiling (enforced by test_real_frames_speed_and_recovery_policy) and the smoother limit
    follows it.
2026-11-03 revert(firmware): restore the original speed loop, compensate in ROS instead
    Letting the integral go negative did converge (141 mm/s command produced 143.7), but the
    feedforward is still far too high for low speeds and the two terms fought: measured speed
    swung 0 <-> 0.46 m/s with twelve stop-go segments in 80 s. Reverting the firmware and
    scaling the commanded wheel speed by 0.66 in base_bridge gives a stable base at the right
    speed without another round of PID tuning; v and omega are scaled together so the turning
    radius is unchanged. Set wheel_speed_scale back to 1.0 once the firmware is recalibrated.
    [control.c]
2026-11-03 feat(ultrasonic): poll the rear sensors only while reversing
    The four rear ultrasonic heads were polled at 6 Hz around the clock, which kept the
    RS-485 bus busy and published Range messages continuously even though the robot never
    reverses automatically today.
    Polling now starts when /explore/state becomes 'reversing' and stops as soon as it
    leaves; the transition takes a sample immediately so the gap is a single cycle. rear_guard
    already treats stale data as blocked (fail_safe_block: true), so an idle bus conservatively
    forbids reversing - the safe direction - and the guard clears within a second of the state
    changing.
2026-11-03 feat(mapping): spin in place once at the start of auto mapping
    Starting SLAM from an empty map leaves the planner with almost no known terrain, so the
    frontier explorer heads into unknown space with nothing to plan against. An initial slow
    in-place rotation lets the 270 degree lidar paint the surrounding walls first.
    New initial_spin node: rotates only (angular 0.30 rad/s, no linear motion) on the manual
    channel, accumulates the heading from /odom until it has swept 2*pi, aborts immediately if
    anything is closer than 0.35 m in the front +/-25 degrees or after 40 s, opens the motion
    gate and manual mode for the duration and closes manual again when done, then calls
    /explore/start so the exp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
2026-11-03 fix(mapping): let the initial spin finish before room_explorer takes over
    room_explorer drives the base itself - it publishes on /cmd_vel_manual every few seconds
    and toggles the motion gate - so it started moving the robot forward the moment the stack
    came up and shared the topic with initial_spin. The explorer is now started through a
    TimerAction (explorer_start_delay_s, default 32 s) so the spin gets a clear run first.
2026-11-03 refactor(mapping): hand over on the spin-finished event, not a fixed delay
    The explorer now waits for /mapping/spin_done (transient local, so a late subscriber
    still sees it) and initial_spin publishes it the moment the 2*pi sweep completes. The
    TimerAction delay is gone: the handover happens exactly when the spin is done, however
    long that takes.
2026-11-03 fix(mapping): supervisor waits for the spin, and the rear guard is off while spinning
    Three nodes were fighting over the base at startup: initial_spin rotating, the supervisor
    kick-starting after 15 s, and the rear ultrasonic guard blocking reverse because the
    sensors are idle unless the state is 'reversing' (so the guard fails safe).
    The supervisor now also waits for /mapping/spin_done before its kickstart countdown, and
    initial_spin turns rear_guard_enabled off for the duration of the rotation and restores it
    immediately afterwards - the spin only rotates, so rear protection buys nothing there.
2026-11-03 fix(mapping): retry opening the motion gate until the parameter service answers
    _gate_on was set to True even when the set_parameters service was not ready yet, so the
    one attempt at startup was silently dropped and the gate stayed closed - the robot never
    moved while the log filled with 'disarm tick-sensors'. _set_bool now reports whether the
    request was actually sent and the tick retries until it is.
2026-11-03 fix(mapping): pass initial_spin's enabled as a real bool
    LaunchConfiguration renders to the string 'true', and the node declares 'enabled' as a
    bool, so get_parameter raised ParameterTypeException inside the timer callback - the node
    died silently right after 'process started', the motion gate was never opened and the
    robot never moved. Wrapped in ParameterValue(..., value_type=bool).
2026-11-03 fix(mapping): create the spin timer, and take the front arc by angle
    Two real defects, found by running the node standalone rather than guessing:
    1. self._done and create_timer() had ended up after a return statement inside _set_bool,
    so the timer was never created and _tick never ran - the node was silent, never
    opened the gate and never rotated.
    2. _front_min used len(ranges)//2 as the front, which on this reversed lidar is the rear
    self-return at 0.09 m, so the spin aborted immediately with 'front too close'. The
    front arc is now chosen by angle (|angle| > 155 deg), skipping the rear +/-50 deg body
    return; measured 0.69 m, matching the supervisor's own reading.
2026-11-03 refactor(mapping): the supervisor itself spins 360 degrees, waits 2 s, then hands over
    initial_spin was a second driver fighting the supervisor that already knows how to open
    the gates and drive, which is why nothing moved. The spin is now a phase of the
    supervisor: gates open -> spin at spin_rad_s until 2*pi of accumulated heading -> stop and
    hold 2 s -> publish /mapping/spin_done so room_explorer takes over. initial_spin is no
    longer launched.
2026-11-03 chore(mapping): log the room explorer's tick inputs
    It started and then produced no output at all, so there was no way to tell which guard was
    returning early. Every 3 s it now prints the map size, the robot position and the age of
    the last map update.
2026-11-03 chore(mapping): report why the room explorer declines to dispatch
    The tick had several silent returns between the inputs and goal selection, so from the
    logs it was impossible to tell whether it was blocked by a pending goal, an all-unknown
    map or the robot being outside the grid. Each of those now logs [skip] with the reason,
    throttled to 3 s.
2026-11-03 fix(mapping): restore the supervisor and explorer to their v1.2 source
    My regex edit that removed the initial-spin code also deleted the supervisor's
    create_timer call, so the node came up in phase 'waiting' with its _tick never invoked:
    it never opened the motion gate, /base/ready stayed false, Nav2 never planned and nothing
    moved - while the logs showed nothing at all from it. room_explorer had picked up the
    same kind of damage plus the spin wait, so both files are restored from v1.2, where the
    handoff to the explorer is immediate again.
    Adds test_auto_mapping_nodes_wired: any node with a _tick must create its timer inside
    __init__, so this silent-shell failure cannot recur unnoticed.
2026-11-03 chore(mapping): the explorer reports which guard held it back
    Logging only. Each silent return in _tick now prints [skip] with its reason, throttled to
    3 s, so the next run says whether it is a missing pose, an unknown map, a map-outside
    robot, a pending goal or no frontier.
2026-11-03 chore(mapping): prove whether the explorer tick runs at all
    Holds the timer in self._timer and logs the 1st, 5th and 20th callback. Everything else
    checks out - the timer is created inside __init__, the build copy matches the source and a
    manual _tick() call logs normally - so the next run will show whether the callback fires.
2026-11-03 chore(mapping): surface exceptions thrown inside the explorer tick
    The tick fires on schedule and reaches neither a skip log nor a dispatch, which leaves an
    exception as the only explanation - and timer exceptions never reach launch.log. _tick is
    now a thin wrapper that logs the traceback (throttled to 5 s) around _tick_impl.
2026-11-03 revert(ultrasonic): poll the rear sensors continuously again
    Idle polling turned out to break the whole auto chain: with no data rear_guard fails safe
    and reports the rear blocked, so the explorer's short-reverse escape can never finish, it
    leaves manual_enabled stuck at True, and auto_command_gate then zeroes every navigation
    command. Continuous polling at 6 Hz costs little and keeps the escape path working.
2026-11-03 docs: pin the auto-mapping pitfalls in AGENTS.md
2026-11-03 fix(mapping): widen the goal standoff search so wall-corner frontiers survive
    Next to a wall every cell within 0.4 m of a frontier is inside the inflation and scores 99,
    so _goal_traversable returned None, the goal was blacklisted, and after two failures the
    explorer escaped instead of exploring - the corner left-right loop. The standoff search
    now reaches 0.8 m.
2026-11-03 fix(mapping): stopping from the panel really stops the exploration
    The stop button only zeroed the velocity, closed the motion gate and saved; nothing told
    the supervisor or the room explorer to stand down, so within seconds they opened the gate
    again and the robot started driving - while the operator was handling the USB cable, which
    is how it got torn out.
    The panel now publishes /mapping/run (transient local): false on stop, true on start. Both
    nodes subscribe, and while it is false the supervisor refuses to open the gate and the
    explorer zeroes its velocity, drops any pending goal, cancels an escape and releases manual
    mode. The latch means a node started later also sees 'stopped'.
2026-11-03 fix(panel): opening the motion gate must not enable manual mode
    'Start mapping' set motion_enabled, manual_enabled and manual_allow_mixed together, but
    base_bridge and auto_command_gate treat manual_enabled=True as 'the auto chain is blocked',
    so every navigation command was zeroed and the robot never moved after a stop/start cycle.
    Only motion_enabled is opened now; the manual channel stays free for the explorer's own
    escape manoeuvres.
2026-11-03 fix(mapping): stop the explorer's short-reverse escape from blocking the auto chain
    The escape needs /explore/state='reversing' for base_bridge to accept a reverse command,
    but the supervisor overwrites that topic with 'navigating' every 50 ms. The reverse is
    therefore always refused, the escape never completes, manual_enabled stays True for the
    whole time, and the gate zeroes every navigation command. Escapes are disabled in the
    auto-mapping launch (escape_after_failures 9999); Nav2 has its own recovery behaviours.
2026-11-03 tune(mapping): replan at 0.25 Hz so the shim can finish aligning
    At 0.5 Hz the path is replaced every 2 s; whenever the new path starts pointing the other
    way the rotation shim pivots the opposite direction, so the robot oscillated in place -
    481 frames, 26 sign flips, mean linear velocity 0.0 over 25 s. Four seconds between plans
    gives the shim time to align and start driving.
2026-11-03 tune(mapping): rotation shim threshold 0.6 -> 1.0 rad
    In tight spots (doorways, wall corners) the heading error is almost always beyond 34
    degrees, so the shim pivoted on the spot instead of driving: 25 s of commands had a mean
    linear velocity of exactly 0.000 and 26 sign flips on the angular axis. 57 degrees lets
    regulated pure pursuit arc through the turn while still catching a genuine U-turn.
2026-11-03 tune(mapping): shrink the approach slowdown zone to 0.25 m
    RPP's default approach_velocity_scaling_dist of 0.6 m covers most of the trip when the
    frontier goals are only 1-1.4 m away, so the robot never reached cruise speed (mean linear
    velocity 0.054 against a 0.15 target).
2026-11-03 tune(mapping): disable shim pivoting entirely (threshold pi)
    Pivoting still ate 66 percent of the time at wall corners. On a two-wheel differential
    base with casters an arc costs nothing, so the shim is set to never take over and regulated
    pure pursuit drives and turns at the same time.
2026-11-03 fix(launch): the explorer parameters were attached to the wrong node
    escape_after_failures and replan_s had been inserted into map_free_around_robot's
    parameters (the first matching block) instead of room_explorer's, so the explorer kept
    running with the defaults: escapes still active (which locks manual mode and blocks the
    auto chain) and a 3 s decision period. Moved to the room explorer node.
2026-11-03 tune(mapping): explore global frontiers instead of staying in one room
    Room gating segments the map by eroding doorways and prefers frontiers inside the current
    room; once the robot reached the corridor that corridor became its 'room' and, as long as
    it had any frontier left, the explorer never considered the rooms off it.
2026-11-03 tune(nav): lookahead 0.60 -> 0.45 so pure pursuit stops cutting doorways
    The path itself is centred but a 0.6 m carrot makes regulated pure pursuit cut the inside
    of doorway turns, which is what scrapes the frame. A shorter carrot tracks the line more
    tightly; min lookahead follows to 0.32.
2026-11-03 tune(nav): footprint padding 0.02 -> 0.05 m to keep clear of door frames
2026-11-03 revert(nav): footprint padding back to 0.02
    At 0.05 the inscribed radius grew enough that every candidate standoff within 0.8 m of a
    wall scored 99, so the explorer blacklisted goal after goal and the robot stopped moving
    entirely. Inflation stays at 0.50.
2026-11-03 revert(nav): inflation back to 0.48, which the explorer can actually plan with
    0.50 pushed the cost at every standoff candidate within 0.8 m of a wall to 99, so goals
    were blacklisted faster than they were dispatched. 0.48 is the value the two-point
    navigation was validated with.
2026-11-03 fix(mapping): never blacklist a goal just because no free standoff was found
    At doorways every frontier sits in a tight spot and the standoff search found no cell below
    the inscribed cost, so goals were blacklisted faster than they could be dispatched and the
    robot stopped for good. The search radius grows to 1.2 m and, if it still finds nothing,
    the frontier itself is returned so Nav2 gets a chance and the 15 s goal timeout moves on.
2026-11-03 fix(mapping): the hard-coded skip-streak escape ignored escape_after_failures
    Three untraversable goals in a row still called _start_escape, which switches the base to
    manual mode; auto_command_gate then zeroes every navigation command and the robot stays
    put for good while the log only shows repeated blacklists. The threshold now comes from
    the same parameter, so 9999 really disables escapes.
2026-11-03 feat(recovery): stop reversing once the lidar shows room to turn
    The reverser only stopped on a fixed 0.4 m, the 8 s timeout or the rear interlock, so in a
    corner it ground away at six centimetres a second and gave up two centimetres in. It now
    watches the front 120 degree arc (split left/right, remembering the lidar is mounted
    backwards) and ends the manoeuvre as soon as both sides clear turn_clear_m (0.9 m), with a
    1.2 m hard cap so it can never drive off backwards.
2026-11-03 revert(nav): restore the v1.2 navigation tuning
    Yesterday's auto-mapping work changed four shared navigation parameters and the behaviour
    tree: the rotation shim was disabled outright (3.1416), the carrot shortened to 0.45, the
    approach slowdown zone cut to 0.25 and replanning halved to 0.25 Hz. Those helped mapping
    but made navigation wobble on straights and fail to pivot in doorways, so the file goes
    back to the v1.2 values that were validated on the real robot.
2026-11-03 fix(safety): the selector's left and right sectors were the same value
    _sector_min() computed the identical angular range for side=+1 and side=-1, so
    requested and opposite always matched. The 'requested side blocked, turn the other way'
    recovery could therefore never trigger: rotation was allowed only when the narrow +/-20
    degree front sector was clear, and the robot sat still whenever it faced a wall - the
    stutter the user reports, since every alignment needs a rotation. Left front is now
    150..180 and right front -180..-150 as the reversed lidar requires.
2026-11-03 fix(safety): a stale angular sign no longer kills the whole frame
    When the monitor reply lagged by one cycle its angular sign disagreed with the new command
    and the selector zeroed the entire frame, linear velocity included - the stutter on
    straights, since regulated pure pursuit flips the steering sign constantly. Now only the
    angular part is zeroed and the robot keeps driving straight; the next reply restores
    steering. Rotations still reject the whole frame, and the opposite-direction guard is
    untouched.
2026-11-03 docs: the two safety-chain bugs behind the stop-and-go stutter
2026-11-03 feat(nav): multi-point navigation - first click is the start, last is the end
    Panel: every click is appended to one route instead of the third click resetting the
    selection, so the first point is the start, the last is the goal and everything between is a
    waypoint (1 click still means the old single-destination flow, 2 clicks still the validated
    two-point flow, 3+ go through the new service).
    Runner: /explore/start_multi_point_goal validates every point and dispatches a single
    NavigateThroughPoses goal, so waypoints are passed at speed instead of stopping at each one.
    It needs a dedicated behaviour tree (ComputePathThroughPoses) - the stock one depends on the
    /backup action we do not enable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
2026-11-03 feat(panel): draw the full multi-point route in the preview
    The preview used to show only start to goal because it built two legs. With three or more
    points it now calls compute_path_through_poses once for the whole route, so the blue line
    runs current pose -> start -> every waypoint -> goal.
2026-11-03 fix(nav): a multi-point route whose goal sits on the robot used to end instantly
    Nav2's goal checker only looks at the last pose of a through-poses goal, so a closed loop
    that ends where the robot is standing was declared complete twenty milliseconds after it
    started - the whole route was skipped. When the tail point is within a metre the runner now
    falls back to sequential legs, which always executes every point in order.
2026-11-04 tune(safety): front_stop half-width 0.24 -> 0.22 to stop door frames freezing the robot
    Measured twice: collision_monitor zeroed the command in 531 and 1220 frames while the path
    ahead was clear, including one continuous 12.2 s block - the stop polygon's corners reach
    0.24 m laterally, 2.5 cm wider than the 0.215 m chassis, so passing a doorway put the frame
    inside the box and the robot sat still until Nav2 gave up. 0.22 keeps the chassis covered
    (the guardrail test forbids anything narrower) and still stops for anything within
    0.32-0.38 m straight ahead.
2026-11-04 revert(safety): keep stop_pub_timeout at 18 s, the guardrails demand it
    Lowering it to 2 s would stop holding zero long enough for Nav2's 15 s progress check to
    abort a blocked goal; two tests pin the range (17..20 and >= 15+2), so the value goes back
    and the reasoning is recorded next to it. The real doorway fix was narrowing the stop
    polygon, which already cut front_stop events from 42 to 2.
2026-11-04 fix(nav): the two new callbacks were never inserted, the explorer crashed on start
    The subscription lines landed but the anchor for the method bodies did not match, so the node
    died with AttributeError on its first spin. Methods added and the node now starts.
2026-11-04 feat(nav): re-plan automatically after a stuck cancel instead of ending the task
    Cancelling at 2.5 s (previous commit) fixed the 15 s freeze but left the robot standing there
    with the task over. The runner now re-dispatches the same task right away - through-poses,
    the remaining legs, or a fresh frontier - up to max_stuck_retries (2) times, so an
    over-turned U-turn costs a couple of seconds instead of the whole task.
2026-11-04 tune(nav): turn off regulated pure pursuit's cost-based speed scaling
    The user's clue - it slows down exactly when the front has passed half the doorway - points
    at cost regulation: RPP scales linear velocity by the costmap value around the robot, and
    while the chassis straddles a door both sides sit inside the 0.48 m inflation, so the cost
    saturates and the speed collapses until the frame is behind the robot. Curvature scaling
    was already off; this one had been left at its default (true).
2026-11-04 fix(nav): only treat a monitor stop as stale when the stop box is really empty
    The detector claimed 'the stop box is already empty' without ever looking at the scan, so a
    genuine obstruction at a door frame was cancelled and retried twice and then ended the whole
    task. It now counts the scan points inside the stop polygon and only cancels when that count
    is zero; a real obstruction is left to the safety layer and Nav2's progress check.
2026-11-04 tune(nav): lookahead 0.60 -> 0.55 so the robot tracks doorways closer to centre
    Pure pursuit cuts the inside of bends more the further its carrot sits: at 0.60 the robot
    hugged door frames (side clearance about 2 cm) and tripped the stop polygon. 0.55 tightens
    the tracking without the straight-line wobble that appeared at 0.45.
2026-11-04 docs: v1.4 release notes - doorway speed and door-frame stops resolved
2026-11-04 docs+tool: auto-mapping design record and guards against silent node crashes
    - docs/plans/2026-11-04-auto-mapping-viewpoint-plan.md: current planning stack, measured
    comparison of area coverage vs viewpoint coverage (891 m/74 min vs 159 m/17 min), why room
    segmentation is unreliable on this map, the radius-bounded coverage design, and the
    anti-flip BT plan. All of it is design-only; no navigation file is touched.
    - test_nodes_attributes_defined.py: fails the build if a node class reads a self attribute it
    never assigns - the exact cause of both 'robot does not move' incidents today.
    - tools/check_stack.sh: six-point runtime self-check (processes, graph, services, frozen
    parameters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
2026-11-04 feat(mapping): viewpoint planner core, node, config and tests (disabled by default)
    New files only - no navigation file is touched.
    - viewpoint_core.py: pure functions for free/blocked/unknown masks, erode/dilate, grid BFS,
    ray visibility with fan fill, next-viewpoint scoring, frontier expansion targets.
    - viewpoint_planner.py: ROS node gated by 'enabled' (default false); it only calls the
    existing /explore/start_fixed_goal service, so the validated navigation path is reused.
    - config: radius 4->8 m, sensor 6 m, 180 rays, 2-cell fill, min gain 400 cells, 3 s dwell.
    - 8 unit tests including two regression cases found while simulating:
    sparse rays under-report visibility, and treating '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
2026-11-04 feat(mapping): wire the viewpoint planner and conditional-replan BT behind off-by-default switches
    - real_navigation.launch.py: the to-pose BT path becomes a launch argument whose default is
    still real_navigate_to_pose.xml, so navigation behaviour is byte-for-byte unchanged unless
    someone passes the argument.
    - real_auto_mapping.launch.py: three new switches (viewpoint_planner, viewpoint_enabled,
    mapping_bt), all defaulting to false; the viewpoint node also reads a config file whose
    'enabled' is false, so starting it does not move anything.
    - behavior_trees/real_navigate_to_pose_mapping.xml: replan only when IsPathValid says the
    current path is broken (AlwaysSuccess otherwise), whi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
2026-11-04 test+tool: verify every BT node exists in Nav2, and stop the param check from false-alarming
    - new test parses the mapping BT and asserts each node id is either registered by Nav2 or a
    BehaviourTree.CPP core node, which is the class of mistake that produced 'Empty Tree' or
    'behavior tree threw exception' and made a goal die in two milliseconds.
    - check_stack.sh retries a timed-out parameter query once and reports it as unknown instead
    of a failure (DDS discovery occasionally exceeds 10 s on the first call).
    253 tests pass; stack self-check is green again.
2026-11-04 fix(mapping): the conditional-replan BT never planned; slow the replan rate instead
    Two attempts at guarding the planner with IsPathValid both left the robot completely still
    (/plan zero times, zero displacement), because on an empty path the node reports the path as
    valid, so the compute node was skipped forever. The mapping tree now keeps the proven
    structure and simply replans at 0.2 Hz instead of 0.5 Hz, which cuts the mid-course route
    switching opportunity by 60 percent while guaranteeing planning.
    Verified on the robot by A/B: navigation tree 12 plans / 2.04 m, mapping tree 7 plans /
    0.33 m with the map growing 2723 cells in 30 s.
2026-11-04 feat(mapping): viewpoint planner drives Nav2 itself; kickstart reverse and stuck_reverser become switchable
    - viewpoint_planner no longer depends on the service that frontier_explorer provides, so the
    old explorer can stay off; it opens the gate the same way the supervisor does
    (motion_enabled + /base/arm_auto + /base/ready), sends NavigateToPose itself, and closes
    the gate on failure, on cancel, on stop and on shutdown.
    - completion now needs 'no frontiers AND the map stopped growing'; coverage alone was wrong
    because at start-up one viewpoint covers 100 percent of the tiny map.
    - start-up deadlock found while testing: the robot cell often falls outside the eroded
    drivable mask, s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
    [real_viewpoint_planner.yaml]
2026-11-04 feat(mapping): viewpoint planner now drives the robot end-to-end and maps successfully
    Verified on the robot: 13 navigation goals, all succeeded, map grew 9500 -> 11664 cells,
    robot advanced 0.88 m per hop, all with the old explorer off and no reversing.
    What it took, all found by measurement:
    - goals shorter than 1.2 m are rejected (Nav2's 0.4 m tolerance made them no-ops),
    including frontier-expansion targets;
    - bootstrap is a Nav2 goal projected 1.5 m along the most open lidar direction, because the
    manual path (/cmd_vel_manual) is unreliable here: the base drops those commands whenever
    its sensors_ready flag flickers to zero, which is also why the original kickstart timed out
    in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
    [real_viewpoint_planner.yaml]
2026-11-04 tune(mapping): dwell 3s -> 1s and record the parameter lessons from the live run
    Worker configuration verified on the robot: 13 goals, all succeeded, map 9500 -> 11664 cells.
    dwell_s dropped to 1.0 because the 3 s pause made the drive read as 'move a bit, stop, move a bit'.
    Recorded what actually decides the parameters:
    - bootstrap_max_cells must stay small (4000): the bootstrap goal has to land on a cell the map
    already knows is free, so a large threshold makes it spin without ever dispatching
    (20000 was measured to stall with zero goals in 110 s).
    [real_viewpoint_planner.yaml]
2026-11-04 fix(mapping): batch ordering, the missing manual-gate close, and the through-poses field name
    Three faults found from the robot and the traceback:
    - NavigateThroughPoses.Goal has no 'goals' field; writing goals crashed the node and the base
    stopped dead. It is 'poses'. A test now asks the ROS message definition directly.
    - the batch picked every point by its distance to the robot instead of to the previous point,
    so the order came out far -> near -> far and the planner drew a zig-zag that made the robot
    swing left and right. Each step now measures from the previous point.
    - dispatching a batch while manual_enabled was still true made _open_gate() refuse forever
    (16 'waiting-gate' cyc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
    [real_viewpoint_planner.yaml]
2026-11-04 feat(mapping): rolling waypoint chaining removes the stop-and-go, plus room and door fixes
    The user's idea, implemented: keep three waypoints queued, and when only two remain, plan one
    more and resend the whole route, cancelling the old goal. The result on the robot is continuous
    motion - 0 percent stationary frames, 399 of 399 forward frames, 3.76 m in 20 s, against
    38-100 percent stationary before.
    Two side effects had to be fixed in the same change:
    - the radius test was measured from the previous waypoint, so chained picks walked the robot
    out of the room before it was finished; the radius now anchors to the robot (home_dist) while
    ordering still uses the previous point, which keep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
    [real_viewpoint_planner.yaml]
2026-11-04 feat(mapping): no backtracking inside a batch, and a perimeter pass before leaving a room
    Two things the user asked for after watching the robot:
    - waypoints inside one batch are now sorted by distance from the robot. Picking by gain
    alone produced far -> near -> far orders, so the robot drove forward and then doubled back.
    - once the radius zone is 85 percent seen the planner drives the room's inward-offset outline
    as a closed loop before it is allowed to head for a door, which is what the user proposed:
    'when a room has taken shape, go round its edge once so the walls are certain, then leave'.
    The loop is sampled by polar angle, so it cannot double back, and a 180 s cooldown keeps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
2026-11-04 feat(mapping): ignore corners no viewpoint can observe, and treat a coverage plateau as room completion
    A) observability mask: every batch already raycasts all candidates, so their union tells us
    which free cells any reachable viewpoint could ever see. Corners behind furniture are not
    in that union, so they no longer hold the coverage figure below the threshold that gates the
    perimeter pass - which is why the robot kept chasing pockets inside a room that was already
    finished.
    B) plateau guard: if the observable coverage has not improved by one percent for plateau_s while
    the robot has travelled more than two metres, the room is treated as done, the perimeter pass
    is re-ar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
2026-11-04 fix(mapping): recover from latched base faults, the real reason the robot died in the corridor
    The corridor stop was not the planner: the base reported fault 1 (BASE_STALL) and stopped
    accepting commands, so /base/ready went false and the viewpoint planner could not open its gate
    (150 'disarm fault' lines, ready=false, fault=1).
    The stuck guard now watches /base/fault and /base/ready, and on a latched fault it closes every
    motion gate and calls /base/clear_fault, which is exactly what the firmware requires before it
    will clear. It never publishes a velocity and gives up after max_fault_clear attempts.
2026-11-04 fix(safety): latch the rotation-flip decision so the wheels stop reversing every frame
    Root cause of the corridor fault, found by comparing two runs of the same configuration:
    the selector's 'blocked-rotate-flip' branch - never forward, so rotating to the open side -
    fired 94 times in the run that stalled and zero times in a clean run. The rotation clearance
    threshold is 0.16 m, lidar noise crosses it frame by frame, so the selector alternated between
    'move' and 'flip the rotation' every tick. Both drive wheels were therefore commanded in
    opposite directions continuously: almost no displacement while PWM stayed above 12 percent,
    which is exactly the firmware's two-second stall rule, so it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
2026-11-05 snapshot: bigger map covers the whole floor, new save/run helpers, MAX_DUTY retest
    Working-tree changes made after the v1.4 line (committed here so v1.5 has a restore point):
    - firmware: MAX_DUTY 0.90 -> 0.95, retested now that the robot runs on rubber wheels; the old
    0.90 conclusion came from plastic wheels spinning on tile. Host tests updated to match.
    - real_nav2.yaml: the global costmap window grows from 880x800 @ (-24,-32) to 968x645 @
    (-33.3,-21.4) so it covers real_map_manual_20261104_172107 with about one metre of margin on
    every side. No other navigation parameter is touched.
    - new: slam_map_save node, run_navigation launch and the run_navigation / start_manual_mapping
    sc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
2026-11-05 fix(localization): reject degenerate global matches; drop the padded map
    Two regressions from padding the map, both measured today:
    - padding with unknown made the planner drive around the outside of the building (1 m ring of
    free space, because track_unknown_space is false): an 11 m straight-line goal came back as a
    97 m loop with 1876 poses.
    - padding with occupied walls made the global matcher find a 'match 0.000 m' inside the band of
    walls and seed the robot into the corner (-32.72,-18.11).
    So the padded map is removed and the original map is used again. auto_initial_pose now refuses
    to seed unless the matched pose sits in known free space with 10 cm of clearance; a degenerate
    m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
2026-11-05 docs(hardware): WSDC2412D-V3.0 wiring to the 24V motors and ESP32-S3
    Complete pin-by-pin wiring for the new dual-channel driver:
    - power side: both P+ pairs and both P- pairs, 16 AWG, 15 A fuse on the bus,
    M1_A/M1_B to the left motor and M2_A/M2_B to the right one
    - control side CN1: VCC 3.3 V (must match the logic amplitude and stay under
    5.2 V, never from a cheap buck), PWM1=GPIO4, INA1=GPIO5, INB1=GPIO12,
    PWM2=GPIO6, INA2=GPIO7, INB2=GPIO13
    - the four existing PWM wires keep their physical positions and only two new
    direction wires are needed
    - encoders bypass the driver: A/B to GPIO8/9 and GPIO10/11, Vcc 3.3 V preferred
    because the S3 GPIOs are not 5 V tolerant
    - 10k pull-down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
2026-11-05 test: pin the new costmap split, local keeps the obstacle layer and global must not
    The previous test asserted an obstacle layer in both costmaps, which was exactly the design that
    got polluted (see the previous commit). It now requires the obstacle layer on the local costmap
    only and adds a dedicated test explaining why the global one must stay clean: 260 degree field of
    view means its marks can never be fully ray-cleared, so goals end up inflated to 99 and planning
    refuses them.
2026-11-05 feat(panel): split navigation and mapping buttons by mode, add a seed-localisation button
    User request: while navigating the panel should not show the mapping buttons (start/stop/save
    map), and while mapping it should show only those plus the fault reset. The panel now has a mode
    selector that defaults to whatever it detects at start-up (slam_toolbox present means mapping) and
    groups the buttons into two containers that are shown or hidden together; the fault reset stays
    visible in both modes.
    New '播种定位（用选中点）' button: pick a point on the map where the robot really is and press it;
    the panel publishes /initialpose at that position with the robot's current heading, plugge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
2026-11-05 feat(localization): one-click reseed from the panel, for after the robot has been carried
    auto_initial_pose now serves /localization/reseed (Trigger). Calling it resets the seeder and
    runs the same matching it does at start-up - refine from the last known pose first, and only fall
    back to a full global search when that does not fit - then seeds AMCL through the validated path
    (free space, wall overlap, unknown ratio).
    The panel button no longer publishes /initialpose itself; it calls that service and reports the
    outcome in its status line, so moving the robot no longer requires pressing 2D Pose Estimate.
    Verified on the robot: the service returns 'reseeding started', then the log shows
    'c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
2026-11-05 fix(localization): the global search could not finish, so one-click reseed never returned
    find_best_pose looped over every pose in pure Python: 46x30 m at 0.2 m and 5 degrees is about
    2.5 million candidates, each calling score_pose over ~600 scan points. Start-up never noticed
    because the checkpoint refinement usually succeeds first; but pressing 重新定位 after carrying the
    robot always falls through to the global search, which then ran for hours - the pose never moved,
    exactly what the operator reported.
    The search is now vectorised: candidate positions come from the free cells (subsampled by
    coarse_step), scan points are thinned to 80, and each yaw evaluates all candidates in one num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
2026-11-05 feat(localization): the reseed service now returns the result, so the panel can say success
    Pressing 重新定位 used to answer 'reseeding started' and nothing else; the operator could not tell
    whether the match worked. The service now runs the match inline (pure computation, about a second
    now that the search is vectorised), validates it, sends the seed, and returns
    '定位成功: (x, y, θ) 残差 …' or a concrete failure reason (wall overlap, unknown ratio, residual,
    not in free space). The panel prints whatever the service returns instead of its own wording.
    Also repaired a self-inflicted splice that had duplicated _scan_overlap, _pose_is_sane and the old
    _on_reseed (the slice went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
2026-11-05 feat(tools): keep the unknown area when the map editor saves, and do it automatically
    The RViz map editor writes every unknown cell as free: on the first edited map this turned 286825
    unknown pixels into 'free', flattening the whole unexplored area, while the operator had only
    drawn 946 wall pixels and erased 89.
    fix_map_unknown.py re-applies only the real edits onto the baseline map (new walls become black,
    erased walls become white, everything else including unknown stays as it was). watch_map_edits.py
    watches the maps directory and produces <name>_fixed automatically a couple of seconds after a new
    map appears, using the baseline recorded in /tmp/fwr_runs/current_baseline.txt.
    Verified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
2026-11-05 feat(explorer): log why a mission stops, instead of ending it silently
    Every silent stop path now calls _trip(), which prints one line per distinct reason:
    manual_enabled being switched on, the base losing its auto arm, a reported fault, the operator
    pressing stop, the trial timeout, and the state machine returning stop (with map/pose/fault
    staleness spelled out plus the mission status and leg counter). Repeated identical reasons are
    suppressed so the 10 Hz callbacks do not flood the log.
    Motivation: a route that ended after its first leg produced only 'Goal was canceled' in the log,
    with no record of which watchdog had disabled the state machine first. A guard test pins the
    reason string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
2026-11-05 fix(explorer): sequential legs when a route ends near its start, threshold now 2.5 m
    A live route ended after 11 s with 'Goal succeeded' while the robot was 0.28 m from the final pose:
    with NavigateThroughPoses the goal checker only looks at the last pose, so a route whose end lies
    close to its start is declared finished as soon as the robot passes by it, and the intermediate
    waypoints are never visited. The old guard used 1.0 m and this route's tail gap was 1.29 m.
    The threshold is now the parameter fixed_route_tail_gap_m (default 2.5 m) instead of a bare 1.0,
    so routes that come back near their start run as sequential legs and every waypoint is really
    visited. The dispatcher also logs e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
2026-11-05 fix(explorer): skip route waypoints the robot is already standing on
    Route A ended with the robot circling its first waypoint: that point sat 0.26 m from the robot,
    so NavigateThroughPoses had a zero-length first segment and the controller kept steering around
    it (commanded 0.2 m/s with -0.55 rad/s for as long as the goal lived).
    The dispatcher now drops waypoints closer than route_skip_near_m (0.6 m, new parameter) to the
    current pose, logs exactly which points were dropped, and keeps the route intact when that would
    leave fewer than two points.
2026-11-05 feat(panel): space bar stops and resumes navigation, buttons say so
    The stop and resume buttons are now labelled '停止导航（空格）' and '继续导航（空格）', and a Space
    shortcut is registered with Qt::ApplicationShortcut so it works even while the operator is
    interacting with the 3D view. Space stops when a task is pending or active and resumes when a
    previous goal is available; with neither it only reports that there is nothing to toggle.
    Both builds and the 15 panel tests pass, plus 276 python tests including a guard that the labels,
    the shortcut and the application-wide context stay in place.
2026-11-05 fix(panel): resuming a multi-point route re-sends the route, not just its last pose
    Live evidence: after stop, resume dispatched 'Fixed goal leg 1/1: x=0.26 y=-0.63' for a route that
    had five points, and because that final pose sat 0.36 m from the robot (inside the 0.4 m goal
    tolerance) Nav2 declared success at once, so pressing resume ended the task.
    The resume path now remembers whether the interrupted task was multi-point and, in that case,
    calls the multi-point service starting from the waypoint nearest the robot (at least two poses are
    sent so a route is never degraded to a single goal). Two-point and single resumes keep their
    previous behaviour. Verified by build, the 15 panel tests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
2026-11-05 fix(nav): keep the global obstacle layer so new obstacles are actually avoided, and clear it periodically
    Removing the layer fixed the phantom-obstacle pollution but broke dynamic avoidance: the global
    planner only saw static walls, so a box appearing on the path was never routed around and the robot
    just sat behind front_stop - exactly what the operator reported.
    The layer is back, and the pollution is now handled where it belongs: frontier_explorer clears both
    costmaps every costmap_clear_period_s (default 10 s). A clear only drops stale marks - the next
    scan re-marks everything currently visible, so genuine obstacles come back within one cycle while
    the marks accumulated behind the 260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
2026-11-05 fix(explorer): only clear the costmaps while idle, so a running plan keeps its obstacles
    Clearing every period regardless of state could wipe a dynamic obstacle during the exact frame the
    planner recomputes, letting it plan straight through. The periodic clear now runs only when no goal
    is active, which is enough to keep the accumulated stale marks down between missions; the existing
    'clear after two consecutive failures' path still handles pollution during a mission.
2026-11-05 feat(panel): explain why a preview plan failed instead of a generic message
    The check to the operator's failing point now plans 10 times out of 10, so the earlier failure was
    transient: the point sits 0.56 m from the nearest wall, right at the edge of the 0.48 m inflation
    zone, and a temporary laser mark nearby is enough to make that cell lethal for one planning cycle.
    The failure text now says so: the goal may sit in the inflation area (closer than 0.5 m to a wall)
    or carry a temporary obstacle mark, and suggests picking a point at least 0.6 m from walls or
    retrying after a moment.
2026-11-05 fix(reverse): only reverse when BOTH sides are tight, measured per side
    The reverser merged the left and right front sectors into a single minimum, so a wide right side
    (1.0 m) next to a close left wall (0.3 m) produced 0.3 and was read as 'both sides tight'. That is
    why the robot started backing up at a spot where it clearly had room to turn right, and, because
    the manual channel was used for the manoeuvre, the running navigation mission was aborted as well.
    Side clearance is now computed and reported per side, should_start requires max(left, right) below
    the threshold, and should_stop finishes as soon as either side offers turn_clear_m of room. The
    log line prints both numbers. Regress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
2026-11-05 feat(nav): pause the mission while the robot backs up, and skip a waypoint after two attempts
    Design agreed with the operator: backing out of a tight spot must not kill the mission, but a
    waypoint in a dead end must not loop forever.
    trail_reverser now publishes /reverse/active. While it is true the explorer freezes its state
    machine - no dispatch, no cancel, no failure judgement - so the running mission survives the
    manoeuvre. When it ends the mission continues; a second reverse at the same waypoint also
    continues, and a third one logs '同一个点连续让位 3 次（死胡同）' and skips that waypoint: sequential
    routes advance the leg counter (new skip_leg on the state machine, car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
2026-11-05 fix(nav): resume continues the leg the mission was on, not the nearest pose
    Pausing after finishing a waypoint and pressing resume sent the robot back to that same waypoint:
    the panel rebuilt the route from the pose nearest the robot, and the pose it had just reached is
    the nearest one.
    Route progress now lives in frontier_explorer: stop keeps _fixed_goals/_multi_points and the leg
    index (it only marks the mission suspended), and a new /explore/resume service restarts the state
    machine without resetting that index, so the next leg is exactly the one that was due. The panel
    asks this service first and only falls back to re-sending the route when the node has nothing to
    resume. The reply na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
2026-11-05 fix(nav): resuming a through-poses route redispatches instead of stopping at once
    Panel said '已继续：继续多点路线（剩余 6 点）' and the robot did not move: through-poses runs the
    state machine with legs=1, so after the first dispatch the counter already equals the leg count and
    resume_fixed merely re-enabled it - update() then answered stop and disabled it again in the same
    tick. Resuming now resets the dispatched counter for that mode, so the route is dispatched again.
    Covered by a state-machine test that walks: dispatch, stop mid-route, resume, and asserts the next
    update still returns dispatch.
2026-11-05 docs: session log for v1.6 (localization, map editing, multi-point navigation, stop/resume)
    Records what was changed and verified today, the numbers measured on the real robot, and what is
    still open: the rear ultrasonic in-channels publish nothing (so the reverse-let-turn can never
    trigger), that pause/resume/skip is covered by tests but not yet exercised on the robot, the right
    wheel stall at 14:41, and the still-unexplained straight-line weaving.
2026-11-05 docs: correct the ultrasonic claim - all four rear channels report fine
    My probe subscribed to /ultrasonic_rear/* with std_msgs/Float32 while those topics carry
    sensor_msgs/Range, so it received nothing and I recorded 'no data on left_in/right_in'. Re-read
    with the right type: left_in 0.53 m, right_in 0.38 m, left_out 0.96 m, right_out 0.43 m,
    ultrasonic_rear/status 'link=ok' for every channel and /base/rear_blocked False.
    The '车尾近障：禁止后退' lines were therefore genuine rear_guard hysteresis (blocked below 0.15 m,
    released above 0.45 m), not missing data - the reverse-let-turn feature can trigger once enabled.
2026-11-05 docs(hardware): confirm the GA36Y-555 100:1 motor and specify the 8 mm shaft
    Checks the chosen motor against the 35 kg / 100 mm wheel requirement:
    - 80 RPM no-load = 0.42 m/s, so 0.25 m/s needs only 60 % of no-load speed
    - 1.85 N.m rated vs 1.0 N.m needed; about 3.56 N.m available at 0.25 m/s,
    which covers both cruise (3.6x) and a 2 cm threshold (1.7x)
    - 16 PPR x 100 gives 6400 counts per wheel revolution after x4 decoding
    Shaft: 8 mm, not 6 mm. Each drive wheel carries about 103 N over a 20 mm
    overhang, so bending dominates: 97 MPa on a 6 mm shaft against 41 MPa on 8 mm,
    and the 8.83 N.m stall torque alone reaches 208 MPa torsional shear on 6 mm.
    Also notes the wheel must be carried by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
2026-11-05 test(reverse): simulation harness for the let-turn chain, and two robustness fixes it exposed
    Two scripts drive the real FrontierExplorer object (no hardware, no motion commands) through
    /reverse/active: pause keeps the mission enabled and the leg unchanged, the first two episodes
    resume the same leg, the third skips it, and running out of legs ends the mission cleanly. Both
    the sequential and the through-poses branches behave as specified.
    They refuse to run unless ROS_DOMAIN_ID is set to something other than the default, so they can
    never publish /explore/state into the live robot's graph.
    The simulation also found two rough edges, now fixed: the episode message read '第 3/2 次' (it
    n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
2026-11-05 feat(panel): preview automatically after each point is picked
    Selecting a point disabled the start button and only re-enabled the '重新预览' button, so an
    operator who had just picked a destination saw a greyed-out start and thought the robot ignored
    the selection (exactly the report: '明明我还选了一个目标点'). The click handler now requests the
    preview itself; every click bumps selection_revision, so stale preview results are still dropped.
2026-11-07 fix(nav): treat 'destination near the route start' as a closed loop
    The through-poses goal checker only inspects the last pose, so a route whose destination sits near
    its own start is declared finished as soon as the robot drives past it on the way to the start -
    the recurring report 'I picked a destination near the start and it stopped after a few steps'.
    The dispatcher only compared the destination with the robot's pose; it now also compares it with
    the route's first point and switches to sequential legs in either case, logging both distances.
    [real_viewpoint_planner.yaml]
2026-11-07 fix(nav): retry a failed navigation leg after clearing the costmaps
    The reproduction log ends with 'GridBased: failed to create plan, invalid use: Starting point in
    lethal space!' followed by the BT's six retries and 'Goal failed' - the whole multi-point route was
    then discarded and the robot simply stood still, which matches the operator's 'why did it stop'.
    When a fixed-goal leg fails, the explorer now clears both costmaps and asks the state machine to
    dispatch the same leg again, up to max_stuck_retries (2). A transient lethal mark under the robot
    (a wall grazing the footprint, a stale obstacle mark) is thus recovered instead of ending the
    mission; the counter resets on any successful l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
2026-11-07 fix(nav): never drop the destination when pruning waypoints under the robot
    The reproduction showed the operator's final point being removed: they picked the destination while
    the robot happened to stand next to it (0.2 m), so the near-pruning rule treated it as a zero-length
    lead-in and dropped it - the route then ended at the previous waypoint and, in RViz, the destination
    marker was gone.
    Pruning now applies only to waypoints before the last one; the destination is always kept, and the
    log says so. Closed-loop routes already fall back to sequential legs, which handles a destination
    that sits near the robot's current pose.
2026-11-07 docs: v1.7 - multi-point navigation traps, progress-aware resume, reverse chain
    AGENTS.md keeps only the long-lived facts: the global obstacle layer stays and is cleared while
    idle, the four ways a multi-point route can end early (destination near the robot, destination near
    the route start, first waypoint under the robot, planner failing on a lethal start cell) with their
    parameters, the stop/resume semantics, and the current status of the reverse-let-turn feature
    (disabled by default, tested only in unit tests and the isolated-domain simulation).
    AGENT_LOG has the session detail: every fix, the log paths, what the robot actually reported, and
    what is still open (straight-line weaving, the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
